BruceKe365/STM32F411-PPG-Pulse-Monitor/Reports/总体完成进度（2026.6.23定稿）.md

# 总体完成进度（2026.6.23定稿）

## 给下一个 AI 的快速接手版

项目根目录示例是：

```text
<repo-root>
```

新接手时请先读：

```text
AI助手接手？先读我.md
```

它是根目录总入口，负责说明项目结构、当前状态、关键脚本、数据目录、常用命令和不要乱动的边界。本文件继续作为详细进度存档保留。当前最新同步是下面的 `0C. 2026-06-29 固件参数一致性同步`；具体以 `AI助手接手？先读我.md` 与当前源码、模型和 `full_*_20260629_current` 报告为准。

### 0. 2026-06-09 当前接手状态

当前固件主文件：

```text
Core/Src/main.c
Core/Src/i2c.c
```

后文包含大量历史调参记录；如果旧段落与最新同步冲突，以 `0C. 2026-06-29 固件参数一致性同步`、当前源码和当前脚本为准。

### 0C. 2026-06-29 固件参数一致性同步

这是当前项目最终验收入口。固件行为仍以 2026-06-17 编译的 `main.c`/ELF 为准；2026-06-29 已按固件实际参数重建 Stress 模型并重跑 AF、Stress 验证，纠正旧报告配置与固件不一致的问题。当前模型和报告目录统一使用 `full_*_20260629_current`。

#### 最终验收状态

- 当前版本正式作为验收定稿版本。
- 最终固件源码：`Core/Src/main.c`。
- 最终 ELF：`build/Debug/STM32_F411_Test.elf`。
- 最终功能：HR、SpO2、0.96 寸主屏、0.91 寸 PPG 波形、AF live、Stress、AF test、USB CDC raw/PPG_PROC。
- 最终显示顺序：`HR/SpO2 -> AF live -> STRESS -> AF test -> HR/SpO2`。
- 最终烧录方法：DAPLink + OpenOCD + SWD，目标文件为上述 ELF。
- 最近一次烧录已成功并出现 `Programming Finished`、`Verified OK`、`Resetting Target`。
- 烧录后 COM7 不枚举或打不开时，重插 Black Pill Type-C，不临时修改固件。

#### 最终模型和验证

```text
training_dataset/models/af_nb_model.json
training_dataset/models/af_nb_model.h
training_dataset/models/stress_hrv_model.json
training_dataset/models/stress_hrv_model.h

training_dataset/reports/full_af_validation_20260629_current/
training_dataset/reports/full_stress_live_validation_20260629_current/
training_dataset/reports/full_stress_train_validation_20260629_current/
```

#### 最终关键数据

```text
testing dataset/112_subject_A_pressure_baseline_light_stable_20260617_140429/
testing dataset/113_subject_A_pressure_baseline_light_stable_20260617_141049/
testing dataset/114_subject_B_af_high_review_20260617_144713/
```

#### 验收封版边界

- 不再修改 HR/SpO2 主算法、warmup、心率跳变门限或 OLED 波形。
- 不再修改 AF PPI 门控、20% 上跳保持、10s/30s 刷新或 test PPI。
- 不再修改 Stress 40s 窗口、28 个 PPI、10s/30s 刷新、HR>120 显示门限或模型参数。
- 不再重新训练并覆盖正式 AF/Stress 模型。
- 不再修改、覆盖或重新生成本地采集数据内容；若后续改目录名，必须同步接手文档和数据说明。
- 验收现场只做编译、烧录、接线、串口恢复和功能演示。

#### 验收展示口径

- AF：基于 PPG PPI 不规则性的 AF risk / 不规则心律风险提示，不是房颤确诊。
- Stress：基于 PPG HRV 的 1-99 压力指数，不是情绪类别识别或心理疾病诊断。
- AF/Stress 都是旁路模块，不改变 HR/SpO2 主计算链路。
- 当前项目的价值是“公开数据训练/验证 + PC 等价回放 + STM32 端侧轻量推理 + 双 OLED 实时展示”的完整工程闭环。

### 0B. 2026-06-17 定稿技术同步

这一节是 2026-06-17 的技术基线。旧记录不要删，但如果旧记录和本节冲突，以最前面的 `0C. 2026-06-29 固件参数一致性同步`、`AI助手接手？先读我.md`、当前源码、正式模型和三个 `full_*_20260629_current` 报告为准。

#### 当前项目状态

- 项目已经从 HR/SpO2/OLED 波形显示扩展到两个旁路 AI/算法模块：AF risk 和 Stress index。
- 当前版本可作为阶段定稿版，最近一次烧录成功，OpenOCD 返回 `Programming Finished`、`Verified OK`、`Resetting Target`。
- 烧录后 COM7 有时不会自动重新枚举，重插 Black Pill Type-C 是已知恢复方法。
- 不要为了 AF/Stress 改 HR/SpO2 主算法或 0.91 寸波形归一化；这些是稳定基础功能。

#### 当前显示和串口

按键显示顺序：

```text
HR/SpO2 -> AF live -> STRESS -> AF test -> HR/SpO2
```

当前串口宏：

```text
RAW_STREAM_USB_ENABLE = 1
DIAG_STREAM_USB_ENABLE = 0
PPG_PROC_STREAM_USB_ENABLE = 1
```

含义：

- raw 流输出 `t_ms,red,ir,irq_count,sample_count`。
- `PPG_PROC` 每秒输出处理后诊断字段，包括 HR/SpO2/AF/Stress/PPI 计数和最近 PPI 状态。
- 旧文档里写的 `RAW_STREAM_USB_ENABLE=0`、`DIAG_STREAM_USB_ENABLE=1` 是历史状态。

#### HR/SpO2 当前策略

```text
PPG_HR_WARMUP_SAMPLES = 1500       # 15s
PPG_SPO2_WARMUP_SAMPLES = 2000     # 20s
PPG_AUTOCORR_INTERVAL_SAMPLES = 100 # 约 1s
PPG_HR_CONFIRM_SAMPLES = 3
PPG_HR_CONFIRM_TOLERANCE_BPM = 12
PPG_HR_MAX_DISPLAY_JUMP_BPM = 25
PPG_HR_JUMP_ACCEPT_TIMEOUT_MS = 10000
```

心率首次显示需要 3 个候选一致；显示值使用最近 5 个心率中位数。单次跳变超过 25 bpm 时保持旧值，持续 10s 才接受。血氧 20s warmup 后按滚动 PPG 窗口计算。

#### AF 当前策略

AF 方法：PPG robust peak -> PPI -> HRV/不规则节律特征 -> 离散朴素贝叶斯 -> 0-100% AF risk。

```text
AF_MIN_PPI_COUNT = 20
AF_WINDOW_TARGET_MS = 30000
AF_RISK_FAST_STEP_MS = 10000
AF_RISK_SLOW_STEP_MS = 30000
AF_STABLE_RISK_THRESHOLD_PERCENT = 20
AF_MAX_UP_JUMP_PERCENT = 20
PPG_PPI_QUALITY_MAX_REJECT_PCT = 20
```

当前 live AF 行为：

- 未出值或当前风险 >=20% 时每 10s 尝试更新。
- 当前风险 <20% 后每 30s 尝试更新。
- PPI 异常比例超过 20%、窗口不足、PPI 推算 HR 与当前 HR 差异 >18 bpm 时保持旧值。
- 新风险比旧风险上跳超过 20% 时保持旧值；下降不拦截。
- AF test 只播放内置 AFDB `06995` PPI 段，不使用 live 稳定策略。

#### Stress 当前策略

Stress 方法：PPG robust peak -> PPI -> HRV 特征 -> Logistic Regression -> 1-99 stress index。

```text
STRESS_HRV_MIN_INTERVAL_COUNT = 28
STRESS_HRV_WINDOW_TARGET_MS = 40000
STRESS_HRV_FIRST_STEP_MS = 10000
STRESS_HRV_REFRESH_STEP_MS = 30000
STRESS_HRV_HIGH_HR_BPM = 120
```

当前 Stress 行为：

- 首次未出值时每 10s 尝试更新。
- 出值后每 30s 尝试更新。
- HR >120 bpm 时 STRESS 第二行显示 `-- high HR`，后台仍计算，显示层当作暂无可参考压力值。
- 档位：`1-29 relax`、`30-59 normal`、`60-79 medium`、`80-99 high`。

#### 当前验证报告

优先看这些目录：

```text
training_dataset/reports/full_af_validation_20260629_current/
training_dataset/reports/full_stress_live_validation_20260629_current/
training_dataset/reports/full_stress_train_validation_20260629_current/
```

关键结果：

```text
AF local_ppg normal: valid=33/292, median=0%, mean=3.212%, ge80=3.030%
AF public_nsr2db normal: ge80=0.016%
AF public_afdb normal: ge80=0.279%
AF public_ltafdb normal: ge80=0.685%
AF public_afdb af: ge80=36.892%
AF public_ltafdb af: ge80=45.550%

Stress WESAD all: AUC=0.9267, nonstress_median=50, stress_median=87
Stress WESAD test_by_subject: AUC=0.9157, nonstress_median=51, stress_median=87
Stress local live: files=130, displayed=25/52, display_median=48, display_max=53
```

#### 新增本地数据

```text
testing dataset/112_subject_A_pressure_baseline_light_stable_20260617_140429/
testing dataset/113_subject_A_pressure_baseline_light_stable_20260617_141049/
testing dataset/114_subject_B_af_high_review_20260617_144713/
```

- `112` 和 `113` 是subject_A稳定轻触压力基线。
- `114` 是subject_B AF 偶发高值排查采集，用来验证 PPI 假峰、artifact gate 和 AF jump hold。
- 这些都是本地正常/边界硬件采集，不是真实 AF 阳性样本，也不是压力训练标签数据。

### 0A. 2026-06-16 历史接手同步

这一节是 2026-06-16 的历史同步。旧记录不要删，但如果旧记录和本节冲突，以最前面的 `0C. 2026-06-29 固件参数一致性同步`、`AI助手接手？先读我.md`、当前源码、正式模型和三个 `full_*_20260629_current` 报告为准。

#### 当前项目状态

- 项目已经从单纯 HR/SpO2/OLED 波形显示，扩展到“基于 PPG 峰间期 PPI 的疑似房颤风险原型”。
- HR/SpO2 主算法、小屏 0.91 寸波形显示逻辑仍然是稳定基础功能，后续不要为了 AF 功能去重写它们。
- AF 功能当前已经移植进 `Core/Src/main.c`，是旁路模块：从现有 PPG 峰值/心率/血氧有效状态拿数据，不应反向影响 HR/SpO2。
- 当前固件串口默认仍是诊断 CSV：`RAW_STREAM_USB_ENABLE=0`，`DIAG_STREAM_USB_ENABLE=1`。原始 red/ir 输出代码保留，但需要时才打开。
- 当前 I2C 速率仍应保持：`I2C1=400 kHz` 大屏，`I2C2=400 kHz` 小屏，`I2C3=100 kHz` MAX30102。CubeMX 重新生成后必须复查 `Core/Src/i2c.c`。

#### 当前固件 AF 行为

按键使用 PA0 轮询，不依赖 CubeMX 外部中断。显示模式循环：

1. 默认：大屏显示心率/血氧，小屏显示 Pause/Loading/波形。
2. 按一次：大屏显示实时传感器来源的 `AF %`。
3. 再按一次：大屏显示 `[test]` 和 `AF %`，来源切换为内置 AFDB PPI 测试段。
4. 再按一次：回到心率/血氧显示。

live AF 只在这些条件都满足后才开始收 PPI 并计算：

```text
finger_present != 0
ppg_signal_valid != 0
heart_rate_bpm > 0
spo2_percent > 0
```

当前 MCU 端 AF 参数：

```text
AF_WINDOW_TARGET_MS = 30000
AF_RISK_STEP_MS = 10000
AF_MIN_PPI_COUNT = 20
AF_MAX_PPI_COUNT = 100
AF_LIVE_HR_TOLERANCE_BPM = 18.0
```

也就是说，live 模式需要心率/血氧先稳定，再累计最近约 30 秒 PPI，之后每 10 秒刷新一次风险。若 PPI 窗口推算出的 HR 和当前 HR 差异超过 18 bpm，则显示 `--`。

test 模式内置的是 AFDB `06995` 的一段 AF rhythm PPI/RR 间期，不是写死的 85%。进入 test 后需要按 PPI 间隔播放，窗口满约 30.244 秒后才会计算出约 85% 风险。

#### 当前 Python 脚本职责

根目录 Python 脚本开头已经补了中文说明。快速记忆如下：

| 文件 | 当前用途 |
| --- | --- |
| `scripts/download_af_training_data.py` | 从 PhysioNet 下载最小注释文件，放到 `training_dataset/physionet/`。只下 `.hea/.atr/.qrs/.ecg`，不下大体积 `.dat`。 |
| `scripts/train_af_naive_bayes.py` | 训练 PPI/RR 间期特征的离散朴素贝叶斯 AF 风险模型，导出 JSON 和 C 参数。 |
| `scripts/simulate_af_ppi_risk.py` | 生成正常、轻度不规则、AF-like、早搏样等模拟 PPI，检查模型行为是否符合直觉。 |
| `scripts/validate_mcu_af_live.py` | 最关键的验证脚本。电脑端复刻 MCU live/test AF 逻辑，跑本地 PPG、内置 test 段、公开数据集和质量门控实验。 |
| `scripts/read_max30102_raw.py` | 读取 STM32 USB CDC 原始 MAX30102 red/ir CSV，主要用于 raw 模式采样。 |
| `scripts/read_serial_diagnostics.py` | 读取当前诊断 CSV，检查主循环、采样、OLED、CDC 是否卡顿。 |
| `scripts/build_pulse_report_docx.py` | 项目汇报 Word 生成辅助脚本，和 AF 模型训练/固件运行无直接关系。 |

#### 训练数据和标签口径

数据目录：`training_dataset/physionet/`

| 数据集 | 当前用途 | 标签口径 |
| --- | --- | --- |
| `afdb/1.0.0` | 训练和验证 | `.atr` 节律标注给 AF/normal/mixed，`.qrs` 给 beat time。 |
| `ltafdb/1.0.0` | 训练和验证 | `.atr` 同时提供 beat/rhythm，长时 AF/非 AF 流式验证。 |
| `nsr2db/1.0.0` | 训练和正常验证 | `.ecg` RR 注释，整库按 normal 处理。 |
| `mitdb/1.0.0` | 额外泛化验证，不参与当前训练 | `.atr` 节律/beat 注释，含 AF/normal/other/mixed。 |
| `nsrdb/1.0.0` | 额外正常泛化验证，不参与当前训练 | `.atr` 注释，整库按 normal 处理。 |

重要限制：这些公开 AF 数据主要来自 ECG 标注，但模型只使用 RR/PPI 间期统计，不使用 ECG 波形形态。它验证的是“节律不规则风险”，不能说成医疗级房颤诊断。

#### 当前验证结论

当前模型和 MCU 等价逻辑总体能区分稳定正常和明显 AF-like 不规则：

- 本地正常 PPG：`local_ppg` 有效显示点风险为 0%。
- MCU test 内置 AFDB 06995：约 30.244 秒后风险为 85%。
- 当前 MCU 流式显示报告合并 AFDB/LTAFDB/NSR2DB，按 `risk >= 80%` 看有效显示点：AF 标签 45.146%，normal 标签 0.258%，mixed 标签 7.596%，other 标签 18.981%。
- 同一报告中的原始窗口质量门控基线不是流式显示结果：AF 窗口 95.664%，normal 窗口 0.287%。两种统计不可混用。

质量门控实验已经在 `scripts/validate_mcu_af_live.py --quality-gate-experiment` 里合并，不再需要单独新脚本。当前候选结论：

- 不建议强行缩放或压低 live AF 概率，那会让真实 AF 展示变假。
- 更合理的方向是“质量不可信就显示 `--`”，不是把概率硬改低。
- 候选方案 `outlier_frac_gt18pct`：按全部原始窗口统计，normal 高风险从 0.287% 降到 0.192%，AF 高风险从 95.664% 降到 93.117%。
- 候选方案 `artifact_mild`：normal 高风险为 0.145%，AF 高风险为 92.751%。
- 目前这些质量门控只在电脑端验证过，尚未移植进 MCU。

#### 后续最推荐做的事

1. 不要再随意改 HR/SpO2 和小屏波形。
2. 如果继续优化 AF，优先把电脑端验证过的“质量门控显示 `--`”移植到 MCU，而不是硬压概率。
3. 如果拿到真实 AF 患者 PPG，优先做离线验证，再决定是否重训模型。
4. 对老师展示时说“基于 PPI 不规则性的疑似房颤风险原型”，不要说“确诊房颤”。

当前最重要状态：

- HR/SpO2 核心算法已经阶段性定稿，后续不要轻易改动成熟的心率/血氧计算逻辑，除非用户明确要求。
- 固件当前 HR warmup 是 `1500` 个样本，约 `15s`；SpO2 warmup 是 `2000` 个样本，约 `20s`。
- 心率自相关已经移到后台分片任务 `PPG_AutocorrService()`，不是在 MAX30102 外部中断里做重计算；这样可以减少主循环长时间阻塞。
- 0.91 寸小屏有独立波形/状态模块：无手指且无残留波形显示 `Pause`，有手指但 HR 未稳定时显示 `Loading...` 动画，稳定后显示波形。
- 0.91 寸小屏波形卡顿的核心原因已定位为 OLED I2C 总线速率曾停留在默认 `100 kHz`，不是 HR/SpO2 算法问题。
- 当前 `Core/Src/i2c.c` 生效速率：`I2C1=400000` 给 0.96 寸大屏，`I2C2=400000` 给 0.91 寸小屏，`I2C3=100000` 给 MAX30102。
- CMake 文件不保存外设速率，只编译 `Core/Src/i2c.c`。如果 CubeMX/STM32Cube 插件重新生成代码，必须重新检查三处 `hi2c*.Init.ClockSpeed`。
- 当前 USB CDC 模式是诊断输出：`RAW_STREAM_USB_ENABLE=0`、`DIAG_STREAM_USB_ENABLE=1`。原始 `t_ms,red,ir,irq_count,sample_count` 输出代码仍保留，需要原始数据时再切回 raw 模式。
- 烧录或 OpenOCD reset 后，Windows 的 `COM7` 可能卡住；这已经作为已知现象处理，重新插拔黑丸 Type-C 通常恢复。
- 用户偏好：后续如果修改固件，编译通过后可以直接烧录；但算法开发阶段优先 PC 端脚本/回放，少烧录。
- 后续升级想法：在不改动成熟 HR/SpO2 主算法的前提下，新增独立的“疑似房颤风险筛查”模块。推荐路线是 PC 端用公开数据集训练朴素贝叶斯概率参数，MCU 端基于 PPG 脉搏间期特征做轻量推理，只输出风险提示，不做医学诊断。

当前工程已经验证可用的流程是：先编译，再用 DAPLink + OpenOCD 烧录 `build\Debug\STM32_F411_Test.elf`。

### 1. 编译

```powershell
& '%LOCALAPPDATA%\stm32cube\bundles\cmake\4.3.1+st.1\bin\cmake.exe' --build build\Debug
```

编译成功后应生成：

```text
build\Debug\STM32_F411_Test.elf
```

### 2. 烧录

如果之前开过 OpenOCD/GDB，先关掉：

```powershell
Get-Process openocd,arm-none-eabi-gdb -ErrorAction SilentlyContinue | Stop-Process -Force
```

然后烧录：

```powershell
& 'tools\xpack-openocd-0.12.0-7\bin\openocd.exe' -s 'tools\xpack-openocd-0.12.0-7\openocd\scripts' -f interface\cmsis-dap.cfg -f target\stm32f4x.cfg -c 'adapter speed 1000; program build/Debug/STM32_F411_Test.elf verify reset exit'
```

看到下面几行就表示烧录成功：

```text
** Programming Finished **
** Verified OK **
** Resetting Target **
```

### 3. 观察调试输出

当前代码支持通过 DAPLink/OpenOCD semihosting 看低频调试输出：

```powershell
& 'tools\xpack-openocd-0.12.0-7\bin\openocd.exe' -s 'tools\xpack-openocd-0.12.0-7\openocd\scripts' -f interface\cmsis-dap.cfg -f target\stm32f4x.cfg -c 'adapter speed 1000; init; arm semihosting enable; reset run; sleep 14000; shutdown'
```

注意：semihosting 只适合低频日志。后续要采集 MAX30102 原始 red/ir 数据，应改用 USB CDC 虚拟串口输出 CSV，再用 MATLAB 读取。

## 当前推荐连接方式：DAPLink 烧录 + Type-C 串口数据

后续建议使用“两条 USB 链路”：

1. DAPLink 只负责 SWD 烧录/调试。
2. 黑丸自身 Type-C 负责给板子供电，并通过 USB CDC 虚拟串口向电脑输出数据。

当前已验证的接法：

| 连接 | 当前状态 |
| --- | --- |
| DAPLink `GND` -> 黑丸 `GND` | 已验证可用 |
| DAPLink `CK/TCK` -> 黑丸 `SCK/SWCLK` | 已验证可用 |
| DAPLink `IO/TMS` -> 黑丸 `DIO/SWDIO` | 已验证可用 |
| DAPLink `3V3` -> 黑丸 `3V3` | 当前不接 |
| 黑丸 Type-C -> 电脑 USB | 当前用于供电 + USB CDC 数据传输 |

重要结论：

- DAPLink 断开 `3V3`，只接 `GND`、`SWCLK`、`SWDIO` 三根线时，OpenOCD 仍能识别 STM32F411。
- 在这种三线 SWD 接法下，已经重新烧录并 `Verified OK`。
- 黑丸 Type-C 直连电脑后，USB CDC 枚举为 `COM7`。
- 当前程序已经能通过 `COM7` 输出文本数据。

已验证的 OpenOCD 结果：

```text
CMSIS-DAP: Interface Initialised (SWD)
SWD DPIDR 0x2ba01477
[stm32f4x.cpu] Cortex-M4 r0p1 processor detected
** Programming Finished **
** Verified OK **
```

已验证的串口信息：

```text
VID_0483&PID_5740
USB 串行设备 (COM7)
```

当前 `COM7` 能读到的程序输出示例：

```text
PPG finger=0 valid=0 red=353 ir=307 amp=0 hr=-1 spo2=-1 irq=12766 samples=16023
PPG finger=1 valid=0 red=57582 ir=66443 amp=113 hr=94 spo2=-1 irq=13477 samples=16923
PPG finger=0 valid=0 red=522 ir=420 amp=0 hr=-1 spo2=-1 irq=13557 samples=17023
```

注意：

- 这说明 USB CDC 链路已经通了。
- 当前输出还是调试日志格式，不适合 MATLAB 长时间读取和解析。
- 后续应改成干净 CSV 格式。

推荐后续 CSV 格式：

```text
t_ms,red,ir
12345,57582,66443
```

如果还需要保留状态字段，可用扩展格式：

```text
t_ms,red,ir,amp,finger,valid,hr,spo2,irq_count,sample_count
12345,57582,66443,113,1,0,94,-1,13477,16923
```

MATLAB 侧应优先打开：

```text
COM7
```

波特率对 USB CDC 通常不是实际物理速率，但为了兼容串口 API，建议先用：

```text
115200, 8N1
```

### 拓展坞影响记录

之前黑丸 Type-C 通过拓展坞连接电脑时，能看到 `COM7` 枚举，但打开/读取不稳定，出现过：

```text
Device COM7 is not currently available.
```

改成黑丸 Type-C 直连电脑后：

- `mode COM7` 正常返回状态。
- PowerShell 能打开 `COM7`。
- 能读到 `PPG ...` 文本输出。

因此后续采集 MAX30102 高频原始数据时，建议：

- 黑丸 Type-C 尽量直连电脑，不要走拓展坞。
- DAPLink 可以接电脑或拓展坞，用于烧录/调试。
- 不要同时让 DAPLink `3V3` 和黑丸 Type-C 给板子供电。

## 硬件和引脚配置详细交接

### 核心板与供电/下载

| 项目 | 当前状态 |
| --- | --- |
| 核心板 | STM32F411CEU6 黑丸核心板 |
| 外部晶振 | HSE 25 MHz |
| 系统主频 | SYSCLK 96 MHz |
| USB 时钟 | 48 MHz |
| 下载/调试 | DAPLink，SWD 模式 |
| BOOT0 | 正常运行/烧录时保持普通启动状态，不需要按 BOOT0 |
| NRST | 复位键，需要时短按即可 |
| KEY | 当前项目未使用 |

### DAPLink 到黑丸 SWD 接线

| DAPLink 引脚 | 黑丸引脚 | 说明 |
| --- | --- | --- |
| `CK/TCK` | `SCK` / `SWCLK` | SWD 时钟 |
| `IO/TMS` | `DIO` / `SWDIO` | SWD 数据 |
| `GND` | `GND` | 必须共地 |
| `3V3` | `3V3` | 当前不接；黑丸 Type-C 负责供电 + USB CDC |

当前已经验证：DAPLink 可以识别目标芯片，可以烧录和 verify。OpenOCD 日志里能看到 `Cortex-M4`、`flash size = 512 KiB`、`Verified OK`。

### I2C 与传感器/OLED 接线

| 外设 | STM32 外设 | SCL | SDA | 7-bit 地址 | 备注 |
| --- | --- | --- | --- | --- | --- |
| 0.96 寸 SSD1306 OLED | I2C1 | `PB6` | `PB7` | `0x3C` | 128x64，供电 3.3V，模块自带上拉 |
| 0.91 寸 SSD1306 OLED | I2C2 | `PB10` | `PB3` | `0x3C` | 128x32，供电 3.3V，模块自带上拉 |
| MAX30102 | I2C3 | `PA8` | `PB4` | `0x57` | 供电 3.3V，模块自带上拉 |

CubeMX/HAL 当前 I2C 配置：

| 外设 | 速率 | 地址模式 | GPIO 模式 |
| --- | --- | --- | --- |
| I2C1 | 400 kHz | 7-bit | AF Open-Drain |
| I2C2 | 400 kHz | 7-bit | AF Open-Drain |
| I2C3 | 100 kHz | 7-bit | AF Open-Drain |

重要速率记忆：

- `I2C1` 是 0.96 寸 128x64 SSD1306 大屏，当前必须保持 `400 kHz`，否则大屏整屏刷新会明显拖慢主循环。
- `I2C2` 是 0.91 寸 128x32 SSD1306 小屏，当前必须保持 `400 kHz`，否则心率波形会出现走一段、顿一下的卡顿。
- `I2C3` 是 MAX30102，当前仍保持 `100 kHz`，不要为了屏幕刷新把传感器总线一起改掉。
- 当前 CMake 文件不保存这些外设速率。实际生效位置是 `Core/Src/i2c.c` 里的 `hi2c1.Init.ClockSpeed`、`hi2c2.Init.ClockSpeed`、`hi2c3.Init.ClockSpeed`。
- `cmake/stm32cubemx/CMakeLists.txt` 只是把 `Core/Src/i2c.c` 加入编译；如果以后 CubeMX 或 STM32Cube 插件重新生成 `i2c.c`，必须重新确认 `I2C1/I2C2=400000`、`I2C3=100000`。

注意：HAL 的 I2C API 使用地址时需要左移一位，例如 MAX30102 `0x57 << 1`，SSD1306 `0x3C << 1`。

### MAX30102 中断引脚

| MAX30102 引脚 | STM32 引脚 | CubeMX 配置 | 说明 |
| --- | --- | --- | --- |
| `INT` | `PB5` | `GPIO_MODE_IT_FALLING` + `GPIO_PULLUP` | FIFO/PPG 数据准备好时传感器拉低，走 EXTI9_5 中断 |

代码里 `HAL_GPIO_EXTI_Callback(GPIO_PIN_5)` 会置位 `max30102_int_pending`，主循环里再调用 `MAX30102_Service()` 读取 FIFO。当前已验证 `irq` 计数会增长，说明 PB5 中断链路是通的。

### USB CDC

| 引脚/外设 | 当前状态 |
| --- | --- |
| USB FS DM | `PA11` |
| USB FS DP | `PA12` |
| USB_DEVICE | CDC FS 已启用 |
| 用途 | 后续计划输出 MAX30102 原始 red/ir CSV 数据到电脑 |

当前项目里 `CDC_Printf()` 同时会尝试走 USB CDC 和 semihosting。没有连接黑丸 Type-C 时，仍可通过 DAPLink semihosting 看低频日志。后续做 MATLAB 原始数据采集时，应连接黑丸 Type-C，让电脑识别 USB CDC 虚拟串口。

### SWD 保留引脚

| STM32 引脚 | 用途 |
| --- | --- |
| `PA13` | SWDIO |
| `PA14` | SWCLK |

不要把 `PA13/PA14` 改作普通 GPIO，否则 DAPLink 调试/烧录会受影响。

### 当前 MAX30102 寄存器配置

代码位置：`Core/Src/main.c` 的 `MAX30102_InitSensor()`。

| 寄存器 | 当前写入值 | 作用 |
| --- | --- | --- |
| `MODE_CONFIG` | `0x40` 后等待清零 | 软复位 |
| `INTR_ENABLE_1` | `0x40` | 开启 PPG_RDY 中断 |
| `INTR_ENABLE_2` | `0x00` | 关闭第二组中断 |
| `FIFO_CONFIG` | `0x10` | sample average = 1，FIFO rollover enabled |
| `SPO2_CONFIG` | `0x47` | 当前 SpO2/ADC/采样配置，目标约 100 Hz |
| `LED1_PA` | `0x24` | 红光 LED 电流 |
| `LED2_PA` | `0x24` | 红外 LED 电流 |
| `PILOT_PA` | `0x1F` | Pilot LED 电流 |
| `MODE_CONFIG` | `0x03` | SpO2 mode，红光 + 红外 |

这些参数不是最终算法参数。当前更建议先把原始 red/ir 数据导出到 MATLAB 观察，再决定 LED 电流、ADC 量程、滤波和峰值检测阈值。

### 当前代码模块概览

| 文件 | 当前作用 |
| --- | --- |
| `Core/Src/main.c` | I2C 扫描、OLED 驱动、MAX30102 初始化/读取、PPG 初版算法、semihosting/CDC 输出 |
| `Core/Src/i2c.c` | CubeMX 生成的 I2C1/I2C2/I2C3 初始化 |
| `Core/Src/gpio.c` | PB5 EXTI 下降沿中断配置 |
| `USB_DEVICE/App/usbd_cdc_if.c` | USB CDC 接口，已加过端口打开判断和空指针保护 |
| `.vscode/launch.json` | Cortex-Debug + DAPLink/OpenOCD 调试配置 |

## 项目与硬件状态

- 主控：STM32F411CEU6 黑丸核心板。
- 工程目录：clone 后的仓库根目录 `<repo-root>`
- 开发环境：VS Code + STM32Cube for VS Code 插件 + CMake/Ninja + GNU Arm 工具链。
- HSE：25 MHz。
- SYSCLK：96 MHz。
- USB 时钟：48 MHz。
- 调试/烧录器：DAPLink，走 SWD。
- 当前主要代码文件：`Core/Src/main.c`
- USB CDC 相关文件：`USB_DEVICE/App/usbd_cdc_if.c`

## 外设连接

- I2C1 `PB6/PB7`：0.96 寸 SSD1306 OLED，地址 `0x3C`。
- I2C2 `PB10/PB3`：0.91 寸 SSD1306 OLED，地址 `0x3C`。
- I2C3 `PA8/PB4`：MAX30102，地址 `0x57`。
- PB5：MAX30102 `INT` 引脚，下降沿触发，内部上拉。
- SWD：
  - DAPLink `CK/TCK` -> 黑丸 `SCK/SWCLK`
  - DAPLink `IO/TMS` -> 黑丸 `DIO/SWDIO`
  - DAPLink `GND` -> 黑丸 `GND`
  - DAPLink `3V3` -> 黑丸 `3V3`
- 使用 DAPLink/SWD 烧录时，BOOT0 保持正常启动模式即可，不需要进入系统 Bootloader。

## 今天已搞定的编译与烧录流程

### 1. 编译

使用 STM32Cube 插件 Bundles Manager 里的 CMake：

```powershell
& '%LOCALAPPDATA%\stm32cube\bundles\cmake\4.3.1+st.1\bin\cmake.exe' --build build\Debug
```

编译成功后生成：

```text
build\Debug\STM32_F411_Test.elf
```

`.elf` 是正确产物，DAPLink + OpenOCD 可以直接烧录这个 ELF。

### 2. OpenOCD 路径

项目里已经放好了 xPack OpenOCD：

```text
tools\xpack-openocd-0.12.0-7\bin\openocd.exe
tools\xpack-openocd-0.12.0-7\openocd\scripts
```

### 3. 烧录前先关掉旧的 OpenOCD/GDB

如果之前开过调试或观察窗口，先执行：

```powershell
Get-Process openocd,arm-none-eabi-gdb -ErrorAction SilentlyContinue | Stop-Process -Force
```

这个命令如果没有找到进程，返回非 0 也没关系。

### 4. DAPLink 烧录命令

```powershell
& 'tools\xpack-openocd-0.12.0-7\bin\openocd.exe' -s 'tools\xpack-openocd-0.12.0-7\openocd\scripts' -f interface\cmsis-dap.cfg -f target\stm32f4x.cfg -c 'adapter speed 1000; program build/Debug/STM32_F411_Test.elf verify reset exit'
```

成功标志：

```text
** Programming Finished **
** Verified OK **
** Resetting Target **
```

### 5. 通过 DAPLink/OpenOCD 观察 semihosting 输出

当前代码里 `CDC_Printf()` 同时会走 semihosting，所以不用接目标板 Type-C，也能通过 DAPLink/OpenOCD 看到调试输出。

```powershell
& 'tools\xpack-openocd-0.12.0-7\bin\openocd.exe' -s 'tools\xpack-openocd-0.12.0-7\openocd\scripts' -f interface\cmsis-dap.cfg -f target\stm32f4x.cfg -c 'adapter speed 1000; init; arm semihosting enable; reset run; sleep 14000; shutdown'
```

注意：semihosting 适合低频调试信息，不适合长时间高频传感器原始数据流。后续要做高频原始数据采集，应该改成 USB CDC 虚拟串口或指定硬件 USART。

## VS Code 调试配置

当前 `.vscode/launch.json` 已配置 DAPLink + OpenOCD，大致用途是让 Cortex-Debug 通过 OpenOCD 调试/下载 ELF。

关键配置：

- `servertype`: `openocd`
- `configFiles`:
  - `interface/cmsis-dap.cfg`
  - `target/stm32f4x.cfg`
- `executable`: `build/Debug/STM32_F411_Test.elf`
- `gdbPath`:

```text
${env:LOCALAPPDATA}/stm32cube/bundles/gnu-tools-for-stm32/14.3.1+st.2/bin/arm-none-eabi-gdb.exe
```

如果 VS Code 图形界面调试按钮不好用，可以优先使用上面的 PowerShell 编译/烧录命令。

## 当前功能进展

已经实现过的内容：

- 启动时扫描 I2C1/I2C2/I2C3。
- 已确认设备地址：
  - I2C1 OLED：`0x3C`
  - I2C2 OLED：`0x3C`
  - I2C3 MAX30102：`0x57`
- 两块 OLED 可以初始化和显示内容。
- 128x64 OLED 当前用于显示 `bpm:` 和 `SpO2:`，原右上角心形图标已删除。
- MAX30102 初始化成功。
- PB5 硬件中断已工作，日志里 `irq` 会持续增长。
- MAX30102 FIFO 样本读取已工作，日志里 `samples` 会持续增长。
- 当前日志格式示例：

```text
PPG finger=0 valid=0 red=391 ir=305 amp=0 hr=-1 spo2=-1 irq=3 samples=8
```

## 当前遗留问题

MAX30102 的心率/血氧算法仍不稳定。

已遇到两类问题：

- 阈值太低时：没有手指也可能被环境反射或噪声误判，OLED 会错误显示心率血氧。
- 阈值太高时：手指放上去后一直不显示心率和血氧。

当前代码已经加了：

- `finger_present`：判断是否可能有手指。
- `ppg_signal_valid`：判断是否有可信 PPG 波形。
- 只有 `finger_present == 1` 且 `ppg_signal_valid == 1` 时才显示心率血氧。

但实际表现仍然需要重新调参，当前用户反馈是：手指放上去一直不显示，说明有效波形门槛可能又调得偏高。

## 明天/后续开发思路

下一步不要急着在单片机上继续盲调心率和血氧算法。

建议路线：

1. 让 STM32 只负责稳定读取 MAX30102 FIFO 原始数据。
2. 通过串口持续输出原始数据到电脑。
3. 在电脑端用 MATLAB 读取/保存/画图/调算法。
4. 先在 MATLAB 里确定滤波、峰值检测、阈值、SpO2 ratio 参数。
5. 参数稳定后，再把算法移植回 STM32。

推荐先输出 CSV 格式：

```text
t_ms,red,ir,irq_count,sample_count
12345,60123,70456,100,1000
```

如果还要带当前 MCU 算法状态，可以扩展为：

```text
t_ms,red,ir,amp,finger,valid,hr,spo2,irq_count,sample_count
```

## 串口输出方案建议

优先方案：USB CDC 虚拟串口。

- 优点：速率高，适合输出 MAX30102 原始 red/ir 数据流。
- 需要连接黑丸自身 Type-C 到电脑。
- MATLAB 可以通过串口对象读取。

备选方案：硬件 USART。

- 需要后续指定 TX/RX 引脚和 USB-TTL 模块。
- 当前硬件连接信息里还没有指定 USART 引脚。

不推荐用 semihosting 做高频数据流：

- semihosting 依赖调试器，速度慢。
- 适合启动日志、I2C 扫描、少量状态输出。
- 不适合 100 Hz 原始 PPG 数据长期采集。

## 明天建议先做的代码改动

1. 暂时弱化或关闭 OLED 心率/血氧算法显示。
2. 保留 OLED 显示基本状态，比如：
   - MAX30102 OK
   - Streaming
   - sample count
3. 在 `MAX30102_Service()` 中每读到一个样本，就通过 USB CDC 输出 CSV。
4. 控制输出频率：
   - MAX30102 当前配置约 100 Hz。
   - 每个样本输出一行 CSV。
5. MATLAB 侧先画：
   - raw IR
   - raw RED
   - 去 DC 后 AC 波形
   - 滤波后波形
   - 检测到的峰值点

## 对后续 AI 的提示

如果后续新建对话，请先阅读本文件。

本项目目前最关键的不是继续猜阈值，而是先把 MAX30102 原始数据稳定导出到 PC，在 MATLAB 中观察真实波形后再调参。编译和烧录已经验证可用，优先使用本文档中的 PowerShell 命令。

## 2026-05-27 晚间追加：切换为 PC 端原始数据处理路线

### 固件改动

`Core/Src/main.c` 已改为：

- Type-C USB CDC 只输出 MAX30102 原始 CSV 数据。
- CSV 格式：

```text
t_ms,red,ir,irq_count,sample_count
12345,57582,66443,13477,16923
```

- 原来的 I2C 扫描、MAX30102 初始化、PPG 状态日志仍保留，但默认只走 OpenOCD semihosting，不再混入 Type-C 串口数据。
- `MAX30102_Service()` 当前只读 FIFO 原始 red/ir 并输出，不再调用 MCU 端 `PPG_ProcessSample()` 做心率/血氧算法处理。
- 编译已通过：

```text
[1/2] Building C object CMakeFiles/STM32_F411_Test.dir/Core/Src/main.c.obj
[2/2] Linking C executable STM32_F411_Test.elf
```

- 新固件已经烧录并 `Verified OK`。

### PC 端 Python 脚本

项目根目录新增：

```text
scripts/read_max30102_raw.py
```

用途：

- 自动或手动打开 STM32 USB CDC 串口。
- 读取 `t_ms,red,ir,irq_count,sample_count` CSV。
- 保存原始数据到 `ppg_raw_YYYYMMDD_HHMMSS.csv`。
- 用滚动窗口做初版 PC 端心率/血氧估算，参数可通过命令行调。

推荐运行：

```powershell
python scripts/read_max30102_raw.py --port COM7
```

短时间测试：

```powershell
python scripts/read_max30102_raw.py --port COM7 --duration 20 --csv ppg_raw_test.csv
```

已安装 Python 依赖：

```powershell
python -m pip install pyserial
```

脚本参数可查看：

```powershell
python scripts/read_max30102_raw.py --help
```

### VS Code / MATLAB 状态

当前 VS Code 已安装 Python、Pylance、Jupyter 等扩展，但未安装 MATLAB 相关扩展。

短期建议先用 Python 采集和调参；如果后续要在 VS Code 里写 MATLAB，可再安装 MathWorks 的 MATLAB 扩展。

### 当前注意事项

烧录新固件后，Windows 仍枚举到：

```text
COM6: DAPLink, VID_0D28&PID_0204
COM7: STM32 USB CDC, VID_0483&PID_5740
```

但一次脚本读取测试时，`COM7` 打开动作出现卡住，`ppg_raw_test.csv` 为空。OpenOCD semihosting 验证新固件仍能启动、扫描 I2C、初始化 MAX30102，并继续读到样本。

如果再次遇到 `COM7` 打不开或卡住，优先处理：

- 关闭 VS Code Serial Monitor、MATLAB、串口助手等可能占用 `COM7` 的程序。
- 重新插拔黑丸 Type-C，尽量直连电脑，不走拓展坞。
- 确认 `COM7` 仍是 `VID_0483&PID_5740`。

### 进一步修复和验证记录

发现一个 CDC 状态问题：

- 之前 `CDC_SET_CONTROL_LINE_STATE` 不区分主机打开/关闭端口，收到一次控制请求后就永久把 `cdc_port_open_fs` 置为 1。
- 这会导致 Python 脚本退出后，MCU 仍可能认为端口打开并持续向 USB CDC 发送数据。
- 已修复为读取 CDC 请求里的 DTR 位：DTR=1 才认为端口打开，DTR=0 则停止发送。
- Python 脚本退出时也会主动拉低 DTR/RTS，再关闭串口。

新增可见固件标记：

```text
FW_TAG=RAW_CSV_DTR_V2
```

0.91 寸 OLED 启动文本改为：

```text
raw v2
```

已重新编译、烧录并 verify：

```text
** Programming Finished **
** Verified OK **
```

OpenOCD semihosting 已验证目标板实际运行新固件，输出包含：

```text
FW_TAG=RAW_CSV_DTR_V2
I2C1 OLED 0.96 SSD1306 @0x3C: OK
I2C2 OLED 0.91 SSD1306 @0x3C: OK
I2C3 MAX30102 @0x57: OK
MAX30102 init: OK
```

连续运行 Python 脚本两次验证通过，不需要重新拔插：

```powershell
python scripts/read_max30102_raw.py --port COM7 --duration 6 --csv ppg_raw_repeat1.csv
python scripts/read_max30102_raw.py --port COM7 --duration 6 --csv ppg_raw_repeat2.csv
```

两次结果：

| 文件 | 样本数 | 最终采样率 | 结论 |
| --- | ---: | ---: | --- |
| `ppg_raw_repeat1.csv` | 601 | 100.05 Hz | 正常 |
| `ppg_raw_repeat2.csv` | 601 | 100.05 Hz | 正常 |

同时生成：

```text
ppg_raw_repeat1_processed.csv
ppg_raw_repeat1_summary.json
ppg_raw_repeat2_processed.csv
ppg_raw_repeat2_summary.json
```

测试时未放手指，因此 summary 中：

```text
finger_present=false
hr_bpm=null
spo2=null
```

这是符合预期的。

## 2026-05-28 凌晨追加：PC 端 MAX30102 算法调试阶段归档

### 今日阶段性结论

今天的核心工作已经完成：STM32 暂时只作为 MAX30102 原始数据透明传输工具，PC 端 `scripts/read_max30102_raw.py` 负责读取、保存、重放、滤波、手指检测、心率估算、血氧估算和质量判断。

当前算法已经通过多组真实采集数据验证，阶段性可用：

- 无手指：HR 和 SpO2 都保持 `--`，不会误显示。
- 轻轻放置/轻按：信号质量最好，HR 与手表接近，SpO2 稳定在约 `97.8%-98.1%`。
- 用力按压：HR 仍可参考，但 SpO2 不可信，算法会显示 `--`。
- 无手指 -> 放上手指：先保持 `--`，检测到手指后等待约 `20s` warmup，再稳定显示。
- 有手指 -> 拿开手指：拿开后立即回到 `--`，没有残留显示。

完整实验数据已经整理到：

```text
testing dataset
```

后续阅读者应优先查看：

```text
testing dataset\本地采集数据集说明.md
```

该说明文档已经按测试场景建立索引。每个主采集组通常包含：

```text
raw.csv
processed.csv
summary.json
events.csv
```

含义：

- `raw.csv`：STM32 USB CDC 输出的 MAX30102 原始数据。
- `processed.csv`：Python 端逐样本处理结果。
- `summary.json`：本轮统计结果、最终值、算法参数。
- `events.csv`：人工事件标记，例如放上手指、拿开手指。

### 当前 Python 算法状态

主要脚本：

```text
scripts/read_max30102_raw.py
```

当前关键能力：

- 实时串口采集：`--port COM7`
- 离线重放：`--input-csv`
- 原始数据保存：`--csv`
- 处理结果保存：`--processed-csv`
- 统计摘要保存：`--summary-json`
- 事件标记保存：`--event-csv`
- 实验标签：`--label`
- 实验备注：`--notes`
- 事件输入：`--event 0:no_finger`

当前关键参数：

| 参数 | 当前值 | 说明 |
| --- | ---: | --- |
| `window` | `10s` | 滚动分析窗口 |
| `warmup` | `20s` | 检测到手指后等待滤波稳定 |
| `dc_alpha` | `0.02` | DC 跟踪 IIR 系数 |
| `filt_alpha` | `0.20` | 去 DC 后低通 IIR 系数 |
| `min_ac_rms` | `10.0` | 手指/PPG AC 下限 |
| `min_spo2_score` | `4.0` | SpO2 输出质量分数门限 |
| `min_peak_ms` | `300ms` | 峰值/自相关搜索最高约 `200 bpm`，但最终显示会用 `45-190 bpm` 有效范围拦截假 `200` |
| `max_peak_ms` | `1200ms` | 最低支持约 `50 bpm` |

当前 HR 算法：

- 主输出使用 IR 滤波波形自相关估计。
- 使用最近自相关结果的中位数平滑。
- 自相关暂时失败时优先沿用历史中位数，减少峰值法瞬时误跳。
- 合成波形已验证 `60/75/90/150/160/180 bpm` 均可识别。
- 当前 HR 范围不是只适合 `80-100 bpm`；峰值/自相关搜索约覆盖 `50-200 bpm`，最终显示门限为 `45-190 bpm`。

当前 SpO2 算法：

```text
ratio = (red_rms / red_dc) / (ir_rms / ir_dc)
SpO2 = 101.0 - 7.0 * ratio
```

SpO2 输出条件：

- `0.40 <= ratio <= 0.85`
- `finger_score >= 4.0`

强按、低灌注或低质量数据即使能算出 HR，也不显示 SpO2，而是显示 `--`。

### 今日关键测试记录

#### 1. 无手指基线

目录：

```text
testing dataset\01_无手指基线
```

结论：

- 无手指不会误判。
- HR 为 `--`。
- SpO2 为 `--`。

#### 2. 稳定放置与早期调参

相关目录：

```text
testing dataset\02_手指稳定初测
testing dataset\03_手指稳定心率调参
testing dataset\04_延迟接触预热测试
testing dataset\05_稳定心率良好参考
```

结论：

- 早期数据暴露了 warmup、峰值间隔、SpO2 公式和质量门限问题。
- `04_延迟接触预热测试` 证明 warmup 必须从“检测到手指”开始，而不是从脚本启动开始。
- `05_稳定心率良好参考` 是 HR 表现较好的稳定参考组。

#### 3. 用力按压测试

相关目录：

```text
testing dataset\06_强按低质量血氧空白
testing dataset\09_强按血氧空白复核
```

结论：

- 用力按压会压迫局部血流并改变光路，SpO2 ratio 会失真。
- 这种状态下 HR 仍可能有参考价值。
- SpO2 应显示 `--`，不能硬算。
- 加入 `min_spo2_score=4.0` 后，强按数据的 SpO2 漏显示问题已解决。

#### 4. SpO2 标定

目录：

```text
testing dataset\07_手表97血氧参考
```

该组手表参考 SpO2 约 `97%`，用于经验标定。后续结合轻放多组数据，最终把 SpO2 显示值统一上移 `+1%`，当前公式为：

```text
SpO2 = 101.0 - 7.0 * ratio
```

#### 5. 轻放/轻按最佳状态

相关目录：

```text
testing dataset\08_轻触首次良好数据
testing dataset\10_轻触最佳稳定参考
testing dataset\11_轻触重复确认
testing dataset\12_轻触最终检查
```

轻轻放置是目前最佳采集状态。

`12_轻触最终检查` 结果：

| 指标 | 全部有效段 | 最近 30 秒 | 最近 10 秒 |
| --- | ---: | ---: | ---: |
| HR | 平均 `87.42` | 平均 `86.84` | 平均 `93.72` |
| SpO2 | 平均 `97.91%` | 平均 `97.94%` | 平均 `97.95%` |
| 质量分数 | 平均 `6.46` | 平均 `6.49` | 平均 `6.63` |

结论：

- SpO2 稳定在约 `97.8%-98.0%`。
- HR 与用户手表结果接近。
- 后续设备使用时应引导用户轻放，不要用力按压。

#### 6. 无手指开始，随后放上手指

目录：

```text
testing dataset\13_无手指再放上预热
```

测试流程：

1. 开始不放手指。
2. 约 `20s` 后提示用户轻放手指。
3. 继续采集，观察算法是否先空白、后稳定显示。

结果：

- 开始无手指阶段：`3134` 行数据，`finger_present=0`。
- 无手指阶段 HR/SpO2 全部为 `--`。
- 约 `31.34s` 检测到手指。
- 约 `51.15s` 开始稳定输出 HR/SpO2。
- 从检测到手指到稳定出数约 `20s`，符合 warmup 设计。
- 稳定阶段 HR 平均 `84.23 bpm`。
- 稳定阶段 SpO2 平均 `97.80%`。
- 最后 10 秒 HR 平均 `85.29 bpm`，SpO2 平均 `97.91%`。

结论：

- 无手指时不会误显示。
- 放上手指后不会立刻乱出数。
- warmup 后显示稳定。

#### 7. 轻放开始，随后拿开手指

目录：

```text
testing dataset\14_测量中移开手指
```

测试流程：

1. 开始轻放手指。
2. 稳定出数后提示用户拿开手指。
3. 继续采集，观察是否及时回到 `--`。

结果：

- 开始约 `6.89s` 检测到手指。
- 约 `26.70s` 开始稳定出数。
- 有手指稳定阶段 HR：`75.95 - 90.91 bpm`，平均 `81.29 bpm`。
- 有手指稳定阶段 SpO2 平均 `98.06%`。
- 拿开手指后约 `59.00s` 开始 `finger=no`。
- 拿开后 `1603` 行数据，HR/SpO2 全部为 `--`。
- 最终状态：`finger_present=false`，HR/SpO2 均为 `null`。

结论：

- 拿开手指后没有残留显示。
- 算法能立即回到空白状态。

### 数据集目录索引

当前 `testing dataset\本地采集数据集说明.md` 已记录：

| 目录 | 用途 |
| --- | --- |
| `00_串口烟测与原始数据检查` | 串口/原始数据链路验证 |
| `01_无手指基线` | 无手指基线 |
| `02_手指稳定初测` | 初始稳定手指数据 |
| `03_手指稳定心率调参` | HR 参数调试 |
| `04_延迟接触预热测试` | 手指延迟放置与 warmup 修正 |
| `05_稳定心率良好参考` | 稳定 HR 参考 |
| `06_强按低质量血氧空白` | 强按低质量，SpO2 应空白 |
| `07_手表97血氧参考` | 手表 97% SpO2 参考 |
| `08_轻触首次良好数据` | 第一组轻放良好数据 |
| `09_强按血氧空白复核` | 强按确认，SpO2 空白 |
| `10_轻触最佳稳定参考` | 最佳轻放稳定组 |
| `11_轻触重复确认` | 轻放重复确认 |
| `12_轻触最终检查` | 轻放最终确认 |
| `13_无手指再放上预热` | 无手指到放上手指 |
| `14_测量中移开手指` | 有手指到拿开手指 |
| `90_当前算法回放验证` | 当前算法基础重放 |
| `91_血氧质量门控回放验证` | SpO2 质量门限验证 |
| `92_心率范围和血氧加1回放` | HR 范围拓宽和 SpO2 +1% 验证 |

### 下一步计划：Python 算法移植到 STM32 C 程序

下一阶段目标是把当前 Python 端已验证的算法转换为 C 代码，移植回 STM32，并烧录到单片机里运行。

建议步骤：

1. 先冻结一版 Python 算法参数和流程。
2. 把 Python 中的 `PPGEstimator` 逻辑拆成 C 端模块，例如：
   - `ppg_estimator_init()`
   - `ppg_estimator_update(red, ir, sample_count)`
   - `ppg_estimator_get_result()`
3. 在 C 端实现：
   - DC IIR 跟踪
   - 去 DC 后低通
   - 滚动 RMS
   - 手指检测
   - warmup 计时
   - 自相关 HR 估计
   - SpO2 ratio 和质量门限
4. 先在 STM32 上继续通过 USB CDC 输出 C 端计算结果，与 PC Python 重放结果对照。
5. 确认 C 端结果与 Python 端一致后，再接入 OLED 显示。
6. OLED 显示策略建议：
   - 无手指显示 `--`
   - 检测到手指后等待约 `20s`
   - HR 可以较快更新，但要做中位数/窗口平滑
   - SpO2 不要频繁刷新，建议每 `30-60s` 更新一次
   - SpO2 质量不足时显示 `--`

重要提醒：

- 移植时不要一开始就删掉 USB CDC 原始输出。
- 建议保留一个调试模式，让 MCU 同时输出 raw red/ir 和 C 端结果，便于继续和 Python 对照。
- SpO2 比 HR 更依赖稳定接触，强按或信号质量差时显示 `--` 是正确行为。

### 当前阶段判断

今天 PC 端算法调试可以认为阶段性完成。下一步重点不再是继续盲目采集轻放数据，而是把这套已验证算法工程化：先 Python -> C，再 STM32 串口对照验证，最后接入 OLED 显示。
目前完成了部分的 C 语言代码，后续可以在此基础上继续修改

## 2026-05-28 后续追加：Python 算法移植到 STM32 C、OLED 显示与串口复测

### MCU C 端当前状态

`Core/Src/main.c` 已经把 PC 端 `PPGEstimator` 的主要逻辑移植回 STM32：

- DC IIR 跟踪：`PPG_DC_ALPHA = 0.02`
- 去 DC 后低通：`PPG_FILT_ALPHA = 0.20`
- 滚动窗口：`PPG_WINDOW_SAMPLES = 1000`，约 `10s`
- 手指检测：`PPG_FINGER_IR_MIN = 10000`，`PPG_MIN_AC_RMS = 10`
- warmup：`PPG_WARMUP_SAMPLES = 2000`，约 `20s`
- HR 自相关最短数据：`PPG_AUTOCORR_MIN_SAMPLES = 600`
- HR 有效显示范围：`45-190 bpm`
- SpO2 质量门限：`PPG_MIN_SPO2_SCORE = 4.0`
- SpO2 公式仍为：

```text
SpO2 = 101.0 - 7.0 * ratio
```

Type-C USB CDC 的透明原始输出没有改，仍保持：

```text
t_ms,red,ir,irq_count,sample_count
```

这点很重要：后续仍然可以继续用 Python/MATLAB 对原始 MAX30102 数据做离线分析。

### OLED 显示改动

两块 OLED 当前显示策略：

- 0.91 寸小屏：固定显示 `V3.0 05-28`
- 0.96 寸大屏：显示 `bpm:` 和 `SpO2:` 两行结果
- 无手指、warmup 未完成、质量不足时显示 `--`
- 已删除原先左上角小心形图标

修复过的 OLED 问题：

- 原字体表缺少 `V`、`.`、`S`、`O`、`p`、`m`，导致屏幕上只显示部分字符。
- 已补全这些字符。
- 小屏 2 倍字体宽度从 12 列压到 11 列，避免 `V3.0 05-28` 超出 128 像素宽度。

### HR 慢显示和旧状态问题处理

用户反馈：血氧有时比心率更快显示，心率有时卡很久不显示；另外担心旧 HR 状态没有清干净，出现过 `200 bpm` 边界值。

当前处理：

- HR 显示范围限制为 `45-190 bpm`，用于拦截自相关最短周期导致的假 `200 bpm`。
- 新增/拆分 HR 状态清理逻辑：HR 过期时会清掉 HR 历史、峰值历史、旧自相关结果，避免旧心率反复复活。
- 无手指或信号无效时会清空 HR、SpO2、ratio、峰值、历史状态。
- warmup 期间不显示 HR/SpO2，但现在会继续积累峰值历史；这样 warmup 结束后，如果自相关暂时失败，峰值法 fallback 可以更快给出候选 HR。

关键结论：

- `20s` 内不显示 HR/SpO2 是设计行为，不是卡死。
- 优质数据回放中，HR 和 SpO2 都是在检测到手指后约 `19.8s` 首次出现，符合 warmup 设计。
- 如果超过 warmup 后 HR 还长时间不显示，优先检查信号质量和自相关/峰值门限。

### Python 脚本同步改动

`scripts/read_max30102_raw.py` 同步更新：

- 增加 HR 有效范围参数：
  - `--min-valid-hr-bpm`，默认 `45.0`
  - `--max-valid-hr-bpm`，默认 `190.0`
- Python 端也改为 warmup 期间保留峰值历史，但不显示 HR/SpO2。
- 修复 `--duration` 计时问题：现在从串口/输入文件准备完成后开始计时，避免 Windows 打开 COM7 的延迟吃掉采样时间。

### 烧录状态

最近几次 C 端修改均已编译并烧录，OpenOCD 显示：

```text
** Programming Finished **
** Verified OK **
** Resetting Target **
```

因此当前固件已写入 STM32。

注意：烧录/reset 后 Windows 的 USB CDC 有时会出现 COM7 打开卡住。重新插拔黑丸 Type-C 后通常恢复。连续运行脚本两次已验证：脚本退出后不会长期占用 COM7。

### 最近新增数据集

新增目录已同步记录在：

```text
testing dataset\本地采集数据集说明.md
```

重点目录如下：

| 目录 | 说明 |
| --- | --- |
| `15_MCU_C版V3串口烟测失败` | C 端 v3 初次 smoke，烧录后 COM7 打开失败，0 样本 |
| `16_MCU_C修复后串口烟测失败` | OLED/HR 边界修复后 smoke，COM7 打开卡住，0 样本 |
| `17_MCU_C重插后烟测` | 重新插拔后 8 秒读取成功，801 样本，无手指为 `--` |
| `18_MCU_C对齐后串口烟测失败` | C/Python HR 范围和 fallback 对齐后 smoke，烧录后 COM7 打开卡住 |
| `19_串口重插第1次` | 连续串口读取第 1 次，发现 duration 计时被打开串口耗时影响 |
| `20_串口重插第2次` | 连续串口读取第 2 次，同样暴露计时问题 |
| `21_定时修复后串口重插第1次` | 修复计时后第 1 次连续读取，445 样本，0 丢样 |
| `22_定时修复后串口重插第2次` | 修复计时后第 2 次连续读取，437 样本，0 丢样 |
| `93_预热峰值回放验证` | 回放第 13 组，验证 warmup 期间保留峰值历史 |
| `94_最新烧录后串口验证` | 最新固件后串口 smoke，440 样本，0 丢样，raw CSV 正常 |

`94_最新烧录后串口验证` 的结果：

```text
samples = 440
missing_sample_count = 0
sample_count_gap = 1
fs_hz = 100.0
finger_present = true
hr_bpm = null
hr_peak_bpm = 81.081
spo2 = null
```

解释：

- 该测试只采了约 `5s`，还没过 `20s` warmup。
- 因此正式显示的 `hr_bpm` 和 `spo2` 仍为 `--` 是正常的。
- 但 `hr_peak_bpm` 已出现约 `81 bpm` 候选值，说明峰值识别已经开始工作。

### 当前阶段建议

下一步如果继续验证 MCU 端显示，建议测试流程为：

1. 重新插拔黑丸 Type-C，确保 COM7 正常。
2. 手指轻放，至少保持 `25-30s`。
3. 前 `20s` 不显示数值是正常 warmup。
4. `20s` 后观察大 OLED 是否显示 HR/SpO2。
5. 同时用 `scripts/read_max30102_raw.py` 采集 raw/processed/summary，方便继续对照。

如果用户觉得 `20s` 等待太长，可以后续把 HR warmup 缩短为 `8-12s`，但 SpO2 建议仍保持更保守的 `20s` 或更长，因为 SpO2 对接触稳定性更敏感。

## 2026-05-28 当前同步：烧录后 CDC 卡住作为已知现象处理

本轮同步已重新阅读：

```text
Reports/总体完成进度（2026.6.23定稿）.md
testing dataset\本地采集数据集说明.md
Core\Src\main.c
USB_DEVICE\App\usbd_cdc_if.c
scripts/read_max30102_raw.py
```

当前工程方向确认如下：

- STM32 固件继续保留 Type-C USB CDC 原始输出，格式仍为：

```text
t_ms,red,ir,irq_count,sample_count
```

- PC 端算法调试仍以 `scripts/read_max30102_raw.py`、历史 raw 数据回放和新采集数据为主。
- 不需要为了 PC 端调参频繁烧录固件；应先在电脑端验证算法，确认后再移植到 MCU C 并烧录。
- 烧录或 OpenOCD reset 后，Windows 可能能看到 `COM7` / `VID_0483&PID_5740`，但打开、`mode COM7` 或 Python 配置串口会卡住或失败。
- 该 CDC 卡住现象暂时不继续在固件里追，后续每次烧录后手动重新插拔黑丸 Type-C 作为恢复步骤。

本轮实际验证：

- 编译命令返回 `ninja: no work to do`，说明当前 build 产物已是最新。
- 已用 OpenOCD 重新烧录当前 `build\Debug\STM32_F411_Test.elf`。
- OpenOCD 烧录结果：

```text
** Programming Finished **
** Verified OK **
** Resetting Target **
```

- 烧录后 `python -m serial.tools.list_ports -v` 仍能看到：

```text
COM7  USB VID:PID=0483:5740
```

- 但 `mode COM7` 超时。
- 第一次 Python 串口读取失败在 Windows 配置端口阶段：

```text
SerialException: Cannot configure port ... OSError(22, '指定不存在的设备。', None, 433)
```

- OpenOCD reset 后再次尝试读取，Python 打开/读取过程卡住并被超时终止。
- 未发现残留 `python`、`openocd`、`arm-none-eabi-gdb` 进程。

新增测试目录：

```text
testing dataset\95_当前固件烧录串口复测
```

当前该目录记录的是“最新固件烧录成功，但烧录后未手动重新插拔 Type-C 时 COM7 读取失败/卡住”的场景，样本数为 0。不要把它解读为 raw CSV 格式损坏或 MAX30102 数据链路失效。

后续推荐流程更新为：

1. 平时算法开发优先使用 PC 端脚本和已有 `testing dataset` 回放。
2. 需要新采集时，先确认黑丸 Type-C 直连电脑，必要时重新插拔。
3. 只有确认 PC 端算法逻辑后，再改 MCU C 代码并烧录。
4. 每次烧录后如果串口卡住，直接重新插拔黑丸 Type-C，再做连续两次读取验证。

### 不烧录连续串口读取验证

在不重新烧录、不重新插拔的情况下，连续运行两次：

```powershell
python scripts/read_max30102_raw.py --port COM7 --duration 6 --csv 'testing dataset\96_不重新烧录串口复测\run1_raw.csv'
python scripts/read_max30102_raw.py --port COM7 --duration 6 --csv 'testing dataset\96_不重新烧录串口复测\run2_raw.csv'
```

两次均正常打开、读取、关闭 `COM7`。

| 文件 | 样本数 | 缺失 sample_count | sample_count_gap | 结论 |
| --- | ---: | ---: | ---: | --- |
| `run1_raw.csv` | 602 | 0 | 1 | 正常，无手指，HR/SpO2 为空 |
| `run2_raw.csv` | 602 | 0 | 1 | 正常，中途检测到手指，但 6s 未过 warmup，HR/SpO2 为空 |

结论：

- 不烧录时，当前脚本可以连续打开/关闭 `COM7`，不会把串口卡死。
- 串口卡住主要集中在烧录或 OpenOCD reset 之后的 Windows CDC 重新枚举阶段。
- 现有 raw CSV 输出链路仍然正常，适合继续 PC 端采集和算法调试。

## 2026-05-28 Python warmup 优化：HR 10s，SpO2 20s

本轮只改 PC 端脚本，不改固件、不烧录。

目标：

- 用户觉得检测到手指后固定等待约 `20s` 才显示数据太慢。
- 希望尝试改到约 `10s`，并用历史数据回放评估稳定性是否下降。

脚本改动：

```text
scripts/read_max30102_raw.py
```

- `--warmup` 默认值从 `20.0` 改为 `10.0`，现在只控制 HR 显示等待时间。
- 新增 `--spo2-warmup`，默认 `20.0`，单独控制 SpO2 显示等待时间。
- 默认推荐策略变为：

```text
HR warmup = 10s
SpO2 warmup = 20s
```

原因：

- 历史数据回放显示，HR 改为 `10s` 后可以更快出数，稳定组没有明显变差。
- 如果 SpO2 也改成 `10s`，轻放稳定组基本没问题，但在接触过渡场景中波动明显增大。
- 因此当前不建议把 SpO2 也默认提前到 `10s`。

已新增验证目录：

```text
testing dataset\97_10秒预热回放验证
testing dataset\98_心率10秒血氧20秒回放验证
```

关键 A/B 结果：

| 数据组 | 策略 | 首次 HR | 首次 SpO2 | HR std | SpO2 std | 结论 |
| --- | --- | ---: | ---: | ---: | ---: | --- |
| `10_轻触最佳稳定参考` | `20/20` | `20s` | `20s` | `2.69` | `0.098` | 原基线 |
| `10_轻触最佳稳定参考` | `10/10` | `10s` | `10s` | `2.423` | `0.107` | 稳定轻放基本可用 |
| `10_轻触最佳稳定参考` | `10/20` | `10s` | `20s` | `2.423` | `0.098` | 推荐 |
| `13_无手指再放上预热` | `20/20` | `51.15s` | `51.15s` | `3.721` | `0.095` | 原基线 |
| `13_无手指再放上预热` | `10/10` | `42.98s` | `42.76s` | `4.285` | `0.264` | SpO2 早期波动变大 |
| `13_无手指再放上预热` | `10/20` | `42.98s` | `51.15s` | `4.285` | `0.095` | 推荐 |
| `14_测量中移开手指` | `20/20` | `26.7s` | `26.7s` | `3.85` | `0.097` | 原基线 |
| `14_测量中移开手指` | `10/10` | `18.6s` | `17.25s` | `4.489` | `0.566` | SpO2 明显变差 |
| `14_测量中移开手指` | `10/20` | `18.6s` | `26.7s` | `4.489` | `0.097` | 推荐 |

安全性检查：

- `01_无手指基线`：`10/10` 和 `10/20` 都没有误出 HR/SpO2。
- `06_强按低质量血氧空白`：SpO2 仍为空。
- `09_强按血氧空白复核`：SpO2 仍为空。

结论：

- HR 可以先改成 `10s`，用户等待时间明显缩短。
- SpO2 暂时保持 `20s` 更稳，尤其是刚放上手指或接触状态变化时。
- 当前默认参数已经改为 PC 端推荐策略：`--warmup 10 --spo2-warmup 20`。

## 2026-06-09 状态同步：OLED 卡顿根因与 I2C 速率记忆

用户已在硬件端确认：之前 0.91 寸小屏心率波形“一段一顿”、脉搏峰出现时卡顿的核心原因不是心率/血氧算法本身，而是 OLED 所在 I2C 总线仍按默认 `100 kHz` 工作。代码里后来改了速率，但工程/CMake 侧没有形成单独的参数记忆，容易让后续维护者误判。

当前代码检查结果：

```text
Core/Src/i2c.c
hi2c1.Init.ClockSpeed = 400000;  // I2C1: 0.96 寸 128x64 SSD1306 大屏
hi2c2.Init.ClockSpeed = 400000;  // I2C2: 0.91 寸 128x32 SSD1306 小屏
hi2c3.Init.ClockSpeed = 100000;  // I2C3: MAX30102
```

工程文件关系：

- `CMakeLists.txt` 不保存 I2C 外设速率。
- `cmake/stm32cubemx/CMakeLists.txt` 只是把 `Core/Src/i2c.c` 编译进工程。
- 以后如果通过 CubeMX、STM32Cube 插件或重新生成代码覆盖了 `Core/Src/i2c.c`，必须手动复查上述三处 `ClockSpeed`。

维护原则：

- 小屏/大屏刷新卡顿时，先检查 `I2C1/I2C2` 是否仍为 `400000`，不要先怀疑已经定稿的 HR/SpO2 算法。
- MAX30102 仍走 `I2C3=100000`；不要为了 OLED 刷新把传感器总线一起改掉，除非后续单独做传感器链路验证。
- Type-C USB CDC 原始数据输出模块仍应保持独立，不要为了 OLED 显示优化破坏原始 `red/ir` 数据输出格式。

## 2026-06-11 后续方向：端侧疑似房颤风险筛查

用户提出下一阶段可以参考之前在 DSP 开发板上做手写体识别的思路：PC 端训练朴素贝叶斯概率参数，单片机端只保存参数并执行轻量推理。该思路适合本项目，但应定位为“基于 PPG 的疑似房颤风险筛查 / 不规则心律概率提示”，不要表述成医学诊断。

### 总体原则

- 不改动当前已经阶段性定稿的 HR/SpO2 主算法。
- 新增独立模块，例如 `AF_Screening_*`，只读取现有 PPG 峰值/脉搏间期/信号质量结果。
- PC 端负责数据集读取、特征工程、朴素贝叶斯训练、参数导出。
- STM32 端负责在线特征计算和朴素贝叶斯推理，输出 `af_risk_percent` / `af_valid` / `irregular_rhythm_suspected`。
- 用词必须保守：显示“疑似房颤风险”或“不规则心律提示”，不要显示“诊断房颤”。

### 推荐模型路线

优先采用“PPI 节律特征 + 离散化朴素贝叶斯”：

1. MCU 从现有 IR PPG 峰值检测中记录相邻脉搏峰时间差：

```text
PPI = current_peak_ms - previous_peak_ms
```

2. 在 30-60 秒窗口内提取节律特征：

```text
mean_ppi
std_ppi
rmssd
pnn50
cv_ppi = std_ppi / mean_ppi
max_ppi / min_ppi
short_interval_count
long_interval_count
valid_peak_count
signal_quality_score
autocorr_stability / correlation_score
```

3. PC 端把连续特征离散成若干桶，例如：

```text
RMSSD: 0-20, 20-40, 40-80, 80+ ms
pNN50: 0-5%, 5-15%, 15-30%, 30%+
PPI std: 0-30, 30-60, 60-120, 120+ ms
CV: 0-0.05, 0.05-0.10, 0.10-0.20, 0.20+
```

4. PC 端训练得到参数：

```text
log P(Normal)
log P(AF)
log P(feature_bin | Normal)
log P(feature_bin | AF)
```

5. MCU 端推理只做查表累加：

```text
score_normal = logP_normal + sum(logP_bin_normal)
score_af     = logP_af     + sum(logP_bin_af)
```

然后把两个 score 转换成风险比例或直接比较大小。该方法比小神经网络更容易解释、更容易移植，也更符合 STM32F411 的资源条件。

备选方案是高斯朴素贝叶斯：PC 端导出每类每特征的 `mean`、`var`、`prior`，MCU 端计算 log Gaussian。该方案不需要分桶，但 MCU 端涉及平方和 log/exp，可通过 PC 端预计算 `inv_var`、`log_coeff` 降低运算量。

### 可用公开数据集

优先考虑以下公开数据：

- MIT-BIH Atrial Fibrillation Database：长期 ECG，带 AF 节律标注。适合先从 RR 间期训练“不规则节律”模型。
- PhysioNet/CinC Challenge 2017：短单导联 ECG，标签包括 Normal、AF、Other、Noisy。适合短窗口 AF 分类验证。
- MIMIC waveform 类数据库：可能包含 ECG/PPG 等多波形，但标签整理成本更高。
- BIDMC PPG and Respiration Dataset：有 PPG/ECG/呼吸等信号，但不是专门 AF 标签数据，更适合验证 PPG 预处理和峰值检测。

注意：很多公开 AF 数据是 ECG，不是 PPG。可以先用 ECG 的 RR 间期训练节律不规则模型，再迁移到 PPG 的 PPI 间期上，但必须承认存在 ECG->PPG 的 domain gap。更严谨的后续验证是用带 ECG 标签的 PPG 数据，或自行采集 PPG 并用手表/心电参考设备做对照。

### 建议接手步骤

1. 先在 PC 端新建脚本，不动固件：

```text
scripts/train_af_naive_bayes.py
```

功能：读取公开数据集或整理后的 RR/PPI CSV，提取 30-60 秒窗口特征，训练朴素贝叶斯，导出 C 参数表。

2. 新建回放验证脚本：

```text
replay_af_screening.py
```

功能：读取现有 `testing dataset` 或新采集的 PPG raw CSV，复用/实现峰值检测，生成 PPI 特征并输出风险分数。

3. PC 端验证稳定后，再移植到 MCU：

```text
AF_Screening_UpdateBeat(uint32_t beat_time_ms, uint16_t signal_quality)
AF_Screening_Evaluate(void)
```

4. MCU 端只在窗口数据足够、信号质量足够时输出风险；无手指、强按、低质量、有效峰数不足时输出无效状态。

5. 显示和串口字段建议：

```text
AF Risk: --          // 无效或质量不足
AF Risk: 23%         // 低风险
AF Risk: 78%         // 疑似不规则心律，建议复测/参考 ECG
```

### 对外表述

推荐表述：

- “基于 PPG 脉搏间期的疑似房颤风险筛查”
- “不规则心律概率提示”
- “端侧轻量机器学习推理”

避免表述：

- “诊断房颤”
- “医疗级房颤检测”
- “替代 ECG”
