BruceKe365/STM32F411-PPG-Pulse-Monitor/Reports/房颤风险功能详细总结.md

# 房颤风险功能详细总结

更新时间：2026-06-29

本文档用于交接当前房颤风险功能的设计、数据、训练结果、单片机实现和验证结论。下一个 AI 或开发者接手时，先读 `AI助手接手？先读我.md`，再读本文，然后按需查看代码和报告文件。若后文历史段落与当前声明冲突，以当前 `Core/Src/main.c`、`scripts/validate_mcu_af_live.py` 和 `full_af_validation_20260629_current` 为准。

## 2026-06-29 固件参数一致性声明

AF risk 固件仍使用 30s 窗口、至少 20 个 PPI、10s/30s 快慢刷新、25 bpm 心率显示跳变门限和 20% 风险上跳保持。2026-06-29 已按这些实际参数重跑本地 PPG、AFDB/LTAFDB/NSR2DB、模拟 PPI 和质量门控报告，旧的 60s 慢刷新/28 bpm 报告不再作为当前结果。

最终实现：

```text
MAX30102 PPG
-> robust peak
-> PPI
-> HR 参考动态 PPI 过滤
-> PPI 窗口质量门控
-> 11 个 PPI/HRV 不规则特征
-> 离散朴素贝叶斯
-> 0-100% AF risk
```

最终产品策略：

- AF live 未出值或当前风险 >=20% 时每 10s 尝试更新。
- 当前风险 <20% 后每 30s 尝试更新。
- PPI 异常比例 >20%、窗口不足或 HR 差异 >18 bpm 时保持旧值。
- 新风险上跳超过 20% 时保持旧值，下降方向不拦截。
- AF test 使用内置 AFDB `06995` PPI 段，约 30.244s 后显示约 85%。
- AF 输出只表示 PPI 不规则风险，不能用于确诊房颤。

最终文件：

```text
Core/Src/main.c
scripts/validate_mcu_af_live.py
scripts/train_af_naive_bayes.py
training_dataset/models/af_nb_model.json
training_dataset/models/af_nb_model.h
training_dataset/reports/full_af_validation_20260629_current/
```

验收前不再：

- 修改 AF 权重、概率映射或 test PPI。
- 调整 PPI 质量门限、20% 上跳保持或 10s/30s 刷新。
- 重新训练模型并覆盖正式模型文件。
- 把 AF risk 宣传为医学诊断。

## 2026-06-17 定稿技术速览

这一节是验收定稿采用的最终技术状态。后面的 2026-06-16 及更早段落保留开发过程细节，但其中“每 10 秒刷新一次”“质量门控尚未移植”等说法已经过期。

### 一句话状态

AF 功能已经完成 PC 端训练/验证、MCU 端移植、PPI 质量门控、跳变保持、快慢刷新、OLED 页面显示和烧录验证。它仍然不是医学诊断，而是“基于 PPI 不规则性的 AF risk / 不规则心律风险提示”。

### 当前 MCU 行为

显示路径：

```text
HR/SpO2 -> AF live -> STRESS -> AF test -> HR/SpO2
```

live AF 计算条件：

```text
finger_present != 0
ppg_state.raw_finger_present != 0
ppg_state.finger_score >= PPG_MIN_SPO2_SCORE
ppg_signal_valid != 0
heart_rate_bpm > 0
spo2_percent > 0
```

当前关键常量：

```text
AF_MIN_PPI_COUNT = 20
AF_WINDOW_TARGET_MS = 30000
AF_MAX_PPI_COUNT = 100
AF_LIVE_HR_TOLERANCE_BPM = 18.0
AF_RISK_FAST_STEP_MS = 10000
AF_RISK_SLOW_STEP_MS = 30000
AF_STABLE_RISK_THRESHOLD_PERCENT = 20
AF_MAX_UP_JUMP_PERCENT = 20
PPG_PPI_QUALITY_MAX_REJECT_PCT = 20
```

当前显示/更新策略：

- 未出 AF 值或当前 AF 风险仍 >=20% 时，每 10 秒尝试计算。
- 当前显示 AF 风险 <20% 后，每 30 秒尝试计算。
- PPI 窗口至少 20 个 PPI，覆盖约 30 秒。
- PPI 异常比例超过 20% 时不更新，保持旧值。
- PPI 推算 HR 与当前 `heart_rate_bpm` 相差 >18 bpm 时不更新。
- 新风险比旧风险上跳超过 20% 时不更新，避免正常人瞬间跳到 90-100%。
- 下降方向不拦截，便于从高风险恢复到低风险。
- 手指离开或 finger score 低时重置为 `AF --%`。
- AF test 不使用 live 稳定策略；它只播放内置 AFDB `06995` PPI 段，约 30.244 秒后算出约 85%。

PPI 过滤：

- 原始 PPI 合法范围：300 ms 到 2200 ms。
- 正常 HR 时，PPI 需在当前 HR 期望 PPI 的 `0.70x ~ 1.45x`。
- HR <65 时放宽到 `0.58x ~ 1.65x`。
- HR >115 时使用 `0.64x ~ 1.38x`。

### 当前验证结果

当前全量报告目录：

```text
training_dataset/reports/full_af_validation_20260629_current/
```

关键结果：

```text
local_ppg normal: valid=33/292, median=0.0%, mean=3.212%, ge80=3.030%
mcu_test_afdb_06995: valid=1/40, risk=85%
public_afdb normal: ge80=0.279%
public_ltafdb normal: ge80=0.685%
public_nsr2db normal: ge80=0.016%
public_afdb af: ge80=36.892%
public_ltafdb af: ge80=45.550%
```

解释：当前策略明显压低了正常/本地稳定采集上的偶发高风险，同时 AFDB/LTAFDB 的 AF 段仍有响应。本地 `local_ppg` 有效窗口较少，主要因为短采集、手指变化和 PPI 质量门控较保守；这是为了稳定显示，不是数据没读到。

### 相关脚本现状

| 文件 | 当前作用 |
| --- | --- |
| `scripts/train_af_naive_bayes.py` | 训练离散朴素贝叶斯 AF risk 模型，输出 `training_dataset/models/af_nb_model.json` 和 `.h`。 |
| `scripts/validate_mcu_af_live.py` | 当前最重要验证脚本，复刻 MCU live/test、PPI 质量门控、HR 跳变保持、AF 快慢刷新和上跳保持。 |
| `scripts/simulate_af_ppi_risk.py` | 模拟 PPI 场景 sanity check。 |
| `scripts/download_af_training_data.py` | 下载 PhysioNet 注释文件。 |

当前 `scripts/validate_mcu_af_live.py` 默认公开数据入口是 `afdb,ltafdb,nsr2db`。目录里也有 `mitdb/nsrdb`，脚本可尝试指定它们做额外验证，但当前参数对齐报告引用的是 `full_af_validation_20260629_current/`，即 AFDB/LTAFDB/NSR2DB 加本地 PPG 和模拟场景。

### 修改边界

- 不要让 AF 逻辑反向影响 HR/SpO2。
- 不要把 `testing dataset/` 当 AF 阳性训练集；它没有真实 AF 患者 PPG。
- 不要把高 AF risk 写成医学诊断。
- 如果继续优化，先改 `scripts/validate_mcu_af_live.py` 并跑本地 + 公开数据，再移植到 `Core/Src/main.c`。
- AF 正常显示稳定后已经 30 秒刷新，不要再按旧文档理解成固定 10 秒刷新。

## 2026-06-16 接手速览

这一节是 2026-06-16 的历史同步。后文保留了开发过程中的详细说明，若有表述差异，以最前面的 `2026-06-29 固件参数一致性声明`、当前 `Core/Src/main.c`、当前 Python 脚本和 `full_af_validation_20260629_current` 为准。

### 一句话状态

房颤风险功能已经完成“PC 端训练与验证 + MCU 端基础移植 + test 回放展示”。当前不是医学诊断算法，而是基于 PPG 峰间期 PPI 不规则性的疑似房颤风险原型。

### 固件当前已经实现

- 大屏 0.96 寸：
  - 默认显示心率和血氧。
  - 按 PA0 一次显示 live `AF %`，数据来源仍是 MAX30102 实时传感器。
  - 再按一次显示 `[test]` 和 `AF %`，数据来源切换为内置 AFDB PPI 测试段。
  - 再按一次回到心率/血氧。
- 小屏 0.91 寸：
  - 原有 Pause/Loading/波形逻辑保持，不为 AF 功能改动。
- AF 计算：
  - live 模式只在 `finger_present`、`ppg_signal_valid`、`heart_rate_bpm > 0`、`spo2_percent > 0` 后开始。
  - 取最近约 30 秒 PPI，至少 20 个 PPI，每 10 秒刷新一次。
  - PPI 推算 HR 和当前 HR 相差超过 18 bpm 时显示 `--`。
  - 当前固件没有使用质量门控候选方案，也没有强行压低概率。
- test 模式：
  - 内置 AFDB `06995` 的 AF rhythm PPI/RR 段。
  - 不是硬编码风险值，需要播放到窗口满约 30.244 秒才计算。
  - 当前等价验证结果约为 85%。

### 不能乱动的部分

- 不要重写 HR/SpO2 主算法。
- 不要重写小屏 0.91 寸波形显示算法。
- 不要把 AF 功能改成影响 HR/SpO2 的主流程。
- 不要删除英文模型/报告文件名，因为脚本默认仍读这些英文路径。
- 如果 CubeMX 重新生成代码，必须复查 `Core/Src/i2c.c`：大屏和小屏 I2C 是 400 kHz，MAX30102 是 100 kHz。

### Python 脚本地图

| 文件 | 用途 |
| --- | --- |
| `scripts/download_af_training_data.py` | 下载 PhysioNet 注释数据，只下训练/验证所需的最小文件。 |
| `scripts/train_af_naive_bayes.py` | 训练离散朴素贝叶斯模型，输入是 RR/PPI 窗口，输出 `af_nb_model.json` 和 `af_nb_model.h`。 |
| `scripts/simulate_af_ppi_risk.py` | 用模拟 PPI 检查模型行为，不参与训练。 |
| `scripts/validate_mcu_af_live.py` | 电脑端复刻 MCU live/test AF 显示逻辑，是当前最重要的验证脚本。也包含质量门控候选实验。 |
| `scripts/read_max30102_raw.py` | 串口读取原始 MAX30102 red/ir CSV，只有 raw 输出打开时才适合用。 |
| `scripts/read_serial_diagnostics.py` | 串口读取当前诊断 CSV，检查主循环、采样、OLED、USB CDC 状态。 |

### 数据集和标签

| 数据集 | 路径 | 当前角色 | 标签解释 |
| --- | --- | --- | --- |
| AFDB | `training_dataset/physionet/afdb/1.0.0` | 训练 + 验证 | AF rhythm 标为 AF，非 AF 段可能仍含其他不规则。 |
| LTAFDB | `training_dataset/physionet/ltafdb/1.0.0` | 训练 + 验证 | 长时 AF/非 AF 标注，验证规模最大。 |
| NSR2DB | `training_dataset/physionet/nsr2db/1.0.0` | 训练 + 正常验证 | 整体按 normal 使用。 |
| MITDB | `training_dataset/physionet/mitdb/1.0.0` | 额外泛化验证 | 含 AF、normal、other、mixed，不参与当前训练。 |
| NSRDB | `training_dataset/physionet/nsrdb/1.0.0` | 额外正常泛化验证 | 整体按 normal 使用，不参与当前训练。 |

当前 `scripts/validate_mcu_af_live.py` 的标签汇总口径：

- `af`：窗口主要落在 AF rhythm。
- `normal`：窗口主要落在正常或非 AF 正常段。
- `mixed`：一个窗口内混入多种 rhythm。
- `other`：其他异常心律或非 AF 异常标签。

### 当前关键结果

按 MCU 等价 live/test 逻辑验证：

```text
local_ppg normal: 有效显示点 33/292, median=0%, mean=3.212%, ge80=3.030%
mcu_test_afdb_06995: first_valid=30.244s, risk=85%
公开数据 MCU 流式有效点 AF 标签: ge80=45.146%
公开数据 MCU 流式有效点 normal 标签: ge80=0.258%
公开数据 MCU 流式有效点 mixed 标签: ge80=7.596%
公开数据 MCU 流式有效点 other 标签: ge80=18.981%
```

解释：

- 稳定正常 PPG 和稳定正常窦律数据整体风险低。
- AF 标签窗口高风险检出率高。
- mixed/other 偏高是预期限制，因为当前模型本质识别的是“PPI 不规则”，不是严格区分 AF、早搏、运动伪差和其他异常节律。

### 质量门控实验现状

质量门控只在电脑端验证过，还没有移植到 MCU。实验输出在：

```text
training_dataset/reports/mcu_live_af_gate_experiment/
```

候选结果：

```text
baseline_no_gate: AF ge80=95.664%, normal ge80=0.287%
outlier_frac_gt18pct: AF ge80=93.117%, normal ge80=0.192%
artifact_mild: AF ge80=92.751%, normal ge80=0.145%
artifact_strict: AF ge80=78.003%, normal ge80=0.066%
```

建议：

- 不采用 `artifact_strict`，AF 损失太大。
- 后续如要优化，优先移植简单的 `outlier_frac_gt18pct` 或 `artifact_mild`。
- 质量门控的原则是“不可信窗口显示 `--`”，不是人为把概率压低。

### 常用命令

重新训练：

```powershell
python scripts/train_af_naive_bayes.py
```

快速验证 MCU 等价逻辑：

```powershell
python scripts/validate_mcu_af_live.py
```

跑全部公开数据：

```powershell
python scripts/validate_mcu_af_live.py --include-public --public-datasets afdb,ltafdb,nsr2db,mitdb,nsrdb --sim-runs 0 --out-dir training_dataset/reports/mcu_live_af_all_public
```

跑质量门控实验：

```powershell
python scripts/validate_mcu_af_live.py --include-public --public-datasets afdb,ltafdb,nsr2db,mitdb,nsrdb --sim-runs 0 --quality-gate-experiment --out-dir training_dataset/reports/mcu_live_af_gate_experiment
```

## 当前目标

在 STM32F411 + MAX30102 PPG 采样系统上增加一个“AF Risk / 房颤风险”原型功能。

当前功能不是医学诊断，也不是 ECG 房颤确诊算法。它的定位是：

- 使用 PPG 峰间期 PPI，也就是 pulse-to-pulse interval，近似 ECG RR 间期。
- 基于 PPI 不规则性计算房颤风险概率。
- 单片机端只使用它实际能提供的数据：PPG 峰值时间、心率、血氧有效状态。
- 当前模型可以识别“稳定正常 vs 明显不规则”，但对运动伪差、早搏、其他异常节律也会敏感。

## 关键源码

- `Core/Src/main.c`
  - 主固件。
  - 已加入按键切换、大屏 AF 显示、live AF 计算、test AF 回放。
  - 心率、血氧、小屏波形算法没有重写，只在 PPG 处理末尾挂接 AF 计算。

- `scripts/train_af_naive_bayes.py`
  - 训练离散朴素贝叶斯模型。
  - 输入是公开数据库的 RR/PPI 间期窗口。
  - 输出模型 JSON 和 C 头文件。

- `scripts/simulate_af_ppi_risk.py`
  - 用模拟 PPI 序列做 sanity check。
  - 包括稳定正常、呼吸性波动、单个异常点、低/高早搏样不规则、AF-like 不规则等。

- `scripts/validate_mcu_af_live.py`
  - 当前最重要的电脑端验证脚本。
  - 复刻单片机 live/test 的计算口径：
    - 心率/血氧有效后才收 PPI。
    - 最近约 30 秒窗口。
    - 至少 20 个 PPI。
    - 每 10 秒刷新一次 live 风险。
    - PPI 推算 HR 与当前 HR 差值超过 18 bpm 时不计算。
    - 合格后直接显示朴素贝叶斯模型原始风险。
  - 也支持跑公开数据集的完整记录，并按 normal/af/mixed/other 标签统计结果。

## 数据集来源

数据目录在 `training_dataset/physionet/`。

当前使用过的数据：

- `afdb/1.0.0`
  - MIT-BIH Atrial Fibrillation Database。
  - 包含 AF 标注和非 AF 标注。
  - 用于训练和验证 AF/RR 不规则窗口。

- `ltafdb/1.0.0`
  - Long Term AF Database。
  - 包含更长时间的 AF 和非 AF 标注。
  - 用于训练和完整流式验证。

- `nsr2db/1.0.0`
  - Normal Sinus Rhythm RR Interval Database。
  - 作为正常窦律数据来源。
  - 用于训练和正常误报验证。

- `mitdb/1.0.0`
  - MIT-BIH Arrhythmia Database。
  - 额外下载用于独立电脑端验证，不参与当前模型训练。
  - 当前只下载 `.hea` 和 `.atr`，不下载大体积 `.dat` 波形。
  - 包含多种心律和专家标注，其中有少量 AF 标注窗口。

- `nsrdb/1.0.0`
  - MIT-BIH Normal Sinus Rhythm Database。
  - 额外下载用于独立正常数据验证，不参与当前模型训练。
  - 当前只下载 `.hea` 和 `.atr`，不下载大体积 `.dat` 波形。
  - 该库受试者被认为没有显著心律失常，适合评估正常误报。

说明：

- 这些公开数据主要来自 ECG 标注，但我们没有使用 ECG 波形形态。
- 训练特征只使用 RR/PPI 间期统计量，因此可迁移到 PPG 峰间期。
- 由于目前没有真实房颤患者 PPG 波形，当前方法是合理的工程替代验证，而不是最终临床验证。

## 模型特征

模型类型：离散朴素贝叶斯。

输入窗口：约 30 秒 PPI/RR 间期。

特征共 11 个：

- `valid_interval_count`
- `mean_ppi_ms`
- `iqr_ppi_ms`
- `trimmed_std_ppi_ms`
- `trimmed_cv_ppi`
- `median_abs_delta_ms`
- `p80_abs_delta_ms`
- `p95_abs_delta_ms`
- `pnn50_pct`
- `pnn80_pct`
- `pnn120_pct`

这些特征都可以由单片机从峰间期计算出来，不依赖 ECG 或 PPG 波形形态。

## 模型和报告文件

英文原文件保留给脚本使用，中文副本用于人工查看。

模型文件：

- `training_dataset/models/af_nb_model.json`
- `training_dataset/models/房颤朴素贝叶斯模型参数.json`
- `training_dataset/models/af_nb_model.h`
- `training_dataset/models/房颤朴素贝叶斯模型参数_单片机头文件.h`

训练验证报告：

- `training_dataset/reports/af_nb_validation.json`
- `training_dataset/reports/房颤模型训练验证结果.json`

本地正常 PPG 验证：

- `training_dataset/reports/local_ppg_risk.csv`
- `training_dataset/reports/本地正常PPG风险验证.csv`

模拟 PPI 验证：

- `training_dataset/reports/simulated_ppi/simulated_ppi_risk_summary.csv`
- `training_dataset/reports/simulated_ppi/模拟PPI风险验证_汇总.csv`
- `training_dataset/reports/simulated_ppi/simulated_ppi_risk_detail.csv`
- `training_dataset/reports/simulated_ppi/模拟PPI风险验证_明细.csv`

单片机等价 live/test 完整验证：

- `training_dataset/reports/mcu_live_af_full/mcu_live_af_summary.csv`
- `training_dataset/reports/mcu_live_af_full/单片机等价AF验证_按数据源汇总.csv`
- `training_dataset/reports/mcu_live_af_full/mcu_live_af_label_summary.csv`
- `training_dataset/reports/mcu_live_af_full/单片机等价AF验证_按标签汇总.csv`
- `training_dataset/reports/mcu_live_af_full/mcu_live_af_detail.csv`
- `training_dataset/reports/mcu_live_af_full/单片机等价AF验证_逐次明细.csv`

新增数据集独立验证：

- `training_dataset/reports/mcu_live_af_extra_datasets/新增数据集验证_按数据源汇总.csv`
- `training_dataset/reports/mcu_live_af_extra_datasets/新增数据集验证_按标签汇总.csv`
- `training_dataset/reports/mcu_live_af_extra_datasets/新增数据集验证_逐次明细.csv`

全部公开数据集合并验证：

- `training_dataset/reports/mcu_live_af_all_public/全部公开数据集验证_按数据源汇总.csv`
- `training_dataset/reports/mcu_live_af_all_public/全部公开数据集验证_按标签汇总.csv`
- `training_dataset/reports/mcu_live_af_all_public/全部公开数据集验证_逐次明细.csv`
- `training_dataset/reports/mcu_live_af_all_public/全部公开数据集验证_汇总.json`

## 单片机端已实现功能

### 按键切换

使用轮询方式读取按键，不依赖 CubeMX 外部中断。

当前模式循环：

1. 默认模式：大屏显示心率和血氧；小屏显示等效 PPG 波形。
2. 第一次按键：大屏显示 live `AF %`；信号源仍为 MAX30102 实时传感器。
3. 第二次按键：大屏显示 `[test]` 和 `AF %`；信号源切换为内置 AFDB PPI 测试段。
4. 第三次按键：回到心率/血氧显示。

### live AF 模式

live AF 的数据来源是实时传感器。

计算开始条件：

- `finger_present != 0`
- `ppg_signal_valid != 0`
- `heart_rate_bpm > 0`
- `spo2_percent > 0`

也就是说，心率和血氧都有有效值后，才会把 PPG 峰间期送入 AF 风险计算。

live 计算策略：

- 每次有效峰值产生时记录 PPI。
- PPI 合法范围：300 ms 到 2200 ms。
- 保留最近最多 100 个 PPI。
- 每 10 秒刷新一次风险。
- 刷新时取最近约 30 秒 PPI。
- 至少 20 个 PPI 且总时长至少 30 秒才计算。
- PPI 推算心率和当前心率差值超过 18 bpm 时显示 `--`。
- 窗口合格后，直接显示朴素贝叶斯模型原始风险。

注意：曾经做过一版“强行压低 live AF 显示”的逻辑，例如自相关高就归零、95% 以下除以 10。这个逻辑已经撤掉。当前版本不再人为压低风险。

### test AF 模式

test 模式用于无真实房颤患者时展示完整计算链路。

当前内置的是 AFDB `06995` 的一段 AF rhythm PPI/RR 间期，代码注释为：

`AFDB 06995, 9030s..9060s, AF rhythm, 30s RR/PPI window, PC risk ~=85%`

重要说明：

- 单片机内置的不是固定风险值。
- 内置的是一串 PPI 间期。
- 进入 test 后不会立即显示风险。
- 需要逐个播放 PPI，直到窗口满足约 30 秒。
- 然后用同一套朴素贝叶斯参数计算出风险。
- 电脑端等价验证显示，约 30.244 秒后输出 85%。

## 近期验证结果

### 本地正常 PPG

报告：`training_dataset/reports/mcu_live_af_full/单片机等价AF验证_按数据源汇总.csv`

结果：

```text
local_ppg: valid=3/12, median=0%, mean=0%, max=0%, ge80=0%
```

解释：

- 本地采集的正常 PPG 样本数量不多。
- 在当前单片机 live 口径下，正常 PPG 风险为 0%。
- 第一次有效 AF 风险大约在 51.91 秒后出现，因为需要先等心率/血氧有效，再积累 30 秒窗口。

### 内置 AFDB test 段

结果：

```text
mcu_test_afdb_06995: valid=1/40, risk=85%, first_valid=30.244s
```

解释：

- 前 39 次 PPI 输入时窗口还不够 30 秒。
- 第 40 个 PPI 输入后窗口总时长 30.244 秒。
- 此时计算风险为 85%。

### 模拟 PPI

正常模拟：

```text
sim_normal_stable: median=0%, max=0%
sim_normal_respiratory: median=0%, max=0%
sim_normal_single_outlier: median=0%, max=0%
```

明显 AF-like 模拟：

```text
sim_af_like_mild: median=100%
sim_af_like_moderate: median=100%
sim_af_like_high: median=100%
```

非房颤但不规则模拟：

```text
sim_irregular_low: median=100%, mean=83.064%
sim_irregular_borderline: median=100%, mean=97.833%
sim_ectopy_high: median=100%, mean=93.079%
sim_ectopy_low: median=0%, mean=24.381%
```

解释：

- 模型对 PPI 不规则性非常敏感。
- 它能把稳定正常和明显不规则分开。
- 但早搏样、随机不规则、运动伪差导致的 PPI 错乱也可能被判高风险。

### 当前公开数据流式验证

当前报告使用 AFDB/LTAFDB/NSR2DB，并严格采用固件的 30s 窗口、10s/30s 刷新、25 bpm 心率跳变门限和风险上跳保持：

```powershell
python scripts/validate_mcu_af_live.py --out-dir training_dataset/reports/full_af_validation_YYYYMMDD_candidate --ppg-glob "testing dataset/**/*processed*.csv" --sim-runs 120 --sim-duration-s 180 --include-public --public-datasets afdb,ltafdb,nsr2db --public-record-limit 0 --quality-gate-experiment
```

只统计 MCU 流式逻辑实际给出风险的有效点：

```text
AF 标签:      n=188386, ge50=59.341%, ge80=45.146%
normal 标签:  n=258220, ge50=0.260%,  ge80=0.258%
mixed 标签:   n=14495,  ge50=14.495%, ge80=7.596%
other 标签:   n=47284,  ge50=32.463%, ge80=18.981%
```

拆分到当前三个数据集：

```text
public_ltafdb AF:      ge80=45.550%
public_afdb AF:        ge80=36.892%
public_nsr2db normal:  ge80=0.016%
public_ltafdb normal:  ge80=0.685%
public_afdb normal:    ge80=0.279%
```

质量门控实验中的 `baseline_no_gate` 是对原始窗口直接分类，AF/normal 的 ge80 分别为 95.664%/0.287%；它不是 MCU 快慢刷新和风险保持后的流式显示统计，不能与上面的 45.146%/0.258% 混写。

MITDB/NSRDB 曾用于历史泛化实验，但旧结果使用的流式参数与当前固件不完全一致，因此不纳入当前一致性结论。需要引用时必须使用当前脚本重新运行到新的 candidate 目录。

## 当前算法优点

- 单片机端可运行，不依赖大模型或复杂浮点库之外的重计算。
- 输入特征完全符合单片机可获得数据。
- 正常稳定 PPG 风险低。
- AFDB test 段不是写死结果，而是完整计算链路。
- 公开数据完整流式验证显示 AF 窗口总体高风险比例约 95.9%。

## 当前算法局限

- 当前没有真实房颤患者 PPG 波形用于最终验证。
- 模型基于 ECG 标注 RR 间期训练，迁移到 PPG PPI 有合理性，但不等于真实 PPG 临床验证。
- 当前模型本质上识别“节律不规则”，不能严格区分：
  - 房颤
  - 运动伪差
  - 峰检测错误
  - 早搏
  - 其他异常节律
- 所以有些非 AF 不规则窗口会显示高风险。

## 老师展示建议

展示时不要说“已经能确诊房颤”。建议说：

> 当前实现的是基于 PPG 峰间期不规则性的房颤风险原型。由于暂时没有真实房颤患者 PPG，使用公开 AFDB/LTAFDB/NSR2DB 的 RR 间期标注训练和验证。单片机端只使用 PPI 特征，不使用 ECG 波形形态，因此和 PPG 可提供的数据一致。test 模式内置的是公开 AFDB 的一段 AF 间期，不是固定概率，进入 test 后要等 30 秒窗口满足才实时计算出 85%。

现场演示顺序建议：

1. 默认模式展示实时心率和血氧。
2. 按一次进入 live AF，正常手指静止时 AF 风险较低。
3. 按第二次进入 `[test]`，等待约 30 秒后显示 AF 高风险。
4. 打开电脑报告 `单片机等价AF验证_按标签汇总.csv`，展示公开数据集验证结果。
5. 主动说明局限：下一步需要真实 PPG 房颤样本和 PPG 信号质量门控。

## 后续建议

最值得继续做的不是再硬调概率，而是增加质量门控：

- PPI 窗口内异常短/长间期比例过高时显示 `--`。
- 峰值幅度波动过大时显示 `--`。
- `ir_rms` 或 `finger_score` 不稳定时显示 `--`。
- 心率/血氧刚恢复后延迟一个稳定窗口再计算 AF。
- 对连续多个窗口做中位数或稳定确认，而不是单窗口瞬时跳变。

如果后续能拿到真实 PPG 房颤样本，应优先做：

- 真实 PPG AF 与正常 PPG 的离线复测。
- 检查 PPG 峰检测是否会漏峰/多峰。
- 重新评估阈值和质量门控策略。

## 常用命令

重新训练：

```powershell
python scripts/train_af_naive_bayes.py
```

模拟 PPI 验证：

```powershell
python scripts/simulate_af_ppi_risk.py
```

单片机等价验证，不跑公开完整数据：

```powershell
python scripts/validate_mcu_af_live.py
```

单片机等价验证，跑公开完整数据：

```powershell
python scripts/validate_mcu_af_live.py --include-public --out-dir training_dataset/reports/mcu_live_af_full
```

编译固件：

```powershell
& '%LOCALAPPDATA%\stm32cube\bundles\cmake\4.3.1+st.1\bin\cmake.exe' --build build\Debug
```

烧录固件：

```powershell
& 'tools\xpack-openocd-0.12.0-7\bin\openocd.exe' -s 'tools\xpack-openocd-0.12.0-7\openocd\scripts' -f interface\cmsis-dap.cfg -f target\stm32f4x.cfg -c 'adapter speed 1000; program build/Debug/STM32_F411_Test.elf verify reset exit'
```

## 注意事项

- 不要轻易改心率、血氧和小屏波形算法；这些目前是稳定基础功能。
- AF 功能应尽量作为旁路模块挂接，不影响原始 vitals 计算。
- 英文模型/报告文件名不要删，因为脚本默认读取这些路径。
- 中文文件名是为了展示和人工查看生成的副本。
