BruceKe365/STM32F411-PPG-Pulse-Monitor/Reports/压力情绪功能详细总结.md

# 压力情绪功能详细总结

更新时间：2026-06-29

本文档用于交接当前压力/情绪功能的设计、训练数据、模型参数、单片机实现、显示策略和验证结果。下一位 AI 接手时，先读 `AI助手接手？先读我.md`，再读本文；若旧聊天记录或旧报告与本文冲突，以 `2026-06-29 固件参数一致性声明`、当前 `Core/Src/main.c`、正式模型和当前验证脚本为准。

## 2026-06-29 固件参数一致性声明

当前固件仍采用 40s 窗口、至少 28 个 PPI、10s/30s 刷新和 HR>120 隐藏策略。2026-06-29 使用 WESAD 按 `40s/10s step/28 PPI` 重新训练后，全部 scaler、系数、截距和指数标定参数与 `main.c` 内嵌参数逐项一致；正式模型和 `full_stress_*_20260629_current` 报告已据此更新。

最终实现：

```text
MAX30102 PPG
-> robust peak
-> PPI
-> HR 参考动态 PPI 过滤
-> HRV 特征
-> 标准化
-> Logistic Regression
-> sigmoid probability
-> 1-99 stress index
```

最终显示策略：

```text
1-29   relax
30-59  normal
60-79  medium
80-99  high
```

- 首次未出值时每 10s 尝试更新。
- 出值后每 30s 尝试更新。
- PPI 质量不满足时保持旧值。
- HR >120 bpm 时第二行显示 `-- high HR`；后台仍计算，但不向用户显示压力数值。
- Stress 只表示基于 HRV 的压力指数，不识别开心/难过，也不是心理疾病诊断。

最终文件：

```text
Core/Src/main.c
scripts/download_stress_training_data.py
scripts/train_stress_hrv_model.py
scripts/validate_stress_hrv_live.py
training_dataset/models/stress_hrv_model.json
training_dataset/models/stress_hrv_model.h
training_dataset/reports/full_stress_live_validation_20260629_current/
training_dataset/reports/full_stress_train_validation_20260629_current/
```

验收前不再：

- 调整 Logistic Regression 权重、标准化参数或指数偏置。
- 调整 40s 窗口、28 个 PPI、10s/30s 刷新周期或 HR=120 门限。
- 用本地无标签 PPG 重新训练压力模型。
- 把高心率直接解释为心理压力。

## 一句话状态

压力/情绪功能已经完成“WESAD 训练 + 本地 PPG 验证 + MCU 端移植 + STRESS 页面显示”，当前为验收定稿实现。它不是识别开心/难过，而是基于 PPG 峰间期 PPI 的 HRV 压力指数，输出 1-99 数值和 `relax/normal/medium/high` 四档。

## 算法路线

```text
MAX30102 PPG -> robust peak -> PPI -> HRV 特征 -> Logistic Regression -> stress probability -> 1-99 stress index
```

核心点：

- 设备只有 MAX30102 PPG，因此 MCU 端只使用 PPI/HRV 特征。
- 训练用 WESAD，但默认取 wrist BVP 信号，不依赖 EDA、呼吸、体温或 ECG 形态。
- MCU 端不训练模型，只做实时 PPI 收集、HRV 特征计算、标准化、线性加权、sigmoid 和指数映射。
- 压力值容易受高心率、运动、手指抖动和漏峰影响；当前通过显示门控降低误解风险。

## 当前 MCU 行为

相关代码集中在 `Core/Src/main.c`：

```text
STRESS_HRV_MIN_INTERVAL_COUNT = 28
STRESS_HRV_WINDOW_TARGET_MS = 40000
STRESS_HRV_FIRST_STEP_MS = 10000
STRESS_HRV_REFRESH_STEP_MS = 30000
STRESS_HRV_HIGH_HR_BPM = 120
```

实时计算条件：

```text
finger_present != 0
ppg_state.raw_finger_present != 0
ppg_state.finger_score >= PPG_MIN_SPO2_SCORE
ppg_signal_valid != 0
heart_rate_bpm > 0
spo2_percent > 0
```

PPI 来源：

- 复用 PPG robust peak。
- 只有 HR/SpO2 有效时才记录 PPI。
- PPI 会经过 HR 参考的动态区间过滤：
  - 正常 HR：`0.70x ~ 1.45x` 当前期望 PPI。
  - HR < 65：`0.58x ~ 1.65x`。
  - HR > 115：`0.64x ~ 1.38x`。
- 每个更新周期内，如果 PPI rejected 比例超过 20%，不更新压力值，保持旧显示。

窗口和刷新：

- 需要至少 28 个 PPI。
- 最近窗口覆盖约 40 秒。
- 首次未出值时，每 10 秒尝试计算一次。
- 出现第一个可显示压力值后，每 30 秒尝试更新一次。
- 当 `heart_rate_bpm > 120` 时，STRESS 页面第二行显示 `-- high HR`，后台仍继续计算，但刷新节奏按“暂无可参考显示值”走 10 秒。

显示：

```text
第一行：STRESS
第二行：数值 + 英文档位，或 -- high HR
```

档位：

```text
1-29   relax
30-59  normal
60-79  medium
80-99  high
```

## 模型和脚本

| 文件 | 用途 |
| --- | --- |
| `scripts/download_stress_training_data.py` | 下载/整理 WESAD 数据。 |
| `scripts/train_stress_hrv_model.py` | 从 WESAD 训练压力 HRV Logistic Regression，并生成模型/报告。 |
| `scripts/validate_stress_hrv_live.py` | 用本地 processed PPG 按 MCU 参数回放稳态窗口，验证质量门控和本地数值范围。 |
| `training_dataset/models/stress_hrv_model.json` | Python 和验证脚本默认读取的压力模型参数。 |
| `training_dataset/models/stress_hrv_model.h` | C 头文件参数副本，供 MCU 端移植参考。 |
| `training_dataset/models/压力HRV模型参数.json` | 中文名副本，便于人工查看。 |
| `training_dataset/models/压力HRV模型参数_单片机头文件.h` | 中文名 C 头文件副本。 |

注意：正式模型文件在 `training_dataset/models/`。如果只是测试新训练流程，不要直接覆盖正式模型；可以使用隔离 `--base-dir` 生成到 `training_dataset/reports/...` 下。

## 数据集

| 数据 | 路径 | 角色 |
| --- | --- | --- |
| WESAD | `training_dataset/wesad/` | 压力模型训练/验证。当前默认使用 wrist BVP。 |
| 本地 MAX30102 PPG | `testing dataset/**/*processed*.csv` | 正常/边界烟测，验证 MCU live 显示策略和质量门控。 |

WESAD 是公开压力数据集，但它不是本设备采集的数据；本地 PPG 没有真实心理压力标签，因此本地数据主要用于检查“静息正常时是否显示合理”和“坏 PPI 是否被门控”。

## 2026-06-29 固件参数一致性验证结果

### WESAD 训练/验证

隔离报告目录：

```text
training_dataset/reports/full_stress_train_validation_20260629_current/
```

关键结果：

```text
wesad_all: count=3133, auc=0.9267, acc=0.7657, f1=0.7004
wesad_all nonstress_median=50, stress_median=87

wesad_test_by_subject: count=842, auc=0.9157, acc=0.7411, f1=0.6903
wesad_test_by_subject nonstress_median=51, stress_median=87
```

解释：HRV-only 压力模型有可用区分度，但它不是完整多模态 WESAD 模型，没有用 EDA/呼吸/温度，因此不能和多传感器压力识别直接比较。

### 本地 MCU 参数对齐稳态回放

报告目录：

```text
training_dataset/reports/full_stress_live_validation_20260629_current/
```

关键结果：

```text
all_local_processed: files=130, windows=52, displayed_windows=25
display_rate_pct=48.077
raw_median=48.0, raw_max=93.0
display_median=48.0, display_max=53.0
normal_or_lower_pct=100.0
medium_or_high_pct=0.0
reject reasons: spo2_unstable=21, finger_unstable=5, finger_score_low=1, ok=25
```

解释：报告按固件的 40s/28 PPI 参数和 30s 稳态刷新步长生成，首次 10s 重试参数写入报告配置，但不做逐循环调度仿真。经过质量门控后，本地静息/正常采集的显示值主要落在 normal 附近；未门控的 raw 压力烟测可能到 90+，所以固件里的 PPI 质量门控和高心率隐藏是必要的。

## 本地采集相关

压力/AF 调试期间新增的关键本地数据：

| 文件夹 | 内容 |
| --- | --- |
| `testing dataset/112_subject_A_pressure_baseline_light_stable_20260617_140429/` | subject_A 90s 稳定轻触压力基线，9001 samples，零 missing sample_count。 |
| `testing dataset/113_subject_A_pressure_baseline_light_stable_20260617_141049/` | 第二组 90s 稳定轻触压力基线，9001 samples，零 missing sample_count。 |
| `testing dataset/114_subject_B_af_high_review_20260617_144713/` | subject_B 90s 采集，HR/SpO2 稳定但 AF 曾偶发高值；用于验证假峰、PPI 异常比例和保持旧值策略。 |

这些数据不是压力训练集，也不是 AF 阳性样本；它们是本地硬件行为和正常/边界回放验证样本。

## 常用命令

训练/验证压力模型到正式 `training_dataset/models`：

```powershell
python scripts/train_stress_hrv_model.py --wesad-dir training_dataset/wesad --local-ppg-glob "testing dataset/**/*processed*.csv"
```

隔离训练验证，不覆盖正式模型：

```powershell
python scripts/train_stress_hrv_model.py --base-dir training_dataset/reports/full_stress_train_validation_YYYYMMDD_candidate --wesad-dir training_dataset/wesad --local-ppg-glob "testing dataset/**/*processed*.csv"
```

按 MCU 参数回放 Stress 稳态窗口：

```powershell
python scripts/validate_stress_hrv_live.py --out-dir training_dataset/reports/full_stress_live_validation_YYYYMMDD_candidate --ppg-glob "testing dataset/**/*processed*.csv" --ppg-group all_local_processed
```

## 修改边界

- 不要为了压力功能修改 HR/SpO2 主算法。
- 不要直接把高心率解释成心理压力；当前策略是 HR>120 时显示 `-- high HR`。
- 不要把本地正常 PPG 当成有压力标签的训练数据。
- 不要轻易缩短 40s 窗口或 28 个 PPI 门槛；压力 HRV 对假峰很敏感。
- 如果要改模型，先在 PC 端完整跑 WESAD 和本地 processed PPG，再考虑移植 MCU。

## 展示口径

建议对外表述：

> 当前压力/情绪功能是基于 PPG 心率变异性 HRV 的端侧压力指数原型。模型使用 WESAD 的 BVP 数据训练，单片机端只使用 MAX30102 可得到的 PPI 间期特征做轻量 Logistic Regression 推理，输出 1-99 压力指数和 relax/normal/medium/high 四档。高心率时显示 `-- high HR`，避免把运动或非静息状态误判为心理压力。
