BruceKe365/STM32F411-PPG-Pulse-Monitor/training_dataset/公开训练集说明.md

# 公开训练数据、模型与验证报告说明

更新时间：2026-06-29

本目录保存 AF 风险和压力/情绪功能相关的公开数据集、派生训练窗口、模型参数和验证报告。它和 `testing dataset/` 不同：这里主要是公开 RR/PPI、WESAD、训练模型和验证报告；`testing dataset/` 是本地 MAX30102 PPG 采样与 HR/SpO2/OLED/AF/压力回放数据。

## 2026-06-24 文档命名说明

本说明文件由 `training_dataset/README.md` 改名为 `training_dataset/公开训练集说明.md`，方便人工和 AI 直接识别用途。`physionet/`、`wesad/`、`derived/`、`models/`、`reports/` 等目录名保持英文，因为训练和验证脚本默认读取这些路径。

## 2026-06-23 验收数据封版（历史基线）

本目录在 2026-06-23 完成首轮验收数据封版；2026-06-29 又以 `Core/Src/main.c` 和对应 ELF 为运行基线，重新同步 Stress 正式模型并重跑 AF、Stress current 报告。当前结论以正式模型和三个 `full_*_20260629_current` 报告为准。

验收优先引用：

```text
models/af_nb_model.json
models/af_nb_model.h
models/stress_hrv_model.json
models/stress_hrv_model.h

reports/full_af_validation_20260629_current/
reports/full_stress_live_validation_20260629_current/
reports/full_stress_train_validation_20260629_current/
```

封版规则：

- 不运行会覆盖 `models/` 正式文件的训练命令。
- 候选实验必须写入新的隔离 `reports/...candidate/` 目录。
- 不删除英文文件名，脚本默认读取英文路径。
- 不把 `testing dataset/` 的本地正常采集当成 AF 阳性数据或 Stress 标签训练数据。
- 历史报告用于说明演进，当前结论以三个 `full_*_20260629_current` 报告为准。

## 2026-06-29 固件参数一致性数据状态

当前有两类模型：

| 功能 | 模型 | 主要训练数据 | 正式模型文件 |
| --- | --- | --- | --- |
| AF 风险 | 离散朴素贝叶斯 | AFDB/LTAFDB/NSR2DB 的 RR/PPI 间期窗口 | `models/af_nb_model.json`、`models/af_nb_model.h` |
| 压力指数 | 逻辑回归 | WESAD 腕部 BVP 派生的 HRV/PPI 窗口 | `models/stress_hrv_model.json`、`models/stress_hrv_model.h` |

当前最值得下一位 AI 先看的报告：

| 报告目录 | 内容 |
| --- | --- |
| `reports/full_af_validation_20260629_current/` | 当前 AF MCU live/test 参数对齐全量验证，包含本地 processed PPG、AFDB/LTAFDB/NSR2DB、模拟场景。 |
| `reports/full_stress_live_validation_20260629_current/` | 当前 Stress MCU 参数对齐稳态窗口与质量门控回放；不包含逐循环调度或 HR>120 页面隐藏仿真。 |
| `reports/full_stress_train_validation_20260629_current/` | 生成当前 MCU 内嵌参数的 WESAD 压力模型训练/验证输出。 |

当前关键结果：

```text
AF local_ppg normal: valid=33/292, median=0%, mean=3.212%, ge80=3.030%
AF public_nsr2db normal: ge80=0.016%
AF public_afdb normal: ge80=0.279%
AF public_ltafdb normal: ge80=0.685%
AF public_afdb af: ge80=36.892%
AF public_ltafdb af: ge80=45.550%

Stress WESAD all: AUC=0.9267, nonstress_median=50, stress_median=87
Stress WESAD test_by_subject: AUC=0.9157, nonstress_median=51, stress_median=87
Stress local live: files=130, displayed=25/52, display_median=48, display_max=53
```

历史报告 `mcu_live_af_all_public/`、`mcu_live_af_gate_experiment/` 等仍可参考，但它们反映的是较早 AF 策略；当前固件优先引用 `full_af_validation_20260629_current/`。

## 目录结构

| 路径 | 作用 |
| --- | --- |
| `physionet/` | 下载的 PhysioNet 数据集注释文件。当前 Git 提交保留最小 `.hea/.atr/.qrs/.ecg` 文件，不保存大体积 `.dat` 波形。 |
| `wesad/` | WESAD 压力/情绪公开数据。该目录体积很大，不随 Git 提交，需要用脚本下载。 |
| `derived/af_rr_windows.csv` | 从公开数据派生出的 RR/PPI 训练窗口。该目录不随 Git 提交，可由训练脚本重新生成。 |
| `derived/stress_hrv_windows.csv` | 从 WESAD 派生出的压力 HRV 训练窗口。该目录不随 Git 提交，可由训练脚本重新生成。 |
| `models/af_nb_model.json` | Python 和验证脚本默认读取的朴素贝叶斯模型参数。 |
| `models/af_nb_model.h` | 导出给 MCU 移植使用的 C 头文件参数。 |
| `models/stress_hrv_model.json` | Python 和验证脚本默认读取的压力 HRV 模型参数。 |
| `models/stress_hrv_model.h` | 压力 HRV 模型 C 头文件参数副本。 |
| `models/房颤朴素贝叶斯模型参数.json` | 中文名副本，方便人工查看。 |
| `models/房颤朴素贝叶斯模型参数_单片机头文件.h` | 中文名副本，方便人工查看。 |
| `models/压力HRV模型参数.json` | 压力模型中文名副本。 |
| `models/压力HRV模型参数_单片机头文件.h` | 压力模型 C 头文件中文名副本。 |
| `reports/` | AF/Stress 训练、模拟、MCU 等价、公开数据和质量门控验证报告。 |

## 数据集说明

当前公开数据集都在 `physionet/` 下。

| 数据集 | 路径 | 当前用途 | 参与训练 | 标签口径 |
| --- | --- | --- | --- | --- |
| AFDB | `physionet/afdb/1.0.0` | AF/非 AF 训练与验证 | 是 | `.atr` rhythm 给 AF/normal/mixed，`.qrs` 给 beat time。 |
| LTAFDB | `physionet/ltafdb/1.0.0` | 长时 AF/非 AF 训练与验证 | 是 | `.atr` 同时给 beat 和 rhythm。 |
| NSR2DB | `physionet/nsr2db/1.0.0` | 正常窦律训练与验证 | 是 | `.ecg` 给 RR 注释，整库按 normal 处理。 |
| MITDB | `physionet/mitdb/1.0.0` | 额外泛化验证 | 否 | `.atr` 给 beat/rhythm，验证时拆成 AF/normal/other/mixed。 |
| NSRDB | `physionet/nsrdb/1.0.0` | 额外正常泛化验证 | 否 | `.atr` 给 beat，整库按 normal 处理。 |

压力/情绪数据：

| 数据集 | 路径 | 当前用途 | 标签口径 |
| --- | --- | --- | --- |
| WESAD | `wesad/` | 压力逻辑回归训练和按受试者划分验证 | baseline/amusement 作为非压力，stress 作为压力；默认使用腕部 BVP。 |

## Git 提交状态和下载方式

当前公开仓库准备状态如下：

| 数据/产物 | 是否随 Git 提交 | 说明 |
| --- | --- | --- |
| `physionet/` | 是 | 只提交 AF/NSR 训练验证所需的最小注释文件。 |
| `models/` | 是 | 当前 MCU 使用的 AF/Stress 模型参数。 |
| `reports/full_*_20260629_current/` | 是 | 与当前固件参数一致的验证报告。 |
| `wesad/` | 否 | WESAD 原始 zip/解压目录体积约 GB 级，仅在重新训练 Stress 模型时下载。 |
| `derived/` | 否 | 派生训练窗口，可由训练脚本重新生成。 |
| 历史 `reports/*` | 否 | 只保留最终 current 报告，历史实验可按需重跑。 |

如果 `physionet/` 缺失或需要刷新 AF 公开数据：

```powershell
python scripts/download_af_training_data.py --datasets afdb ltafdb nsr2db mitdb nsrdb
```

如果需要重新训练 Stress 模型，先下载 WESAD：

```powershell
python scripts/download_stress_training_data.py
```

然后在隔离目录训练，避免覆盖正式模型：

```powershell
python scripts/train_stress_hrv_model.py --base-dir training_dataset/reports/full_stress_train_validation_YYYYMMDD_candidate --wesad-dir training_dataset/wesad --local-ppg-glob "testing dataset/**/*processed*.csv"
```

重要限制：

- 当前公开 AF 数据主要来自 ECG 标注，但模型只使用 RR/PPI 间期统计特征，不使用 ECG 波形形态。
- 这使模型可以迁移到 MCU 端 PPG 峰间期，但仍存在 ECG RR 到 PPG PPI 的 domain gap。
- 当前没有真实 AF 患者 PPG 数据，因此结论应表述为“疑似房颤风险原型”或“不规则心律提示”，不是医学诊断。

## 标签解释

`scripts/validate_mcu_af_live.py` 的公开数据窗口标签：

| 标签 | 含义 |
| --- | --- |
| `af` | 窗口主要处于 AF rhythm。 |
| `normal` | 窗口主要处于正常或按整库正常处理的数据。 |
| `mixed` | 一个 30 秒窗口内混入多种 rhythm。 |
| `other` | 其他异常节律或非 AF 异常标签。 |

`mixed` 和 `other` 高风险比例高，不代表模型“错把所有正常人判成房颤”，而是说明 PPI 不规则模型会对早搏、其他异常节律和伪差样不规则敏感。

## 重要报告

| 报告路径 | 内容 |
| --- | --- |
| `reports/af_nb_validation.json` | 训练脚本输出的模型验证 JSON。 |
| `reports/local_ppg_risk.csv` | 本地正常 PPG 风险验证。 |
| `reports/simulated_ppi/` | 模拟 PPI 场景风险验证。 |
| `reports/mcu_live_af_full/` | MCU live/test 等价验证，包含本地 PPG、内置 test、部分公开数据。 |
| `reports/mcu_live_af_all_public/` | AFDB/LTAFDB/NSR2DB/MITDB/NSRDB 合并公开数据验证。 |
| `reports/mcu_live_af_extra_datasets/` | MITDB 和 NSRDB 额外数据集验证。 |
| `reports/mcu_live_af_gate_experiment/` | 质量门控候选实验完整结果。 |
| `reports/mcu_live_af_quick/`、`reports/mcu_live_af_gate_quick/` | 快速实验输出，可作参考，但不要优先引用。 |
| `reports/full_af_validation_20260629_current/` | 当前固件 AF 策略验证，优先引用。 |
| `reports/full_stress_live_validation_20260629_current/` | 当前固件 Stress 稳态参数对齐回放，优先引用。 |
| `reports/full_stress_train_validation_20260629_current/` | 当前固件 Stress 模型训练/验证报告，优先引用。 |

优先看这些中文副本：

```text
reports/mcu_live_af_all_public/全部公开数据集验证_按标签汇总.csv
reports/mcu_live_af_all_public/全部公开数据集验证_按数据源汇总.csv
reports/mcu_live_af_gate_experiment/质量门控候选方案_公开数据简表.csv
reports/mcu_live_af_gate_experiment/质量门控候选方案_完整汇总.csv
reports/simulated_ppi/模拟PPI风险验证_汇总.csv
```

英文文件名不要删除，脚本默认仍读取或生成英文路径。

## 历史 AF 关键结果

以下结果已按 2026-06-29 当前固件参数重算；更早的实验仅用于理解模型演进，当前结论优先看本文开头的 `2026-06-29 固件参数一致性数据状态`。

当前 MCU 参数对齐验证结果：

```text
local_ppg normal: valid=33/292, median=0%, mean=3.212%, ge80=3.030%
mcu_test_afdb_06995: first_valid=30.244s, risk=85%
```

AFDB/LTAFDB/NSR2DB 流式有效点合并，`risk >= 80%` 作为高风险：

```text
AF 标签:     ge80=45.146%
normal 标签: ge80=0.258%
mixed 标签:  ge80=7.596%
other 标签:  ge80=18.981%
```

质量门控候选：

```text
baseline_no_gate: AF ge80=95.664%, normal ge80=0.287%
outlier_frac_gt18pct: AF ge80=93.117%, normal ge80=0.192%
artifact_mild: AF ge80=92.751%, normal ge80=0.145%
artifact_strict: AF ge80=78.003%, normal ge80=0.066%
```

质量门控表统计原始窗口，流式表统计 MCU 实际有效显示点，两者不可混用。当前 MCU 已移植 PPI artifact fraction 门控、AF 上跳保持和 10s/30s 刷新策略；额外候选门控仍只作电脑端实验参考。

## 相关脚本

| 脚本 | 用途 |
| --- | --- |
| `../scripts/download_af_training_data.py` | 下载 `physionet/` 下的数据。 |
| `../scripts/train_af_naive_bayes.py` | 读取公开数据、生成 `derived/af_rr_windows.csv`、训练并输出模型。 |
| `../scripts/simulate_af_ppi_risk.py` | 用模拟 PPI 验证模型行为。 |
| `../scripts/validate_mcu_af_live.py` | 复刻 MCU AF live/test 策略，生成 `reports/mcu_live_af*`。 |
| `../scripts/download_stress_training_data.py` | 下载/整理 WESAD。 |
| `../scripts/train_stress_hrv_model.py` | 训练压力 HRV 逻辑回归，生成 `stress_hrv_model.*`。 |
| `../scripts/validate_stress_hrv_live.py` | 按 MCU 参数回放 Stress 稳态窗口，生成 `reports/stress_hrv*`。 |
| `../scripts/check_firmware_consistency.py` | 校验固件、正式模型、当前报告哈希和文档路径的一致性。 |

## 常用命令

下载额外公开数据：

```powershell
python scripts/download_af_training_data.py --datasets mitdb nsrdb
```

重新训练：

```powershell
python scripts/train_af_naive_bayes.py
```

跑全部公开数据验证：

```powershell
python scripts/validate_mcu_af_live.py --include-public --public-datasets afdb,ltafdb,nsr2db,mitdb,nsrdb --sim-runs 0 --out-dir training_dataset/reports/mcu_live_af_all_public
```

跑质量门控实验：

```powershell
python scripts/validate_mcu_af_live.py --include-public --public-datasets afdb,ltafdb,nsr2db,mitdb,nsrdb --sim-runs 0 --quality-gate-experiment --out-dir training_dataset/reports/mcu_live_af_gate_experiment
```

跑当前定稿 AF 验证：

```powershell
python scripts/validate_mcu_af_live.py --out-dir training_dataset/reports/full_af_validation_YYYYMMDD_candidate --ppg-glob "testing dataset/**/*processed*.csv" --sim-runs 120 --sim-duration-s 180 --include-public --public-datasets afdb,ltafdb,nsr2db --public-record-limit 0 --quality-gate-experiment
```

跑当前定稿 Stress 稳态参数对齐验证：

```powershell
python scripts/validate_stress_hrv_live.py --out-dir training_dataset/reports/full_stress_live_validation_YYYYMMDD_candidate --ppg-glob "testing dataset/**/*processed*.csv" --ppg-group all_local_processed
```

隔离训练/验证压力模型，不覆盖正式模型：

```powershell
python scripts/train_stress_hrv_model.py --base-dir training_dataset/reports/full_stress_train_validation_YYYYMMDD_candidate --wesad-dir training_dataset/wesad --local-ppg-glob "testing dataset/**/*processed*.csv"
```

一致性检查：

```powershell
python scripts/check_firmware_consistency.py
```
