BruceKe365/STM32F411-PPG-Pulse-Monitor/training_dataset/reports/full_stress_train_validation_20260629_current/reports/local_ppg_stress_index.csv

file | window_idx | start_s | end_s | stress_probability | stress_index | level | valid_interval_count | mean_hr_bpm | mean_ppi_ms | sdnn_ms | rmssd_ms | sdsd_ms | pnn20_pct | pnn50_pct | cv_ppi | median_abs_delta_ms | p80_abs_delta_ms | p95_abs_delta_ms | outlier_frac | error
testing dataset\02_手指稳定初测\processed.csv | 0 | 880.0 | 920.0 | 0.995767 | 93 | high | 28.0 | 85.396228 | 702.607143 | 301.314446 | 403.540718 | 411.221663 | 88.888889 | 81.481481 | 0.428852 | 180.0 | 276.2 | 1012.7 | 0.142857
testing dataset\02_手指稳定初测\replay_v2_processed.csv | 0 | 880.0 | 920.0 | 0.982449 | 93 | high | 41.0 | 76.06679 | 788.780488 | 314.675985 | 508.047734 | 514.509413 | 92.5 | 77.5 | 0.39894 | 110.0 | 356.0 | 1087.0 | 0.121951
testing dataset\03_手指稳定心率调参\processed.csv | 0 | 1220.0 | 1260.0 | 0.823421 | 85 | high | 58.0 | 90.225564 | 665.0 | 196.444269 | 251.064401 | 253.288645 | 91.22807 | 78.947368 | 0.295405 | 100.0 | 270.0 | 654.0 | 0.137931
testing dataset\03_手指稳定心率调参\replay_min550_processed.csv | 0 | 1220.0 | 1260.0 | 0.663889 | 77 | medium | 54.0 | 84.003111 | 714.259259 | 179.670578 | 230.945554 | 233.124483 | 86.792453 | 67.924528 | 0.251548 | 90.0 | 166.0 | 668.0 | 0.055556
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
