BruceKe365/STM32F411-PPG-Pulse-Monitor/testing dataset/本地采集数据集说明.md

# 本地 MAX30102 采集与回放数据说明

更新时间：2026-06-29

本目录保存本项目使用 STM32F411 + MAX30102 实际采集的 PPG 数据，以及使用 PC 脚本对这些数据进行离线回放后生成的结果。这里主要用于验证：

- 原始红光、红外 PPG 数据是否连续；
- 手指检测、心率、血氧是否稳定；
- 可靠峰值和 PPI 是否存在假峰、漏峰；
- 0.91 寸 OLED 波形显示是否正常；
- AF 风险和压力指数的实机输入质量与稳定策略。

本目录与 `training_dataset/` 的职责不同：

| 目录 | 内容 |
| --- | --- |
| `testing dataset/` | 本机 MAX30102 实际采集、PC 离线回放、硬件和算法边界测试。 |
| `training_dataset/` | PhysioNet、WESAD 等公开数据集，模型参数和全量验证报告。 |

> 本目录没有真实 AF 患者 PPG，也没有经过实验标签确认的心理压力训练数据。这里的数据只能作为本地正常/边界烟测，不能当作 AF 阳性或 Stress 标签训练集。

## 2026-06-24 中文命名和归档状态

本目录已按“编号 + 中文概括”的方式整理。目录编号保持不变，方便和历史报告、采集顺序、回放结果互相对应；中文名称概括了采集来源、测试场景或验证目的。

根目录原本散落的 4 个诊断 CSV 已归档到：

```text
00_串口烟测与原始数据检查/根目录诊断CSV归档/
```

归档文件：

| 文件 | 含义 |
| --- | --- |
| `diag_30s.csv` | 早期 30s 串口诊断采集。 |
| `diag_30s_repeat.csv` | 早期 30s 串口诊断重复采集。 |
| `diag_30s_waveform.csv` | 带波形相关字段的早期 30s 串口诊断采集。 |
| `diag_preflash_20260611.csv` | 2026-06-11 烧录前串口诊断快照。 |

## 2026-06-23 验收封版状态

本地采集数据已随项目验收版本封版。最后一轮有效采集完成于 2026-06-17；截至 2026-06-23，没有新增采集、重新标注或覆盖旧数据。

验收最重要的三组数据：

```text
112_subject_A_pressure_baseline_light_stable_20260617_140429/
113_subject_A_pressure_baseline_light_stable_20260617_141049/
114_subject_B_af_high_review_20260617_144713/
```

| 目录 | 用途 |
| --- | --- |
| `112_*` | subject_A 90 s 稳定轻触压力基线，9001 个样本，无丢样。 |
| `113_*` | 第二组 90 s 稳定轻触压力基线，9001 个样本，无丢样。 |
| `114_*` | subject_B 90 s 采集，用于排查 HR/SpO2 稳定但 AF 偶发跳到 90%--100% 的问题。 |

封版规则：

- 不要修改、覆盖或重新生成已封版 CSV/JSON 数据内容。
- 若后续再次改目录名，必须同步修改本文、`AI助手接手？先读我.md` 和相关功能详细总结中的引用。
- 不要根据单个本地文件直接下最终结论。
- AF 和压力的当前结果应查看 `training_dataset/reports/full_*_20260629_current/`。
- 本地 CSV 用于解释数据链、复现问题和验证门控，不替代公开数据集训练验证。

## 数据目录总表

| 目录 | 数据形式 | 采集/来源情况 | 主要测试内容 |
| --- | --- | --- | --- |
| `00_串口烟测与原始数据检查` | 串口诊断 CSV、raw/processed 历史检查 | 早期串口连通、原始输出和根目录散落 CSV 归档 | 确认 USB CDC 输出、raw 字段、诊断脚本能读数据。 |
| `01_无手指基线` | 本地实采 raw/processed/events/summary | 传感器前无手指 | 无手指时 HR/SpO2 应为空，检查基线和手指检测下限。 |
| `02_手指稳定初测` | 本地实采 | 手指稳定放置的早期初测 | 验证 PPG 波形、基础 HR/SpO2 计算是否能出值。 |
| `03_手指稳定心率调参` | 本地实采 | 手指稳定放置，用于心率参数调整 | 调整滤波、峰值、自相关和心率显示策略。 |
| `04_延迟接触预热测试` | 本地实采 + 多版 replay | 先空放再延迟放上手指 | 验证预热、首次显示、接触变化后的结果清空/恢复。 |
| `05_稳定心率良好参考` | 本地实采 | 手指稳定、波形较好 | 作为早期较好的稳定 HR 参考样本。 |
| `06_强按低质量血氧空白` | 本地实采 | 手指强按导致波形质量差 | 验证强按时 SpO2 质量门控应显示空白，HR 可作为辅助观察。 |
| `07_手表97血氧参考` | 本地实采 | 与手表约 97% SpO2 对照 | 用于血氧经验标定和显示合理性参考。 |
| `08_轻触首次良好数据` | 本地实采 | 轻触压力下首次得到较好结果 | 验证轻触姿势下 HR/SpO2 稳定性。 |
| `09_强按血氧空白复核` | 本地实采 + replay | 再次强按采集 | 复核低质量 SpO2 空白策略，排查强按伪迹。 |
| `10_轻触最佳稳定参考` | 本地实采 | 轻触稳定，质量较好 | 作为 HR/SpO2 稳定参考和后续回放基准。 |
| `11_轻触重复确认` | 本地实采 | 对第 10 组轻触状态重复采集 | 验证同类场景可重复性。 |
| `12_轻触最终检查` | 本地实采 | 轻触稳定最终确认 | 验证验收前 HR/SpO2 基础链路。 |
| `13_无手指再放上预热` | 本地实采 | 开始无手指，随后放上 | 验证无手指到有效接触的预热和首次显示。 |
| `14_测量中移开手指` | 本地实采 | 先正常测量，随后移开 | 验证移开手指后 HR/SpO2/波形应及时清空。 |
| `15_MCU_C版V3串口烟测失败` | 故障烟测记录 | MCU C 版 V3 烧录后串口未采到有效样本 | 记录 COM7 打开/枚举失败，不作为算法有效数据。 |
| `16_MCU_C修复后串口烟测失败` | 故障烟测记录 | 修复后再次串口烟测但仍失败 | 记录串口问题排查过程。 |
| `17_MCU_C重插后烟测` | 串口烟测 | 重插 Type-C 后再测 | 验证重插 Type-C 对 COM7 恢复的作用。 |
| `18_MCU_C对齐后串口烟测失败` | 故障烟测记录 | 对齐参数/代码后串口仍失败 | 记录烧录后串口异常边界。 |
| `19_串口重插第1次` | 串口恢复实测 | 第一次重插恢复验证 | 验证 COM7 重插恢复流程。 |
| `20_串口重插第2次` | 串口恢复实测 | 第二次重插恢复验证 | 复核 COM7 恢复流程。 |
| `21_定时修复后串口重插第1次` | 串口恢复实测 | 定时修复后第一次重插验证 | 验证采样定时修复后串口行为。 |
| `22_定时修复后串口重插第2次` | 串口恢复实测 | 定时修复后第二次重插验证 | 复核定时修复后的串口稳定性。 |
| `90_当前算法回放验证` | 离线 replay | 使用当时当前算法回放旧 raw | 验证算法版本迁移后的 HR/SpO2 行为。 |
| `91_血氧质量门控回放验证` | 离线 replay | 针对 SpO2 质量门控重放 | 检查低质量时血氧是否正确空白。 |
| `92_心率范围和血氧加1回放` | 离线 replay | 心率范围和 SpO2 公式调整后的回放 | 验证 HR 有效范围与 SpO2 显示修正。 |
| `93_预热峰值回放验证` | 离线 replay | 预热和峰值策略调整后的回放 | 检查 warmup、可靠峰、首次输出。 |
| `94_最新烧录后串口验证` | 串口烟测 | 最新固件烧录后串口检查 | 验证烧录后 COM7 行为。 |
| `95_当前固件烧录串口复测` | 串口烟测 | 当前固件重新烧录后复测 | 记录烧录成功但未重插时的串口问题。 |
| `96_不重新烧录串口复测` | 串口烟测 | 不重新烧录，仅串口重复测试 | 区分固件问题和 USB CDC 枚举问题。 |
| `97_10秒预热回放验证` | 离线 replay | 10s warmup 方案回放 | 验证缩短预热后的首出值和稳定性。 |
| `98_心率10秒血氧20秒回放验证` | 离线 replay + 汇总 CSV | HR 10s、SpO2 20s 策略回放 | 对比多组 raw 在新预热策略下的结果。 |
| `99_手指放上移开完整实测` | 本地实采 + replay | 无手指、放手指、移开手指完整流程 | 验证现场流程、预热、清空和回放一致性。 |
| `100_60秒提示放手移手空采集` | 采集尝试 | 提示式 60s 流程但未得到可用 raw | 记录采集失败/空采集，不作为算法有效数据。 |
| `101_60秒提示放手移手实测` | 本地实采 + replay | 提示式 60s 放手/移手流程 | 验证完整交互流程和鲁棒回放。 |
| `102_后台采集不重定向检查` | 工具/环境检查 | 后台采集输出检查 | 排查采集脚本输出重定向和后台运行问题。 |
| `103_随机放手移手实测_旧确认前` | 本地实采 | 随机放上/移开，加入 HR 首次确认前 | 作为旧策略对照，观察误触发和不稳定输出。 |
| `104_心率确认策略回放验证` | 离线 replay | HR 首次确认策略回放 | 验证 3 个候选一致后再显示的策略。 |
| `105_随机放手移手实测_心率确认后` | 本地实采 | 随机放上/移开，加入 HR 首次确认后 | 验证新确认策略在实测中的稳定性。 |
| `106_波形预览回放` | OLED 波形 replay | 使用 processed 数据生成波形预览 | 检查 0.91 寸波形显示样式。 |
| `107_波形同步检查` | OLED 波形 replay | 波形列推进和峰标记同步检查 | 验证小屏显示与 PPG 峰值同步。 |
| `108_40秒实测波形绘图` | 本地实采 + 图形输出 | 40s 实测波形源数据 | 用于画图检查 PPG 形态和峰值位置。 |
| `109_波形显示条件处理` | OLED 波形 replay | 只在有效 HR/PPG 后显示波形 | 验证无效阶段 Pause/Loading 和有效阶段滚动波形。 |
| `110_固定脉冲风格波形` | OLED 波形样式 replay | 固定脉冲高度风格尝试 | 比较小屏视觉效果，不代表算法主路径。 |
| `111_有界归一化波形` | OLED 波形样式 replay | 有界归一化可变高度风格 | 当前较接近最终小屏波形参考。 |
| `112_subject_A_pressure_baseline_light_stable_20260617_140429` | 本地 90s 实采 + processed/replay | subject_A 轻触稳定压力基线，约 9001 样本 | Stress 本地基线、AF/Stress PPI 质量门控验证。 |
| `113_subject_A_pressure_baseline_light_stable_20260617_141049` | 本地 90s 实采 + processed/replay | subject_A 第二组轻触稳定压力基线，约 9001 样本 | 复核压力基线和长窗口 PPI 稳定性。 |
| `114_subject_B_af_high_review_20260617_144713` | 本地 90s 实采 + processed/replay | subject_B 采集，HR/SpO2 稳定但 AF 偶发高值 | 排查可靠峰、PPI 假峰、AF 上跳保持和质量门控。 |

## 每个采集目录中常见的文件

不同阶段的文件名略有差异，例如早期可能使用 `processed.csv`，后期可能使用 `raw_processed.csv`。判断文件类型时以内容和后缀为主。

| 文件形式 | 内容 | 推荐用途 |
| --- | --- | --- |
| `raw.csv`、`*_raw.csv` | STM32 USB CDC 输出的原始红光/红外样本。 | 检查丢样、原始波形、传感器光强。 |
| `processed.csv`、`*_processed.csv` | PC 算法逐样本处理结果。 | 最常用；查看滤波波形、质量、HR、SpO2、峰值和 PPI。 |
| `events.csv`、`*_events.csv` | 人工事件标记。 | 对齐“放手指”“移开手指”等实验动作。 |
| `summary.json`、`*_summary.json` | 一次采集或回放的汇总统计。 | 首先阅读；快速判断时长、样本数、丢样和最终结果。 |
| `replay_*`、`*_replay_*` | 使用不同参数对已有 raw 数据离线回放的结果。 | 比较算法版本，不代表重新采集。 |
| `frames/` | OLED 波形预览帧和列推进记录。 | 检查小屏波形样式和峰值标记。 |

## 推荐查看顺序

面对一个采集目录时，建议按以下顺序阅读：

1. 打开 `summary.json`，确认采集时长、样本数、参数和丢样情况。
2. 打开最新的 `*_processed.csv`，查看 `finger_present`、`finger_score`、`hr_bpm`、`spo2`。
3. 检查 `peak` 和 `peak_interval_ms`，判断是否存在假峰或漏峰。
4. 需要查看传感器原始状态时，再打开 `raw.csv` 的 `red`、`ir`。
5. 如果同目录存在多个 `replay_*`，根据文件名确认使用的参数，不要混合比较。
6. 最终 AF/压力结论回到 `training_dataset/reports/` 的全量报告查看。

## 如何看 `summary.json`

以 `112_subject_A_pressure_baseline_light_stable_20260617_140429/raw_summary.json` 为例，主要字段如下：

| JSON 字段 | 含义 | 正常判断 |
| --- | --- | --- |
| `elapsed_s` | 实际采集时长。 | 90 s 采集应接近 90。 |
| `samples` | 样本总数。 | 100 Hz、90 s 应约为 9000。 |
| `parameters` | 本次 PC 处理使用的阈值和滤波参数。 | 比较 replay 时先确认参数是否一致。 |
| `data_quality.missing_sample_count` | 根据 `sample_count` 检测的丢样数。 | 理想值为 0。 |
| `data_quality.nonmonotonic_sample_count` | 样本序号是否倒退。 | 理想值为 0。 |
| `data_quality.sample_count_gap` | 相邻样本序号差。 | 正常应始终为 1。 |
| `raw_stats` | 红光、红外原始值统计。 | 用于判断光强和接触变化。 |
| `processed_stats` | RMS、质量分、HR、SpO2 等统计。 | 用于快速判断整段稳定性。 |
| `final` 或最终状态字段 | 结束时的手指、HR、SpO2 状态。 | 移开手指后显示为空是正常行为。 |

不要只看 JSON 中的最大值。瞬时最大值可能来自接触变化或伪迹，应结合中位数、标准差和 processed CSV 的时间序列判断。

## 如何看原始 `raw.csv`

后期标准 raw 表头：

```text
session_id,label,pc_time,t_ms,red,ir,irq_count,sample_count
```

| 列 | 含义 |
| --- | --- |
| `session_id` | 本次采集或回放的会话标识。 |
| `label` | 人工设置的场景标签。 |
| `pc_time` | PC 收到该行数据的时间。 |
| `t_ms` | MCU 运行时间戳，单位 ms。USB 缓冲会使其间隔略有波动。 |
| `red` | MAX30102 红光原始 ADC 值。 |
| `ir` | MAX30102 红外原始 ADC 值，是心率和峰值分析的主要输入。 |
| `irq_count` | 传感器中断累计次数。 |
| `sample_count` | MCU 样本累计序号，是判断是否丢样的首选字段。 |

### 原始数据首先检查什么

1. `sample_count` 应严格递增，相邻差通常为 1。
2. 100 Hz 采样时，90 s 数据应约有 9000 行。
3. `red`、`ir` 放上手指后应明显高于无手指状态，并存在周期性小幅波动。
4. 判断真实采样连续性时优先使用 `sample_count`，不要只看 `pc_time` 或 `t_ms`。
5. USB 一次可能批量发送多行，因此 `pc_time` 或 `t_ms` 的瞬时间隔不完全等于 10 ms，不一定表示丢样。

## 如何看处理后的 `processed.csv`

较新的 processed CSV 表头：

```text
session_id,label,pc_time,t_ms,sample_time_ms,sample_count,
red,ir,fs_hz,red_dc,ir_dc,red_ac,ir_ac,red_filt,ir_filt,
red_rms,ir_rms,finger_score,finger_present,hr_confirmed,
hr_bpm,hr_peak_bpm,hr_autocorr_bpm,spo2,ratio,peak,peak_interval_ms
```

旧文件可能缺少 `sample_time_ms`、`hr_confirmed` 或部分诊断列，这是历史格式差异，不代表文件损坏。

### 信号处理列

| 列 | 含义 | 怎么看 |
| --- | --- | --- |
| `sample_time_ms` | 用 `sample_count × 10 ms` 得到的等间隔时间。 | 画图横轴优先使用它。 |
| `fs_hz` | 估计采样率。 | 稳定阶段应接近 100 Hz。 |
| `red_dc`、`ir_dc` | 红光/红外直流基线。 | 反映手指接触和慢变化。 |
| `red_ac`、`ir_ac` | 去除直流基线后的脉动分量。 | 包含脉搏和噪声。 |
| `red_filt`、`ir_filt` | 进一步平滑后的 PPG。 | 查看波形、峰值时优先使用 `ir_filt`。 |
| `red_rms`、`ir_rms` | 滚动窗口内的交流幅度。 | 过低表示脉动弱，突然升高可能是运动伪迹。 |

### 手指和质量列

| 列 | 含义 | 怎么看 |
| --- | --- | --- |
| `finger_present` | 是否检测到手指，0/1。 | 分析有效测量时先筛选为 1。 |
| `finger_score` | 综合 DC 和 AC 幅度的质量分。 | SpO2 通常要求不低于 4；越大不代表无限更好。 |
| `hr_confirmed` | 首次心率是否通过多候选确认。 | 为 0 时 HR 空白属于正常预热。 |

### 心率和血氧列

| 列 | 含义 | 怎么看 |
| --- | --- | --- |
| `hr_bpm` | 最终稳定后的显示心率。 | 这是验收时主要查看的 HR。 |
| `hr_autocorr_bpm` | 当前自相关心率候选。 | 可用于分析 HR 为什么更新或不更新。 |
| `hr_peak_bpm` | 由峰间期直接估计的辅助心率。 | 对假峰/漏峰敏感，不是最终显示值。 |
| `spo2` | 质量门控后的血氧结果。 | 预热或质量差时空白是设计行为。 |
| `ratio` | 红光/红外 AC/DC 比值。 | 血氧公式的中间量，不直接当血氧读数。 |

### 可靠峰和 PPI 列

| 列 | 含义 | 怎么看 |
| --- | --- | --- |
| `peak` | 当前样本是否被可靠峰检测器接受，0/1。 | 将 `peak=1` 的点叠加到 `ir_filt` 上检查峰位置。 |
| `peak_interval_ms` | 本次峰与上次可靠峰之间的时间。 | 是 AF 和压力 HRV 的 PPI 输入。 |

PPI 与心率大致满足：

```text
PPI_expected_ms = 60000 / hr_bpm
```

例如：

| 心率 | 期望 PPI |
| ---: | ---: |
| 60 bpm | 约 1000 ms |
| 75 bpm | 约 800 ms |
| 100 bpm | 约 600 ms |
| 120 bpm | 约 500 ms |

如果连续出现约一半的 PPI，常见原因是同一拍内检测到两个峰；如果出现约两倍的 PPI，常见原因是漏掉一拍。AF 偶发假高通常应先检查这里。

## 为什么 CSV 中会有空白值

空白不一定是错误，以下情况会主动不输出结果：

- 刚放上手指，HR 和 SpO2 还在预热；
- 心率首次 3 个自相关候选尚未满足一致性；
- `finger_present=0`；
- `finger_score` 太低；
- 红光/红外比值超出血氧有效范围；
- 可靠峰不足，尚不能形成 PPI；
- HRV 窗口长度不足；
- 异常 PPI 比例超过质量门限。

因此不要把空白直接填成 0。0 bpm、0% SpO2 与“当前没有可信结果”含义完全不同。

## 用 Excel 或表格软件快速查看

### 查看心率与血氧

1. 打开 `*_processed.csv`。
2. 筛选 `finger_present=1`。
3. 观察 `hr_bpm`、`spo2` 是否在预热后出现。
4. 对 `hr_bpm` 和 `spo2` 分别插入折线图。
5. 横轴使用 `sample_time_ms`，再除以 1000 可得到秒。

### 查看 PPG 波形

1. 横轴选 `sample_time_ms`。
2. 纵轴选 `ir_filt`。
3. 只截取 10--20 s 范围，避免 9000 行数据在一张图中挤成色块。
4. 再筛选 `peak=1`，检查峰是否落在每个脉搏主峰附近。

### 查看 PPI 是否异常

1. 筛选 `peak=1`。
2. 只保留 `sample_time_ms`、`hr_bpm`、`peak_interval_ms`。
3. 计算或心算 `60000/hr_bpm`。
4. 对比实际 `peak_interval_ms` 是否频繁接近期望值的一半或两倍。

## 用 Python 快速画图

项目环境安装了 `pandas` 和 `matplotlib` 时，可在项目根目录运行：

```python
from pathlib import Path

import matplotlib.pyplot as plt
import pandas as pd

path = Path(
    "testing dataset/"
    "112_subject_A_pressure_baseline_light_stable_20260617_140429/"
    "raw_processed.csv"
)

df = pd.read_csv(path)
df["time_s"] = df["sample_time_ms"] / 1000.0

fig, axes = plt.subplots(3, 1, sharex=True, figsize=(12, 8))

axes[0].plot(df["time_s"], df["ir_filt"], linewidth=0.8)
peaks = df[df["peak"] == 1]
axes[0].scatter(
    peaks["time_s"],
    peaks["ir_filt"],
    s=12,
    color="red",
    label="可靠峰",
)
axes[0].set_ylabel("IR filtered")
axes[0].legend()

axes[1].plot(df["time_s"], df["hr_bpm"], label="HR")
axes[1].set_ylabel("bpm")

axes[2].plot(df["time_s"], df["spo2"], label="SpO2")
axes[2].set_ylabel("%")
axes[2].set_xlabel("time / s")

plt.tight_layout()
plt.show()
```

查看 PPI：

```python
valid_peaks = df.loc[
    (df["peak"] == 1) & df["peak_interval_ms"].notna(),
    ["time_s", "hr_bpm", "peak_interval_ms"],
]

valid_peaks["expected_ppi_ms"] = 60000.0 / valid_peaks["hr_bpm"]
valid_peaks["ppi_ratio"] = (
    valid_peaks["peak_interval_ms"] / valid_peaks["expected_ppi_ms"]
)

print(valid_peaks.tail(30).to_string(index=False))
```

`ppi_ratio` 接近 1 表示 PPI 与当前心率一致；偶发异常需要结合前后波形判断，连续明显偏离才更值得排查。

## 如何看事件和其他 CSV

事件文件的标准表头：

```text
session_id,pc_time,event_s,event_label
```

| 列 | 含义 |
| --- | --- |
| `event_s` | 相对采集开始的事件时间，单位 s。 |
| `event_label` | 人工事件说明，例如放上手指、移开手指或改变按压力度。 |

如果事件文件只有表头，表示本次采集没有人工标记，不是文件损坏。

目录中还可能存在以下非逐样本 CSV：

| 文件形式 | 内容 |
| --- | --- |
| `*_comparison.csv`、`*_ranges.csv` | 不同算法参数或预热时间的汇总对比。 |
| `waveform_columns.csv` | OLED 每一列的坐标、模式、滤波值和峰标记。 |
| `*_summary.csv` | 多个文件或窗口的统计汇总。 |

判断方法很简单：先看第一行表头。包含 `red,ir,sample_count` 的通常是采样数据；包含 `case`、`group`、`mean`、`median` 等字段的通常是实验汇总，不应按 PPG 波形绘制。

## 重点采集目录

### 基础心率/血氧参考

| 目录 | 说明 |
| --- | --- |
| `01_无手指基线` | 无手指基线，HR/SpO2 应为空。 |
| `05_稳定心率良好参考` | 早期较好的稳定心率参考。 |
| `07_手表97血氧参考` | 参考手表约 97%，用于血氧经验标定。 |
| `10_轻触最佳稳定参考` | 轻触稳定参考，HR 和 SpO2 表现较好。 |
| `11_轻触重复确认` | 对第 10 组的重复确认。 |
| `12_轻触最终检查` | 轻触最终检查。 |
| `99_手指放上移开完整实测` | 无手指、放手指、移开手指的完整流程。 |
| `105_随机放手移手实测_心率确认后` | 加入首次 HR 确认后的 90 s 实测。 |

### 信号质量边界

| 目录 | 说明 |
| --- | --- |
| `06_强按低质量血氧空白` | 强按导致质量差；HR 可能可用，SpO2 应为空。 |
| `09_强按血氧空白复核` | 再次确认强按情况下血氧门控。 |
| `13_无手指再放上预热` | 先无手指再放上，验证预热和首次显示。 |
| `14_测量中移开手指` | 先测量再移开，验证立即清空。 |
| `103_随机放手移手实测_旧确认前` | 首次 HR 确认策略加入前的对照数据。 |

### OLED 波形参考

| 目录 | 说明 |
| --- | --- |
| `108_40秒实测波形绘图` | 40 s 实测波形源数据。 |
| `109_波形显示条件处理` | 显示专用平滑与增益处理回放。 |
| `110_固定脉冲风格波形` | 固定脉冲风格尝试。 |
| `111_有界归一化波形` | 当前有界归一化可变高度波形参考。 |

### AF 与压力最终参考

| 目录 | 说明 |
| --- | --- |
| `112_subject_A_pressure_baseline_light_stable_20260617_140429` | 第一组压力正常基线。 |
| `113_subject_A_pressure_baseline_light_stable_20260617_141049` | 第二组压力正常基线。 |
| `114_subject_B_af_high_review_20260617_144713` | AF 假高排查，重点检查可靠峰和 PPI。 |

## 历史和故障记录如何理解

部分目录保存的是失败实验，不能当作算法有效数据：

| 目录 | 正确解释 |
| --- | --- |
| `15_MCU_C版V3串口烟测失败` | 烧录后 COM7 打开失败，0 样本。 |
| `16_MCU_C修复后串口烟测失败` | COM7 打开卡住，0 样本。 |
| `18_MCU_C对齐后串口烟测失败` | 烧录后 COM7 再次卡住，0 样本。 |
| `95_当前固件烧录串口复测` | 最新固件烧录成功，但未重插 Type-C 时串口失败。 |
| `100_60秒提示放手移手空采集` | 空采集尝试，没有可用 raw 数据。 |

这些目录证明的是 Windows USB CDC 重新枚举问题，不代表 MAX30102 数据格式或算法损坏。烧录/OpenOCD reset 后若 COM7 可见但无法打开，应先重插 Black Pill Type-C。

## 当前固件与硬件说明

验收定稿固件串口宏：

```text
RAW_STREAM_USB_ENABLE=1
DIAG_STREAM_USB_ENABLE=0
PPG_PROC_STREAM_USB_ENABLE=1
```

因此 COM7 可以输出：

- 逐样本 raw CSV：`t_ms,red,ir,irq_count,sample_count`；
- 周期性 `PPG_PROC` 处理诊断，包含 HR、SpO2、AF、压力和 PPI 状态。

当前显示预热：

- HR：15 s；
- SpO2：20 s。

当前 I2C：

- I2C1：0.96 寸 OLED，400 kHz；
- I2C2：0.91 寸 OLED，400 kHz；
- I2C3：MAX30102，100 kHz。

如果 OLED 波形再次出现卡顿，先检查 `Core/Src/i2c.c` 的 I2C 速率，不要先修改 HR/SpO2 算法。

## 当前本地回放结果

AF 本地正常 PPG 的 MCU 等价验证：

```text
valid=33/292
median=0%
mean=3.212%
ge80=3.030%
```

压力本地回放：

```text
files=130
windows=52
displayed_windows=25
display_median=48
display_max=53
```

这些结果说明本地正常数据在可靠峰、PPI 质量门控和结果保持策略加入后更稳定，但有效长窗口数量仍有限。

## 最后提醒

- 轻触通常比强按更容易得到稳定的 HR 和 SpO2。
- 强按时 HR 可能仍可计算，但 SpO2 应因质量不足显示 `--`。
- 分析 AF 假高时先查 `peak_interval_ms`，不要直接改模型概率。
- 分析压力偏高时先检查高心率、窗口质量和 PPI 异常。
- 不要把空白值替换成 0。
- 不要把 `testing dataset/` 移入 `training_dataset/`，当前脚本按这两个目录的职责读取数据。
- 最终项目状态以 `AI助手接手？先读我.md`、当前 `Core/Src/main.c` 和 `training_dataset/reports/full_*_20260629_current/` 为准。
