BruceKe365/STM32F411-PPG-Pulse-Monitor/testing dataset/13_无手指再放上预热/events.csv

session_id | pc_time | event_s | event_label
raw | 2026-05-27T23:21:25.318 | 0.0 | no_finger
raw | 2026-05-27T23:21:25.318 | 20.0 | finger_light_on_prompt
