BruceKe365/STM32F411-PPG-Pulse-Monitor/testing dataset/13_无手指再放上预热/processed.csv

hu'li'haohulihaosession_id | label | pc_time | t_ms | sample_count | red | ir | fs_hz | red_dc | ir_dc | red_ac | ir_ac | red_filt | ir_filt | red_rms | ir_rms | finger_score | finger_present | hr_bpm | hr_peak_bpm | hr_autocorr_bpm | spo2 | ratio | peak | peak_interval_ms
raw | no_finger_then_light_on | 2026-05-27T23:21:25.321 | 899185 | 89879 | 347 | 299 |  | 347.0 | 299.0 | 0.0 | 0.0 | 0.0 | 0.0 |  |  |  | 0 |  |  |  |  |  | 0
raw | no_finger_then_light_on | 2026-05-27T23:21:25.331 | 899195 | 89880 | 344 | 293 |  | 344.0 | 293.0 | 0.0 | 0.0 | 0.0 | 0.0 |  |  |  | 0 |  |  |  |  |  | 0
raw | no_finger_then_light_on | 2026-05-27T23:21:25.341 | 899205 | 89881 | 348 | 293 |  | 348.0 | 293.0 | 0.0 | 0.0 | 0.0 | 0.0 |  |  |  | 0 |  |  |  |  |  | 0
raw | no_finger_then_light_on | 2026-05-27T23:21:25.351 | 899215 | 89882 | 340 | 304 |  | 340.0 | 304.0 | 0.0 | 0.0 | 0.0 | 0.0 |  |  |  | 0 |  |  |  |  |  | 0
raw | no_finger_then_light_on | 2026-05-27T23:21:25.361 | 899225 | 89883 | 348 | 297 |  | 348.0 | 297.0 | 0.0 | 0.0 | 0.0 | 0.0 |  |  |  | 0 |  |  |  |  |  | 0
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
