BruceKe365/STM32F411-PPG-Pulse-Monitor/testing dataset/13_无手指再放上预热/raw.csv

session_id | label | pc_time | t_ms | red | ir | irq_count | sample_count
raw | no_finger_then_light_on | 2026-05-27T23:21:25.321 | 899185 | 347 | 299 | 80546 | 89879
raw | no_finger_then_light_on | 2026-05-27T23:21:25.331 | 899195 | 344 | 293 | 80547 | 89880
raw | no_finger_then_light_on | 2026-05-27T23:21:25.341 | 899205 | 348 | 293 | 80548 | 89881
raw | no_finger_then_light_on | 2026-05-27T23:21:25.351 | 899215 | 340 | 304 | 80549 | 89882
raw | no_finger_then_light_on | 2026-05-27T23:21:25.361 | 899225 | 348 | 297 | 80550 | 89883
raw | no_finger_then_light_on | 2026-05-27T23:21:25.371 | 899235 | 344 | 301 | 80551 | 89884
raw | no_finger_then_light_on | 2026-05-27T23:21:25.381 | 899245 | 343 | 293 | 80552 | 89885
raw | no_finger_then_light_on | 2026-05-27T23:21:25.391 | 899255 | 342 | 294 | 80553 | 89886
raw | no_finger_then_light_on | 2026-05-27T23:21:25.401 | 899265 | 350 | 293 | 80554 | 89887
raw | no_finger_then_light_on | 2026-05-27T23:21:25.411 | 899275 | 343 | 292 | 80555 | 89888
raw | no_finger_then_light_on | 2026-05-27T23:21:25.421 | 899285 | 347 | 289 | 80556 | 89889
raw | no_finger_then_light_on | 2026-05-27T23:21:25.431 | 899295 | 347 | 296 | 80557 | 89890
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
