BruceKe365/STM32F411-PPG-Pulse-Monitor/testing dataset/14_测量中移开手指/processed.csv

session_id | label | pc_time | t_ms | sample_count | red | ir | fs_hz | red_dc | ir_dc | red_ac | ir_ac | red_filt | ir_filt | red_rms | ir_rms | finger_score | finger_present | hr_bpm | hr_peak_bpm | hr_autocorr_bpm | spo2 | ratio | peak | peak_interval_ms
raw | light_on_then_no_finger | 2026-05-27T23:27:59.707 | 1293588 | 129332 | 326 | 291 |  | 326.0 | 291.0 | 0.0 | 0.0 | 0.0 | 0.0 |  |  |  | 0 |  |  |  |  |  | 0
raw | light_on_then_no_finger | 2026-05-27T23:27:59.717 | 1293598 | 129333 | 328 | 281 |  | 328.0 | 281.0 | 0.0 | 0.0 | 0.0 | 0.0 |  |  |  | 0 |  |  |  |  |  | 0
raw | light_on_then_no_finger | 2026-05-27T23:27:59.727 | 1293608 | 129334 | 323 | 287 |  | 323.0 | 287.0 | 0.0 | 0.0 | 0.0 | 0.0 |  |  |  | 0 |  |  |  |  |  | 0
raw | light_on_then_no_finger | 2026-05-27T23:27:59.737 | 1293618 | 129335 | 321 | 285 |  | 321.0 | 285.0 | 0.0 | 0.0 | 0.0 | 0.0 |  |  |  | 0 |  |  |  |  |  | 0
raw | light_on_then_no_finger | 2026-05-27T23:27:59.747 | 1293628 | 129336 | 323 | 287 |  | 323.0 | 287.0 | 0.0 | 0.0 | 0.0 | 0.0 |  |  |  | 0 |  |  |  |  |  | 0
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
