BruceKe365/STM32F411-PPG-Pulse-Monitor/testing dataset/14_测量中移开手指/raw.csv

session_id | label | pc_time | t_ms | red | ir | irq_count | sample_count
raw | light_on_then_no_finger | 2026-05-27T23:27:59.707 | 1293588 | 326 | 291 | 115901 | 129332
raw | light_on_then_no_finger | 2026-05-27T23:27:59.717 | 1293598 | 328 | 281 | 115902 | 129333
raw | light_on_then_no_finger | 2026-05-27T23:27:59.727 | 1293608 | 323 | 287 | 115903 | 129334
raw | light_on_then_no_finger | 2026-05-27T23:27:59.737 | 1293618 | 321 | 285 | 115904 | 129335
raw | light_on_then_no_finger | 2026-05-27T23:27:59.747 | 1293628 | 323 | 287 | 115905 | 129336
raw | light_on_then_no_finger | 2026-05-27T23:27:59.757 | 1293638 | 323 | 283 | 115906 | 129337
raw | light_on_then_no_finger | 2026-05-27T23:27:59.767 | 1293648 | 325 | 289 | 115907 | 129338
raw | light_on_then_no_finger | 2026-05-27T23:27:59.777 | 1293658 | 316 | 287 | 115908 | 129339
raw | light_on_then_no_finger | 2026-05-27T23:27:59.787 | 1293668 | 323 | 284 | 115909 | 129340
raw | light_on_then_no_finger | 2026-05-27T23:27:59.797 | 1293678 | 328 | 281 | 115910 | 129341
raw | light_on_then_no_finger | 2026-05-27T23:27:59.807 | 1293688 | 326 | 287 | 115911 | 129342
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
