BruceKe365/STM32F411-PPG-Pulse-Monitor/testing dataset/15_MCU_C版V3串口烟测失败/events.csv

session_id | pc_time | event_s | event_label
raw | 2026-05-28T00:21:04.672 | 0.0 | smoke_no_finger
