BruceKe365/STM32F411-PPG-Pulse-Monitor/testing dataset/16_MCU_C修复后串口烟测失败/events.csv

session_id | pc_time | event_s | event_label
raw | 2026-05-28T00:57:07.955 | 0.0 | smoke
