BruceKe365/STM32F411-PPG-Pulse-Monitor/testing dataset/17_MCU_C重插后烟测/events.csv

session_id | pc_time | event_s | event_label
raw | 2026-05-28T01:02:18.755 | 0.0 | after_replug
