BruceKe365/STM32F411-PPG-Pulse-Monitor/testing dataset/17_MCU_C重插后烟测/processed.csv

session_id | label | pc_time | t_ms | sample_count | red | ir | fs_hz | red_dc | ir_dc | red_ac | ir_ac | red_filt | ir_filt | red_rms | ir_rms | finger_score | finger_present | hr_bpm | hr_peak_bpm | hr_autocorr_bpm | spo2 | ratio | peak | peak_interval_ms
raw | mcu_c_after_replug | 2026-05-28T01:02:18.758 | 91279 | 9053 | 417 | 333 |  | 417.0 | 333.0 | 0.0 | 0.0 | 0.0 | 0.0 |  |  |  | 0 |  |  |  |  |  | 0
raw | mcu_c_after_replug | 2026-05-28T01:02:18.768 | 91289 | 9054 | 416 | 329 |  | 416.0 | 329.0 | 0.0 | 0.0 | 0.0 | 0.0 |  |  |  | 0 |  |  |  |  |  | 0
raw | mcu_c_after_replug | 2026-05-28T01:02:18.778 | 91299 | 9055 | 413 | 336 |  | 413.0 | 336.0 | 0.0 | 0.0 | 0.0 | 0.0 |  |  |  | 0 |  |  |  |  |  | 0
raw | mcu_c_after_replug | 2026-05-28T01:02:18.788 | 91309 | 9056 | 418 | 338 |  | 418.0 | 338.0 | 0.0 | 0.0 | 0.0 | 0.0 |  |  |  | 0 |  |  |  |  |  | 0
raw | mcu_c_after_replug | 2026-05-28T01:02:18.798 | 91319 | 9057 | 407 | 341 |  | 407.0 | 341.0 | 0.0 | 0.0 | 0.0 | 0.0 |  |  |  | 0 |  |  |  |  |  | 0
raw | mcu_c_after_replug | 2026-05-28T01:02:18.808 | 91329 | 9058 | 417 | 331 |  | 417.0 | 331.0 | 0.0 | 0.0 | 0.0 | 0.0 |  |  |  | 0 |  |  |  |  |  | 0
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
