BruceKe365/STM32F411-PPG-Pulse-Monitor/testing dataset/17_MCU_C重插后烟测/raw.csv

session_id | label | pc_time | t_ms | red | ir | irq_count | sample_count
raw | mcu_c_after_replug | 2026-05-28T01:02:18.758 | 91279 | 417 | 333 | 8093 | 9053
raw | mcu_c_after_replug | 2026-05-28T01:02:18.768 | 91289 | 416 | 329 | 8094 | 9054
raw | mcu_c_after_replug | 2026-05-28T01:02:18.778 | 91299 | 413 | 336 | 8095 | 9055
raw | mcu_c_after_replug | 2026-05-28T01:02:18.788 | 91309 | 418 | 338 | 8096 | 9056
raw | mcu_c_after_replug | 2026-05-28T01:02:18.798 | 91319 | 407 | 341 | 8097 | 9057
raw | mcu_c_after_replug | 2026-05-28T01:02:18.808 | 91329 | 417 | 331 | 8098 | 9058
raw | mcu_c_after_replug | 2026-05-28T01:02:18.818 | 91339 | 424 | 328 | 8099 | 9059
raw | mcu_c_after_replug | 2026-05-28T01:02:18.828 | 91349 | 417 | 334 | 8100 | 9060
raw | mcu_c_after_replug | 2026-05-28T01:02:18.838 | 91359 | 407 | 334 | 8101 | 9061
raw | mcu_c_after_replug | 2026-05-28T01:02:18.848 | 91369 | 415 | 330 | 8102 | 9062
raw | mcu_c_after_replug | 2026-05-28T01:02:18.858 | 91379 | 419 | 334 | 8103 | 9063
raw | mcu_c_after_replug | 2026-05-28T01:02:18.868 | 91389 | 412 | 340 | 8104 | 9064
raw | mcu_c_after_replug | 2026-05-28T01:02:18.878 | 91399 | 408 | 332 | 8105 | 9065
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
