BruceKe365/STM32F411-PPG-Pulse-Monitor/testing dataset/18_MCU_C对齐后串口烟测失败/events.csv

session_id | pc_time | event_s | event_label
raw | 2026-05-28T01:06:00.238 | 0.0 | after_flash
