BruceKe365/STM32F411-PPG-Pulse-Monitor/testing dataset/19_串口重插第1次/events.csv

session_id | pc_time | event_s | event_label
raw | 2026-05-28T01:08:31.151 | 0.0 | run1
