BruceKe365/STM32F411-PPG-Pulse-Monitor/testing dataset/19_串口重插第1次/processed.csv

session_id | label | pc_time | t_ms | sample_count | red | ir | fs_hz | red_dc | ir_dc | red_ac | ir_ac | red_filt | ir_filt | red_rms | ir_rms | finger_score | finger_present | hr_bpm | hr_peak_bpm | hr_autocorr_bpm | spo2 | ratio | peak | peak_interval_ms
raw | serial_replug_run1 | 2026-05-28T01:08:31.259 | 67153 | 5435 | 55900 | 62506 |  | 55900.0 | 62506.0 | 0.0 | 0.0 | 0.0 | 0.0 |  |  |  | 0 |  |  |  |  |  | 0
raw | serial_replug_run1 | 2026-05-28T01:08:31.437 | 67163 | 5436 | 55910 | 62539 |  | 55900.2 | 62506.66 | 9.8 | 32.34 | 1.96 | 6.468 |  |  |  | 0 |  |  |  |  |  | 0
raw | serial_replug_run1 | 2026-05-28T01:08:31.617 | 67173 | 5437 | 55932 | 62580 |  | 55900.836 | 62508.127 | 31.164 | 71.873 | 7.801 | 19.549 |  |  |  | 0 |  |  |  |  |  | 0
raw | serial_replug_run1 | 2026-05-28T01:08:31.795 | 67183 | 5438 | 55942 | 62625 |  | 55901.659 | 62510.464 | 40.341 | 114.536 | 14.309 | 38.546 |  |  |  | 0 |  |  |  |  |  | 0
raw | serial_replug_run1 | 2026-05-28T01:08:31.974 | 67193 | 5439 | 55978 | 62694 |  | 55903.186 | 62514.135 | 74.814 | 179.865 | 26.41 | 66.81 |  |  |  | 0 |  |  |  |  |  | 0
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
