BruceKe365/STM32F411-PPG-Pulse-Monitor/testing dataset/19_串口重插第1次/raw.csv

session_id | label | pc_time | t_ms | red | ir | irq_count | sample_count
raw | serial_replug_run1 | 2026-05-28T01:08:31.259 | 67153 | 55900 | 62506 | 4798 | 5435
raw | serial_replug_run1 | 2026-05-28T01:08:31.437 | 67163 | 55910 | 62539 | 4798 | 5436
raw | serial_replug_run1 | 2026-05-28T01:08:31.617 | 67173 | 55932 | 62580 | 4798 | 5437
raw | serial_replug_run1 | 2026-05-28T01:08:31.795 | 67183 | 55942 | 62625 | 4798 | 5438
raw | serial_replug_run1 | 2026-05-28T01:08:31.974 | 67193 | 55978 | 62694 | 4798 | 5439
raw | serial_replug_run1 | 2026-05-28T01:08:32.153 | 67203 | 56009 | 62775 | 4798 | 5440
raw | serial_replug_run1 | 2026-05-28T01:08:32.332 | 67213 | 56048 | 62852 | 4798 | 5441
raw | serial_replug_run1 | 2026-05-28T01:08:32.631 | 68695 | 55885 | 62771 | 4799 | 5442
raw | serial_replug_run1 | 2026-05-28T01:08:32.809 | 68705 | 55895 | 62801 | 4799 | 5443
raw | serial_replug_run1 | 2026-05-28T01:08:32.988 | 68715 | 55913 | 62829 | 4799 | 5444
raw | serial_replug_run1 | 2026-05-28T01:08:33.167 | 68725 | 55913 | 62855 | 4799 | 5445
raw | serial_replug_run1 | 2026-05-28T01:08:33.346 | 68735 | 55917 | 62861 | 4799 | 5446
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
