BruceKe365/STM32F411-PPG-Pulse-Monitor/testing dataset/20_串口重插第2次/events.csv

session_id | pc_time | event_s | event_label
raw | 2026-05-28T01:08:47.494 | 0.0 | run2
