BruceKe365/STM32F411-PPG-Pulse-Monitor/testing dataset/20_串口重插第2次/processed.csv

session_id | label | pc_time | t_ms | sample_count | red | ir | fs_hz | red_dc | ir_dc | red_ac | ir_ac | red_filt | ir_filt | red_rms | ir_rms | finger_score | finger_present | hr_bpm | hr_peak_bpm | hr_autocorr_bpm | spo2 | ratio | peak | peak_interval_ms
raw | serial_replug_run2 | 2026-05-28T01:08:47.581 | 83527 | 5522 | 56416 | 64094 |  | 56416.0 | 64094.0 | 0.0 | 0.0 | 0.0 | 0.0 |  |  |  | 0 |  |  |  |  |  | 0
raw | serial_replug_run2 | 2026-05-28T01:08:47.761 | 83537 | 5523 | 56421 | 64099 |  | 56416.1 | 64094.1 | 4.9 | 4.9 | 0.98 | 0.98 |  |  |  | 0 |  |  |  |  |  | 0
raw | serial_replug_run2 | 2026-05-28T01:08:47.947 | 84012 | 5524 | 56594 | 64602 |  | 56419.658 | 64104.258 | 174.342 | 497.742 | 35.652 | 100.332 |  |  |  | 0 |  |  |  |  |  | 0
raw | serial_replug_run2 | 2026-05-28T01:08:48.126 | 84022 | 5525 | 56594 | 64623 |  | 56423.145 | 64114.633 | 170.855 | 508.367 | 62.693 | 181.939 |  |  |  | 0 |  |  |  |  |  | 0
raw | serial_replug_run2 | 2026-05-28T01:08:48.305 | 84032 | 5526 | 56606 | 64639 |  | 56426.802 | 64125.12 | 179.198 | 513.88 | 85.994 | 248.327 |  |  |  | 0 |  |  |  |  |  | 0
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
