BruceKe365/STM32F411-PPG-Pulse-Monitor/testing dataset/20_串口重插第2次/raw.csv

session_id | label | pc_time | t_ms | red | ir | irq_count | sample_count
raw | serial_replug_run2 | 2026-05-28T01:08:47.581 | 83527 | 56416 | 64094 | 4816 | 5522
raw | serial_replug_run2 | 2026-05-28T01:08:47.761 | 83537 | 56421 | 64099 | 4816 | 5523
raw | serial_replug_run2 | 2026-05-28T01:08:47.947 | 84012 | 56594 | 64602 | 4818 | 5524
raw | serial_replug_run2 | 2026-05-28T01:08:48.126 | 84022 | 56594 | 64623 | 4818 | 5525
raw | serial_replug_run2 | 2026-05-28T01:08:48.305 | 84032 | 56606 | 64639 | 4818 | 5526
raw | serial_replug_run2 | 2026-05-28T01:08:48.485 | 84042 | 56614 | 64650 | 4818 | 5527
raw | serial_replug_run2 | 2026-05-28T01:08:48.665 | 84052 | 56610 | 64653 | 4818 | 5528
raw | serial_replug_run2 | 2026-05-28T01:08:48.844 | 84062 | 56609 | 64647 | 4818 | 5529
raw | serial_replug_run2 | 2026-05-28T01:08:49.024 | 84072 | 56592 | 64596 | 4818 | 5530
raw | serial_replug_run2 | 2026-05-28T01:08:49.203 | 84082 | 56563 | 64516 | 4818 | 5531
raw | serial_replug_run2 | 2026-05-28T01:08:49.502 | 85567 | 56584 | 64486 | 4819 | 5532
raw | serial_replug_run2 | 2026-05-28T01:08:49.682 | 85577 | 56594 | 64523 | 4819 | 5533
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
