BruceKe365/STM32F411-PPG-Pulse-Monitor/testing dataset/21_定时修复后串口重插第1次/events.csv

session_id | pc_time | event_s | event_label
raw | 2026-05-28T01:10:15.338 | 0.0 | run1_after_timer_fix
