BruceKe365/STM32F411-PPG-Pulse-Monitor/testing dataset/21_定时修复后串口重插第1次/processed.csv

session_id | label | pc_time | t_ms | sample_count | red | ir | fs_hz | red_dc | ir_dc | red_ac | ir_ac | red_filt | ir_filt | red_rms | ir_rms | finger_score | finger_present | hr_bpm | hr_peak_bpm | hr_autocorr_bpm | spo2 | ratio | peak | peak_interval_ms
raw | serial_replug_run1_after_timer_fix | 2026-05-28T01:10:15.447 | 171584 | 12408 | 63632 | 75603 |  | 63632.0 | 75603.0 | 0.0 | 0.0 | 0.0 | 0.0 |  |  |  | 0 |  |  |  |  |  | 0
raw | serial_replug_run1_after_timer_fix | 2026-05-28T01:10:15.567 | 171814 | 12409 | 63622 | 75599 |  | 63631.8 | 75602.92 | -9.8 | -3.92 | -1.96 | -0.784 |  |  |  | 0 |  |  |  |  |  | 0
raw | serial_replug_run1_after_timer_fix | 2026-05-28T01:10:15.568 | 171824 | 12410 | 63631 | 75627 |  | 63631.784 | 75603.402 | -0.784 | 23.598 | -1.725 | 4.092 |  |  |  | 0 |  |  |  |  |  | 0
raw | serial_replug_run1_after_timer_fix | 2026-05-28T01:10:15.569 | 171834 | 12411 | 63646 | 75649 |  | 63632.068 | 75604.314 | 13.932 | 44.686 | 1.406 | 12.211 |  |  |  | 0 |  |  |  |  |  | 0
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
