BruceKe365/STM32F411-PPG-Pulse-Monitor/testing dataset/21_定时修复后串口重插第1次/raw.csv

session_id | label | pc_time | t_ms | red | ir | irq_count | sample_count
raw | serial_replug_run1_after_timer_fix | 2026-05-28T01:10:15.447 | 171584 | 63632 | 75603 | 10355 | 12408
raw | serial_replug_run1_after_timer_fix | 2026-05-28T01:10:15.567 | 171814 | 63622 | 75599 | 10356 | 12409
raw | serial_replug_run1_after_timer_fix | 2026-05-28T01:10:15.568 | 171824 | 63631 | 75627 | 10356 | 12410
raw | serial_replug_run1_after_timer_fix | 2026-05-28T01:10:15.569 | 171834 | 63646 | 75649 | 10356 | 12411
raw | serial_replug_run1_after_timer_fix | 2026-05-28T01:10:15.570 | 171844 | 63663 | 75665 | 10356 | 12412
raw | serial_replug_run1_after_timer_fix | 2026-05-28T01:10:15.571 | 171854 | 63676 | 75697 | 10356 | 12413
raw | serial_replug_run1_after_timer_fix | 2026-05-28T01:10:15.571 | 171864 | 63700 | 75721 | 10356 | 12414
raw | serial_replug_run1_after_timer_fix | 2026-05-28T01:10:15.572 | 171874 | 63711 | 75750 | 10356 | 12415
raw | serial_replug_run1_after_timer_fix | 2026-05-28T01:10:15.573 | 171884 | 63726 | 75778 | 10356 | 12416
raw | serial_replug_run1_after_timer_fix | 2026-05-28T01:10:15.580 | 171827 | 63732 | 75805 | 10357 | 12417
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
