BruceKe365/STM32F411-PPG-Pulse-Monitor/testing dataset/22_定时修复后串口重插第2次/events.csv

session_id | pc_time | event_s | event_label
raw | 2026-05-28T01:10:38.919 | 0.0 | run2_after_timer_fix
