BruceKe365/STM32F411-PPG-Pulse-Monitor/testing dataset/22_定时修复后串口重插第2次/processed.csv

session_id | label | pc_time | t_ms | sample_count | red | ir | fs_hz | red_dc | ir_dc | red_ac | ir_ac | red_filt | ir_filt | red_rms | ir_rms | finger_score | finger_present | hr_bpm | hr_peak_bpm | hr_autocorr_bpm | spo2 | ratio | peak | peak_interval_ms
raw | serial_replug_run2_after_timer_fix | 2026-05-28T01:10:38.929 | 195248 | 14454 | 63906 | 76051 |  | 63906.0 | 76051.0 | 0.0 | 0.0 | 0.0 | 0.0 |  |  |  | 0 |  |  |  |  |  | 0
raw | serial_replug_run2_after_timer_fix | 2026-05-28T01:10:38.940 | 195258 | 14455 | 63906 | 76055 |  | 63906.0 | 76051.08 | 0.0 | 3.92 | 0.0 | 0.784 |  |  |  | 0 |  |  |  |  |  | 0
raw | serial_replug_run2_after_timer_fix | 2026-05-28T01:10:38.949 | 195268 | 14456 | 63913 | 76069 |  | 63906.14 | 76051.438 | 6.86 | 17.562 | 1.372 | 4.14 |  |  |  | 0 |  |  |  |  |  | 0
raw | serial_replug_run2_after_timer_fix | 2026-05-28T01:10:38.959 | 195278 | 14457 | 63906 | 76064 |  | 63906.137 | 76051.69 | -0.137 | 12.31 | 1.07 | 5.774 |  |  |  | 0 |  |  |  |  |  | 0
raw | serial_replug_run2_after_timer_fix | 2026-05-28T01:10:38.969 | 195288 | 14458 | 63917 | 76076 |  | 63906.354 | 76052.176 | 10.646 | 23.824 | 2.985 | 9.384 |  |  |  | 0 |  |  |  |  |  | 0
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
