BruceKe365/STM32F411-PPG-Pulse-Monitor/testing dataset/22_定时修复后串口重插第2次/raw.csv

session_id | label | pc_time | t_ms | red | ir | irq_count | sample_count
raw | serial_replug_run2_after_timer_fix | 2026-05-28T01:10:38.929 | 195248 | 63906 | 76051 | 11904 | 14454
raw | serial_replug_run2_after_timer_fix | 2026-05-28T01:10:38.940 | 195258 | 63906 | 76055 | 11905 | 14455
raw | serial_replug_run2_after_timer_fix | 2026-05-28T01:10:38.949 | 195268 | 63913 | 76069 | 11906 | 14456
raw | serial_replug_run2_after_timer_fix | 2026-05-28T01:10:38.959 | 195278 | 63906 | 76064 | 11907 | 14457
raw | serial_replug_run2_after_timer_fix | 2026-05-28T01:10:38.969 | 195288 | 63917 | 76076 | 11908 | 14458
raw | serial_replug_run2_after_timer_fix | 2026-05-28T01:10:38.979 | 195298 | 63912 | 76076 | 11909 | 14459
raw | serial_replug_run2_after_timer_fix | 2026-05-28T01:10:38.990 | 195308 | 63916 | 76074 | 11910 | 14460
raw | serial_replug_run2_after_timer_fix | 2026-05-28T01:10:39.000 | 195318 | 63902 | 76079 | 11911 | 14461
raw | serial_replug_run2_after_timer_fix | 2026-05-28T01:10:39.010 | 195328 | 63911 | 76083 | 11912 | 14462
raw | serial_replug_run2_after_timer_fix | 2026-05-28T01:10:39.020 | 195338 | 63911 | 76098 | 11913 | 14463
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
