BruceKe365/STM32F411-PPG-Pulse-Monitor/testing dataset/93_预热峰值回放验证/processed.csv

session_id | label | pc_time | t_ms | sample_count | red | ir | fs_hz | red_dc | ir_dc | red_ac | ir_ac | red_filt | ir_filt | red_rms | ir_rms | finger_score | finger_present | hr_bpm | hr_peak_bpm | hr_autocorr_bpm | spo2 | ratio | peak | peak_interval_ms
raw | verify_warmup_peak_replay | 2026-05-28T01:24:00.882 | 899185 | 89879 | 347 | 299 |  | 347.0 | 299.0 | 0.0 | 0.0 | 0.0 | 0.0 |  |  |  | 0 |  |  |  |  |  | 0
raw | verify_warmup_peak_replay | 2026-05-28T01:24:00.882 | 899195 | 89880 | 344 | 293 |  | 344.0 | 293.0 | 0.0 | 0.0 | 0.0 | 0.0 |  |  |  | 0 |  |  |  |  |  | 0
raw | verify_warmup_peak_replay | 2026-05-28T01:24:00.882 | 899205 | 89881 | 348 | 293 |  | 348.0 | 293.0 | 0.0 | 0.0 | 0.0 | 0.0 |  |  |  | 0 |  |  |  |  |  | 0
raw | verify_warmup_peak_replay | 2026-05-28T01:24:00.882 | 899215 | 89882 | 340 | 304 |  | 340.0 | 304.0 | 0.0 | 0.0 | 0.0 | 0.0 |  |  |  | 0 |  |  |  |  |  | 0
raw | verify_warmup_peak_replay | 2026-05-28T01:24:00.882 | 899225 | 89883 | 348 | 297 |  | 348.0 | 297.0 | 0.0 | 0.0 | 0.0 | 0.0 |  |  |  | 0 |  |  |  |  |  | 0
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
