BruceKe365/STM32F411-PPG-Pulse-Monitor/testing dataset/93_预热峰值回放验证/raw.csv

session_id | label | pc_time | t_ms | red | ir | irq_count | sample_count
raw | verify_warmup_peak_replay | 2026-05-28T01:24:00.882 | 899185 | 347 | 299 | 80546 | 89879
raw | verify_warmup_peak_replay | 2026-05-28T01:24:00.882 | 899195 | 344 | 293 | 80547 | 89880
raw | verify_warmup_peak_replay | 2026-05-28T01:24:00.882 | 899205 | 348 | 293 | 80548 | 89881
raw | verify_warmup_peak_replay | 2026-05-28T01:24:00.882 | 899215 | 340 | 304 | 80549 | 89882
raw | verify_warmup_peak_replay | 2026-05-28T01:24:00.882 | 899225 | 348 | 297 | 80550 | 89883
raw | verify_warmup_peak_replay | 2026-05-28T01:24:00.882 | 899235 | 344 | 301 | 80551 | 89884
raw | verify_warmup_peak_replay | 2026-05-28T01:24:00.882 | 899245 | 343 | 293 | 80552 | 89885
raw | verify_warmup_peak_replay | 2026-05-28T01:24:00.882 | 899255 | 342 | 294 | 80553 | 89886
raw | verify_warmup_peak_replay | 2026-05-28T01:24:00.882 | 899265 | 350 | 293 | 80554 | 89887
raw | verify_warmup_peak_replay | 2026-05-28T01:24:00.882 | 899275 | 343 | 292 | 80555 | 89888
raw | verify_warmup_peak_replay | 2026-05-28T01:24:00.882 | 899285 | 347 | 289 | 80556 | 89889
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
