BruceKe365/STM32F411-PPG-Pulse-Monitor/testing dataset/94_最新烧录后串口验证/events.csv

session_id | pc_time | event_s | event_label
raw | 2026-05-28T01:26:37.548 | 0.0 | after_latest_flash
