BruceKe365/STM32F411-PPG-Pulse-Monitor/testing dataset/94_最新烧录后串口验证/processed.csv

session_id | label | pc_time | t_ms | sample_count | red | ir | fs_hz | red_dc | ir_dc | red_ac | ir_ac | red_filt | ir_filt | red_rms | ir_rms | finger_score | finger_present | hr_bpm | hr_peak_bpm | hr_autocorr_bpm | spo2 | ratio | peak | peak_interval_ms
raw | serial_after_latest_flash | 2026-05-28T01:26:37.556 | 50590 | 4659 | 60146 | 72028 |  | 60146.0 | 72028.0 | 0.0 | 0.0 | 0.0 | 0.0 |  |  |  | 0 |  |  |  |  |  | 0
raw | serial_after_latest_flash | 2026-05-28T01:26:37.565 | 50600 | 4660 | 60152 | 72051 |  | 60146.12 | 72028.46 | 5.88 | 22.54 | 1.176 | 4.508 |  |  |  | 0 |  |  |  |  |  | 0
raw | serial_after_latest_flash | 2026-05-28T01:26:37.575 | 50610 | 4661 | 60157 | 72071 |  | 60146.338 | 72029.311 | 10.662 | 41.689 | 3.073 | 11.944 |  |  |  | 0 |  |  |  |  |  | 0
raw | serial_after_latest_flash | 2026-05-28T01:26:37.586 | 50620 | 4662 | 60167 | 72087 |  | 60146.751 | 72030.465 | 20.249 | 56.535 | 6.508 | 20.862 |  |  |  | 0 |  |  |  |  |  | 0
raw | serial_after_latest_flash | 2026-05-28T01:26:37.596 | 50630 | 4663 | 60163 | 72105 |  | 60147.076 | 72031.955 | 15.924 | 73.045 | 8.392 | 31.299 |  |  |  | 0 |  |  |  |  |  | 0
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
