BruceKe365/STM32F411-PPG-Pulse-Monitor/testing dataset/94_最新烧录后串口验证/raw.csv

session_id | label | pc_time | t_ms | red | ir | irq_count | sample_count
raw | serial_after_latest_flash | 2026-05-28T01:26:37.556 | 50590 | 60146 | 72028 | 3895 | 4659
raw | serial_after_latest_flash | 2026-05-28T01:26:37.565 | 50600 | 60152 | 72051 | 3896 | 4660
raw | serial_after_latest_flash | 2026-05-28T01:26:37.575 | 50610 | 60157 | 72071 | 3897 | 4661
raw | serial_after_latest_flash | 2026-05-28T01:26:37.586 | 50620 | 60167 | 72087 | 3898 | 4662
raw | serial_after_latest_flash | 2026-05-28T01:26:37.596 | 50630 | 60163 | 72105 | 3899 | 4663
raw | serial_after_latest_flash | 2026-05-28T01:26:37.606 | 50640 | 60163 | 72131 | 3900 | 4664
raw | serial_after_latest_flash | 2026-05-28T01:26:37.616 | 50650 | 60179 | 72151 | 3901 | 4665
raw | serial_after_latest_flash | 2026-05-28T01:26:37.625 | 50660 | 60190 | 72170 | 3902 | 4666
raw | serial_after_latest_flash | 2026-05-28T01:26:37.635 | 50670 | 60189 | 72178 | 3903 | 4667
raw | serial_after_latest_flash | 2026-05-28T01:26:37.646 | 50680 | 60193 | 72185 | 3904 | 4668
raw | serial_after_latest_flash | 2026-05-28T01:26:37.656 | 50690 | 60193 | 72184 | 3905 | 4669
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
