BruceKe365/STM32F411-PPG-Pulse-Monitor/training_dataset/reports/full_stress_live_validation_20260629_current/stress_hrv_detail.csv

group | file | window_idx | start_s | end_s | stress_probability | raw_stress_index | display_stress_index | level | reason | finger_present_frac | spo2_valid_frac | hr_valid_frac | finger_score_min | finger_score_median | ir_rms_median | ppi_candidate_count | ppi_rejected_count | ppi_artifact_frac | valid_interval_count | mean_hr_bpm | mean_ppi_ms | sdnn_ms | rmssd_ms | sdsd_ms | pnn20_pct | pnn50_pct | cv_ppi | median_abs_delta_ms | p80_abs_delta_ms | p95_abs_delta_ms | outlier_frac
all_local_processed | testing dataset\08_轻触首次良好数据\raw_processed_replay_robust.csv | 0 | 3000.0 | 3040.0 | 0.340917 | 62 |  | -- | spo2_unstable | 0.993831 | 0.350649 | 0.61039 | 6.108 | 6.31 | 394.528 | 41.0 | 0.0 | 0.0 | 41.0 | 83.389831 | 719.512195 | 105.734366 | 160.600436 | 162.641457 | 77.5 | 55.0 | 0.146953 | 70.0 | 230.0 | 330.5 | 0.0
all_local_processed | testing dataset\09_强按血氧空白复核\raw_processed_replay_robust.csv | 0 | 5220.0 | 5260.0 | 0.865343 | 87 |  | -- | spo2_unstable | 1.0 | 0.0 | 0.8425 | 1.648 | 1.883 | 18.828 | 44.0 | 12.0 | 0.272727 | 32.0 | 81.183932 | 739.0625 | 168.127436 | 282.431836 | 286.93186 | 90.322581 | 74.193548 | 0.227487 | 190.0 | 340.0 | 550.0 | 0.03125
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
