BruceKe365/STM32F411-PPG-Pulse-Monitor/training_dataset/reports/full_stress_live_validation_20260629_current/stress_hrv_file_summary.csv

group | file | rows | duration_s | finger_rows | valid_peak_rows | peak_span_s | windows | displayed_windows | raw_median | display_median | display_max | reason_counts | no_window_reason
all_local_processed | testing dataset\00_串口烟测与原始数据检查\ppg_raw_repeat1_processed.csv | 601 | 5.997 | 0 | 0 | 0 | 0 | 0 |  |  |  | {} | not_enough_valid_peaks
all_local_processed | testing dataset\00_串口烟测与原始数据检查\ppg_raw_repeat2_processed.csv | 601 | 5.997 | 0 | 0 | 0 | 0 | 0 |  |  |  | {} | not_enough_valid_peaks
all_local_processed | testing dataset\01_无手指基线\processed.csv | 2002 | 20.0 | 0 | 0 | 0 | 0 | 0 |  |  |  | {} | not_enough_valid_peaks
all_local_processed | testing dataset\01_无手指基线\replay_v2_processed.csv | 2002 | 20.0 | 0 | 0 | 0 | 0 | 0 |  |  |  | {} | not_enough_valid_peaks
all_local_processed | testing dataset\01_无手指基线\replay_v3_processed.csv | 2002 | 20.0 | 0 | 0 | 0 | 0 | 0 |  |  |  | {} | not_enough_valid_peaks
all_local_processed | testing dataset\02_手指稳定初测\processed.csv | 4501 | 44.999 | 4482 | 32 | 43.679 | 0 | 0 |  |  |  | {} | window_alignment_or_feature_fail
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
