BruceKe365/STM32F411-PPG-Pulse-Monitor/testing dataset/107_波形同步检查/frames/waveform_columns.csv

sample_count | sample_time_ms | mode | x_insert | y | ir_filt | ir_rms | hr_bpm | hr_confirmed | finger_present | peak
254257 | 2542570 | stream | 0 | 12 | 363.297 | 546.05 | 77.922 | 1 | 1 | 0
254260 | 2542600 | stream | 0 | 15 | 62.28 | 546.118 | 77.922 | 1 | 1 | 0
254263 | 2542630 | stream | 0 | 21 | -462.005 | 546.379 | 77.922 | 1 | 1 | 0
254266 | 2542660 | stream | 0 | 25 | -908.922 | 547.863 | 77.922 | 1 | 1 | 0
254269 | 2542690 | stream | 0 | 27 | -1117.884 | 550.502 | 77.922 | 1 | 1 | 0
254272 | 2542720 | stream | 0 | 27 | -1130.69 | 553.361 | 77.922 | 1 | 1 | 0
254275 | 2542750 | stream | 0 | 26 | -1044.25 | 555.81 | 77.922 | 1 | 1 | 0
254278 | 2542780 | stream | 0 | 25 | -901.4 | 557.584 | 77.922 | 1 | 1 | 0
254281 | 2542810 | stream | 0 | 23 | -745.445 | 558.7 | 77.922 | 1 | 1 | 0
254284 | 2542840 | stream | 0 | 22 | -636.732 | 559.39 | 77.922 | 1 | 1 | 0
254287 | 2542870 | stream | 0 | 22 | -607.376 | 559.939 | 77.922 | 1 | 1 | 0
254290 | 2542900 | stream | 0 | 22 | -618.529 | 560.502 | 77.922 | 1 | 1 | 0
254293 | 2542930 | stream | 0 | 22 | -620.064 | 561.083 | 77.922 | 1 | 1 | 0
254296 | 2542960 | stream | 0 | 21 | -560.21 | 561.549 | 77.922 | 1 | 1 | 0
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
