BruceKe365/STM32F411-PPG-Pulse-Monitor/testing dataset/109_波形显示条件处理/frames/waveform_columns.csv

sample_count | sample_time_ms | mode | x_insert | y | ir_filt | ir_rms | hr_bpm | hr_confirmed | finger_present | peak | display_filt | display_envelope
368207 | 3682070 | stream | 0 | 28 | -655.704 | 403.041 | 95.238 | 1 | 1 | 0 | -229.496 | 69.549
368210 | 3682100 | stream | 0 | 28 | -435.081 | 403.994 | 95.238 | 1 | 1 | 0 | -301.451 | 139.12
368213 | 3682130 | stream | 0 | 27 | -259.506 | 404.182 | 95.238 | 1 | 1 | 0 | -286.77 | 183.415
368216 | 3682160 | stream | 0 | 26 | -19.819 | 403.856 | 95.238 | 1 | 1 | 0 | -193.337 | 186.392
368219 | 3682190 | stream | 0 | 24 | 62.536 | 403.207 | 95.238 | 1 | 1 | 0 | -103.782 | 185.978
368222 | 3682220 | stream | 0 | 25 | -285.868 | 402.515 | 95.238 | 1 | 1 | 0 | -167.512 | 185.886
368225 | 3682250 | stream | 0 | 26 | -732.793 | 403.551 | 95.238 | 1 | 1 | 0 | -365.36 | 239.728
368228 | 3682280 | stream | 0 | 27 | -941.826 | 406.128 | 95.238 | 1 | 1 | 0 | -567.123 | 337.947
368231 | 3682310 | stream | 0 | 27 | -931.663 | 407.147 | 95.238 | 1 | 1 | 0 | -694.712 | 444.976
368234 | 3682340 | stream | 0 | 27 | -810.346 | 406.323 | 95.238 | 1 | 1 | 0 | -735.184 | 532.039
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
