BruceKe365/STM32F411-PPG-Pulse-Monitor/testing dataset/110_固定脉冲风格波形/frames/waveform_columns.csv

sample_count | sample_time_ms | mode | x_insert | y | ir_filt | ir_rms | hr_bpm | hr_confirmed | finger_present | peak | display_filt | display_envelope
368207 | 3682070 | stream | 0 | 16 | -655.704 | 403.041 | 95.238 | 1 | 1 | 0 | 0.0 | 1.0
368210 | 3682100 | stream | 0 | 16 | -435.081 | 403.994 | 95.238 | 1 | 1 | 0 | 0.0 | 1.0
368213 | 3682130 | stream | 0 | 16 | -259.506 | 404.182 | 95.238 | 1 | 1 | 0 | 0.0 | 1.0
368216 | 3682160 | stream | 0 | 16 | -19.819 | 403.856 | 95.238 | 1 | 1 | 0 | 0.0 | 1.0
368219 | 3682190 | stream | 0 | 16 | 62.536 | 403.207 | 95.238 | 1 | 1 | 0 | 0.0 | 1.0
368222 | 3682220 | stream | 0 | 16 | -285.868 | 402.515 | 95.238 | 1 | 1 | 0 | 0.0 | 1.0
368225 | 3682250 | stream | 0 | 16 | -732.793 | 403.551 | 95.238 | 1 | 1 | 0 | 0.0 | 1.0
368228 | 3682280 | stream | 0 | 16 | -941.826 | 406.128 | 95.238 | 1 | 1 | 0 | 0.0 | 1.0
368231 | 3682310 | stream | 0 | 16 | -931.663 | 407.147 | 95.238 | 1 | 1 | 0 | 0.0 | 1.0
368234 | 3682340 | stream | 0 | 16 | -810.346 | 406.323 | 95.238 | 1 | 1 | 0 | 0.0 | 1.0
368237 | 3682370 | stream | 0 | 16 | -654.831 | 405.058 | 93.75 | 1 | 1 | 0 | 0.0 | 1.0
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
