BruceKe365/STM32F411-PPG-Pulse-Monitor/training_dataset/reports/full_stress_train_validation_20260629_current/derived/stress_hrv_windows.csv

source | subject | state_name | start_s | end_s | label | valid_interval_count | mean_hr_bpm | mean_ppi_ms | sdnn_ms | rmssd_ms | sdsd_ms | pnn20_pct | pnn50_pct | cv_ppi | median_abs_delta_ms | p80_abs_delta_ms | p95_abs_delta_ms | outlier_frac
wesad_bvp | S10 | baseline | 90.0 | 130.0 | 0 | 61.0 | 92.62159 | 647.797131 | 170.151725 | 217.696496 | 219.450522 | 81.666667 | 68.333333 | 0.262662 | 93.75 | 281.25 | 457.03125 | 0.213115
wesad_bvp | S10 | baseline | 100.0 | 140.0 | 0 | 62.0 | 91.781033 | 653.729839 | 199.701076 | 247.635462 | 249.647281 | 77.04918 | 62.295082 | 0.30548 | 78.125 | 296.875 | 515.625 | 0.225806
wesad_bvp | S10 | baseline | 110.0 | 150.0 | 0 | 61.0 | 90.896391 | 660.092213 | 168.519705 | 199.047618 | 200.718957 | 65.0 | 45.0 | 0.255297 | 46.875 | 265.625 | 407.03125 | 0.163934
wesad_bvp | S10 | baseline | 120.0 | 160.0 | 0 | 59.0 | 89.091624 | 673.463983 | 211.185696 | 247.597562 | 249.700885 | 67.241379 | 50.0 | 0.313581 | 62.5 | 312.5 | 515.625 | 0.237288
wesad_bvp | S10 | baseline | 130.0 | 170.0 | 0 | 59.0 | 87.542504 | 685.381356 | 193.563454 | 222.763746 | 224.507938 | 62.068966 | 36.206897 | 0.282417 | 39.0625 | 312.5 | 515.625 | 0.186441
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
