BruceKe365/STM32F411-PPG-Pulse-Monitor/testing dataset/00_串口烟测与原始数据检查/ppg_raw_repeat1.csv

pc_time | t_ms | red | ir | irq_count | sample_count
2026-05-27T21:10:30.930 | 25570 | 370 | 336 | 2213 | 2479
2026-05-27T21:10:30.940 | 25580 | 373 | 342 | 2214 | 2480
2026-05-27T21:10:30.950 | 25590 | 374 | 336 | 2215 | 2481
2026-05-27T21:10:30.960 | 25600 | 361 | 343 | 2216 | 2482
2026-05-27T21:10:30.970 | 25610 | 365 | 339 | 2217 | 2483
2026-05-27T21:10:30.980 | 25620 | 369 | 330 | 2218 | 2484
2026-05-27T21:10:30.990 | 25630 | 364 | 339 | 2219 | 2485
2026-05-27T21:10:31.000 | 25640 | 357 | 341 | 2220 | 2486
2026-05-27T21:10:31.010 | 25650 | 371 | 344 | 2221 | 2487
2026-05-27T21:10:31.020 | 25660 | 368 | 341 | 2222 | 2488
2026-05-27T21:10:31.030 | 25670 | 372 | 337 | 2223 | 2489
2026-05-27T21:10:31.040 | 25680 | 372 | 333 | 2224 | 2490
2026-05-27T21:10:31.050 | 25690 | 375 | 335 | 2225 | 2491
2026-05-27T21:10:31.060 | 25700 | 365 | 335 | 2226 | 2492
2026-05-27T21:10:31.070 | 25710 | 375 | 349 | 2227 | 2493
2026-05-27T21:10:31.080 | 25720 | 366 | 340 | 2228 | 2494
2026-05-27T21:10:31.090 | 25730 | 369 | 340 | 2229 | 2495
2026-05-27T21:10:31.100 | 25740 | 372 | 337 | 2230 | 2496
2026-05-27T21:10:31.110 | 25750 | 366 | 338 | 2231 | 2497
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
