BruceKe365/STM32F411-PPG-Pulse-Monitor/testing dataset/00_串口烟测与原始数据检查/ppg_raw_repeat1_processed.csv

pc_time | t_ms | sample_count | red | ir | fs_hz | red_dc | ir_dc | red_ac | ir_ac | red_rms | ir_rms | finger_present | hr_bpm | spo2 | ratio | peak
2026-05-27T21:10:30.930 | 25570 | 2479 | 370 | 336 |  |  |  |  |  |  |  | 0 |  |  |  | 0
2026-05-27T21:10:30.940 | 25580 | 2480 | 373 | 342 |  |  |  |  |  |  |  | 0 |  |  |  | 0
2026-05-27T21:10:30.950 | 25590 | 2481 | 374 | 336 |  |  |  |  |  |  |  | 0 |  |  |  | 0
2026-05-27T21:10:30.960 | 25600 | 2482 | 361 | 343 |  |  |  |  |  |  |  | 0 |  |  |  | 0
2026-05-27T21:10:30.970 | 25610 | 2483 | 365 | 339 |  |  |  |  |  |  |  | 0 |  |  |  | 0
2026-05-27T21:10:30.980 | 25620 | 2484 | 369 | 330 |  |  |  |  |  |  |  | 0 |  |  |  | 0
2026-05-27T21:10:30.990 | 25630 | 2485 | 364 | 339 |  |  |  |  |  |  |  | 0 |  |  |  | 0
2026-05-27T21:10:31.000 | 25640 | 2486 | 357 | 341 |  |  |  |  |  |  |  | 0 |  |  |  | 0
2026-05-27T21:10:31.010 | 25650 | 2487 | 371 | 344 |  |  |  |  |  |  |  | 0 |  |  |  | 0
2026-05-27T21:10:31.020 | 25660 | 2488 | 368 | 341 |  |  |  |  |  |  |  | 0 |  |  |  | 0
2026-05-27T21:10:31.030 | 25670 | 2489 | 372 | 337 |  |  |  |  |  |  |  | 0 |  |  |  | 0
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
