BruceKe365/STM32F411-PPG-Pulse-Monitor/testing dataset/00_串口烟测与原始数据检查/ppg_raw_repeat2.csv

pc_time | t_ms | red | ir | irq_count | sample_count
2026-05-27T21:10:43.842 | 38483 | 362 | 331 | 3369 | 3771
2026-05-27T21:10:43.852 | 38493 | 366 | 340 | 3370 | 3772
2026-05-27T21:10:43.862 | 38503 | 365 | 332 | 3371 | 3773
2026-05-27T21:10:43.872 | 38513 | 376 | 335 | 3372 | 3774
2026-05-27T21:10:43.882 | 38523 | 367 | 339 | 3373 | 3775
2026-05-27T21:10:43.892 | 38533 | 364 | 332 | 3374 | 3776
2026-05-27T21:10:43.902 | 38543 | 360 | 333 | 3375 | 3777
2026-05-27T21:10:43.912 | 38553 | 369 | 338 | 3376 | 3778
2026-05-27T21:10:43.922 | 38563 | 366 | 327 | 3377 | 3779
2026-05-27T21:10:43.932 | 38573 | 366 | 338 | 3378 | 3780
2026-05-27T21:10:43.942 | 38583 | 367 | 340 | 3379 | 3781
2026-05-27T21:10:43.952 | 38593 | 374 | 334 | 3380 | 3782
2026-05-27T21:10:43.962 | 38603 | 365 | 336 | 3381 | 3783
2026-05-27T21:10:43.972 | 38613 | 368 | 341 | 3382 | 3784
2026-05-27T21:10:43.982 | 38623 | 366 | 333 | 3383 | 3785
2026-05-27T21:10:43.992 | 38633 | 371 | 336 | 3384 | 3786
2026-05-27T21:10:44.002 | 38643 | 368 | 334 | 3385 | 3787
2026-05-27T21:10:44.012 | 38653 | 370 | 337 | 3386 | 3788
2026-05-27T21:10:44.023 | 38663 | 367 | 334 | 3387 | 3789
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
