BruceKe365/STM32F411-PPG-Pulse-Monitor/testing dataset/00_串口烟测与原始数据检查/ppg_raw_repeat2_processed.csv

pc_time | t_ms | sample_count | red | ir | fs_hz | red_dc | ir_dc | red_ac | ir_ac | red_rms | ir_rms | finger_present | hr_bpm | spo2 | ratio | peak
2026-05-27T21:10:43.842 | 38483 | 3771 | 362 | 331 |  |  |  |  |  |  |  | 0 |  |  |  | 0
2026-05-27T21:10:43.852 | 38493 | 3772 | 366 | 340 |  |  |  |  |  |  |  | 0 |  |  |  | 0
2026-05-27T21:10:43.862 | 38503 | 3773 | 365 | 332 |  |  |  |  |  |  |  | 0 |  |  |  | 0
2026-05-27T21:10:43.872 | 38513 | 3774 | 376 | 335 |  |  |  |  |  |  |  | 0 |  |  |  | 0
2026-05-27T21:10:43.882 | 38523 | 3775 | 367 | 339 |  |  |  |  |  |  |  | 0 |  |  |  | 0
2026-05-27T21:10:43.892 | 38533 | 3776 | 364 | 332 |  |  |  |  |  |  |  | 0 |  |  |  | 0
2026-05-27T21:10:43.902 | 38543 | 3777 | 360 | 333 |  |  |  |  |  |  |  | 0 |  |  |  | 0
2026-05-27T21:10:43.912 | 38553 | 3778 | 369 | 338 |  |  |  |  |  |  |  | 0 |  |  |  | 0
2026-05-27T21:10:43.922 | 38563 | 3779 | 366 | 327 |  |  |  |  |  |  |  | 0 |  |  |  | 0
2026-05-27T21:10:43.932 | 38573 | 3780 | 366 | 338 |  |  |  |  |  |  |  | 0 |  |  |  | 0
2026-05-27T21:10:43.942 | 38583 | 3781 | 367 | 340 |  |  |  |  |  |  |  | 0 |  |  |  | 0
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
