BruceKe365/STM32F411-PPG-Pulse-Monitor/testing dataset/00_串口烟测与原始数据检查/ppg_raw_verify.csv

pc_time | t_ms | red | ir | irq_count | sample_count
2026-05-27T20:52:35.516 | 170926 | 444 | 350 | 324 | 1576
2026-05-27T20:52:35.516 | 170928 | 499 | 386 | 324 | 1577
2026-05-27T20:52:35.522 | 170934 | 551 | 445 | 325 | 1578
2026-05-27T20:52:35.522 | 170934 | 588 | 484 | 325 | 1579
2026-05-27T20:52:35.523 | 170934 | 601 | 526 | 325 | 1580
2026-05-27T20:52:35.523 | 170934 | 573 | 540 | 325 | 1581
2026-05-27T20:52:35.523 | 170934 | 517 | 530 | 325 | 1582
2026-05-27T20:52:35.523 | 170934 | 476 | 529 | 325 | 1583
2026-05-27T20:52:35.523 | 170934 | 456 | 515 | 325 | 1584
2026-05-27T20:52:35.523 | 170934 | 441 | 508 | 325 | 1585
2026-05-27T20:52:35.642 | 171054 | 433 | 499 | 327 | 1586
2026-05-27T20:52:35.643 | 171054 | 423 | 477 | 327 | 1587
2026-05-27T20:52:35.644 | 171054 | 413 | 464 | 327 | 1588
2026-05-27T20:52:35.644 | 171056 | 396 | 449 | 327 | 1589
2026-05-27T20:52:35.648 | 171056 | 383 | 433 | 327 | 1590
2026-05-27T20:52:35.648 | 171058 | 381 | 432 | 327 | 1591
2026-05-27T20:52:35.649 | 171058 | 363 | 428 | 327 | 1592
2026-05-27T20:52:35.649 | 171060 | 349 | 420 | 327 | 1593
2026-05-27T20:52:35.654 | 171066 | 351 | 427 | 328 | 1594
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
