BruceKe365/STM32F411-PPG-Pulse-Monitor/testing dataset/00_串口烟测与原始数据检查/根目录诊断CSV归档/diag_30s.csv

diag_ms | loop_gap_max_ms | loop_count | max30102_calls | max30102_samples | max30102_fifo_max | max30102_max_ms | oled091_flushes | oled091_max_ms | oled64_flushes | oled64_max_ms | cdc_calls | cdc_busy | cdc_timeout | cdc_max_wait_ms | cdc_total_wait_ms | irq_count | sample_count | finger | valid | hr | auto | spo2
44113 | 124 | 67602 | 61 | 100 | 8 | 11 | 19 | 14 | 3 | 103 | 0 | 0 | 0 | 0 | 0 | 3678 | 4340 | 0 | 0 | -1 | -1 | -1
45100 | 123 | 81169 | 70 | 100 | 8 | 7 | 20 | 13 | 2 | 103 | 2 | 1 | 0 | 2 | 2 | 3747 | 4440 | 1 | 0 | -1 | -1 | -1
46100 | 124 | 64982 | 65 | 100 | 8 | 12 | 18 | 14 | 3 | 103 | 1 | 0 | 0 | 0 | 0 | 3812 | 4540 | 1 | 0 | -1 | -1 | -1
47100 | 107 | 86722 | 87 | 100 | 8 | 12 | 23 | 13 | 1 | 102 | 1 | 0 | 0 | 0 | 0 | 3899 | 4640 | 0 | 0 | -1 | -1 | -1
48105 | 117 | 84574 | 88 | 100 | 8 | 11 | 23 | 14 | 1 | 103 | 1 | 0 | 0 | 0 | 0 | 3987 | 4740 | 0 | 0 | -1 | -1 | -1
49102 | 103 | 86055 | 90 | 100 | 8 | 11 | 22 | 14 | 1 | 102 | 1 | 0 | 0 | 0 | 0 | 4077 | 4840 | 0 | 0 | -1 | -1 | -1
50114 | 107 | 84242 | 92 | 101 | 8 | 11 | 23 | 13 | 1 | 103 | 1 | 0 | 0 | 0 | 0 | 4169 | 4941 | 0 | 0 | -1 | -1 | -1
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
