BruceKe365/STM32F411-PPG-Pulse-Monitor/testing dataset/108_40秒实测波形绘图/waveform_oled_columns_timeline_0_60s.png

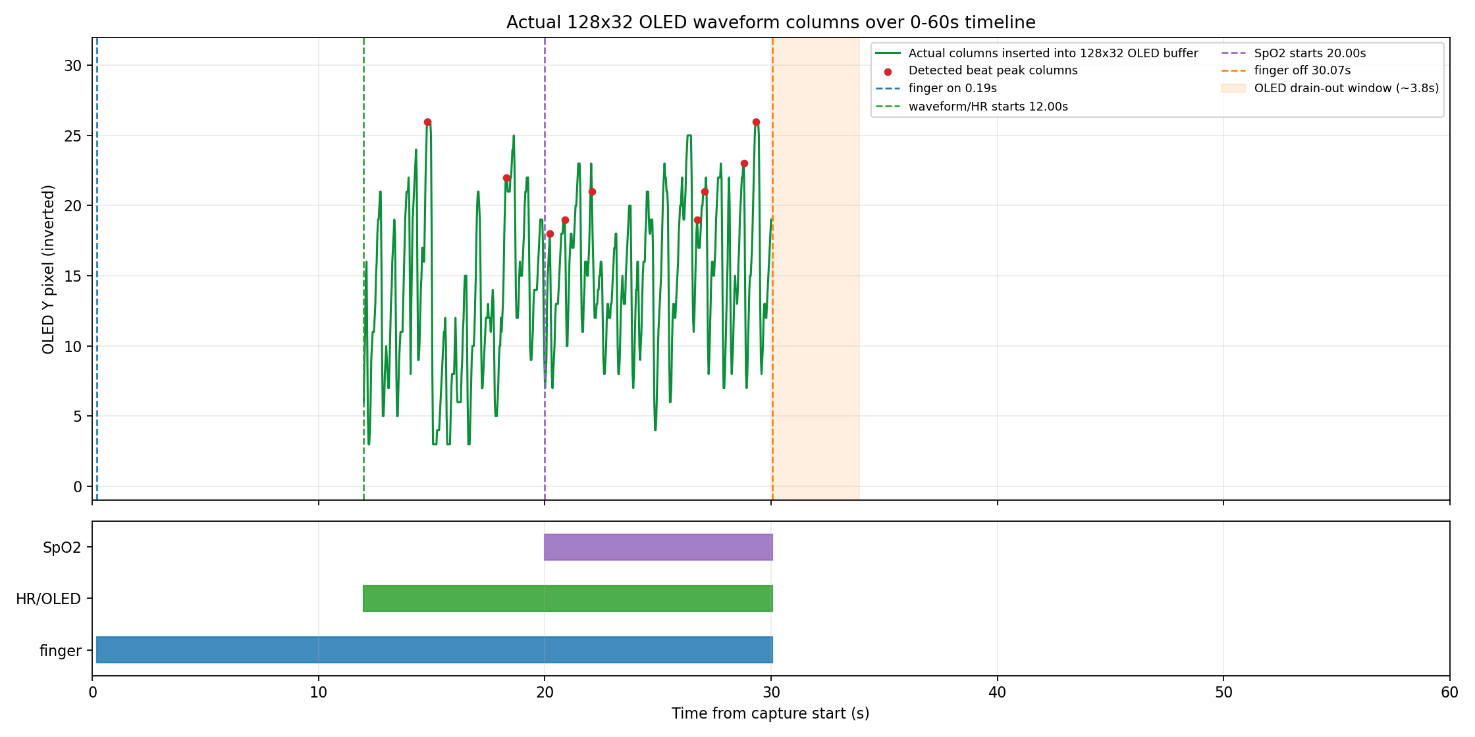
testing dataset/108_40秒实测波形绘图/waveform_oled_columns_timeline_0_60s.png
