BruceKe365/STM32F411-PPG-Pulse-Monitor/testing dataset/109_波形显示条件处理/waveform_oled_columns_conditioned_0_60s.png

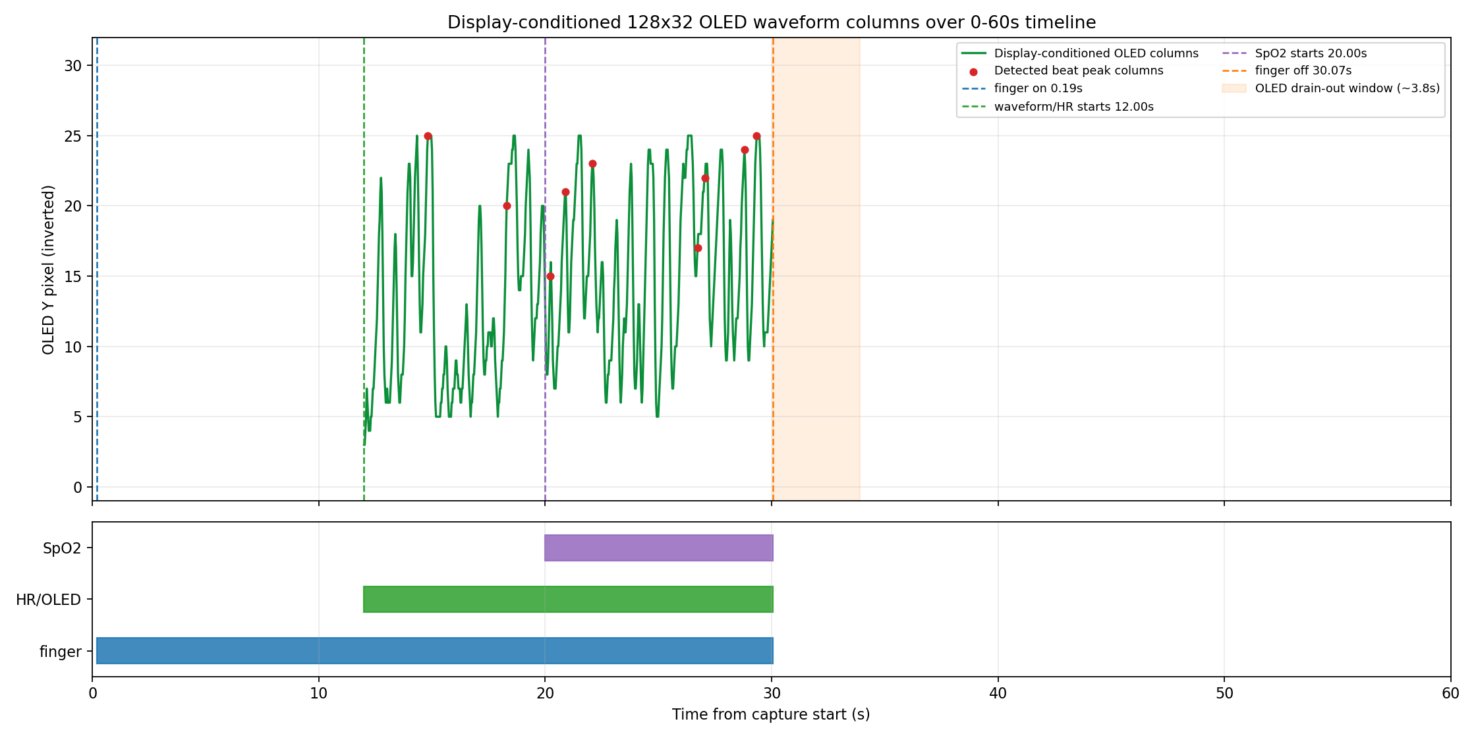
testing dataset/109_波形显示条件处理/waveform_oled_columns_conditioned_0_60s.png
