BruceKe365/STM32F411-PPG-Pulse-Monitor/(commit log)

2026-06-26 chore: prepare project handoff for release
    [01_no_finger_baseline_hr10_spo220_raw.csv, 01_no_finger_baseline_hr10_spo220_raw_events.csv, 01_no_finger_baseline_hr10_spo220_raw_processed.csv, 01_no_finger_baseline_warmup10_raw.csv, 01_no_finger_baseline_warmup10_raw_events.csv, 01_no_finger_baseline_warmup10_raw_processed.csv, 01_no_finger_baseline_warmup20_raw.csv, 01_no_finger_baseline_warmup20_raw_events.csv]
2026-06-29 fix: align firmware models reports and documentation
    [local_ppg_stress_index.csv, mcu_live_af_label_summary.csv, mcu_live_af_summary.csv, quality_gate_variant_summary.csv, quality_gate_variant_summary_compact.csv, stress_hrv_detail.csv, stress_hrv_file_summary.csv, stress_hrv_group_summary.csv]
2026-06-29 docs: fix README AF parameter list — separate HR display jump gate (25 bpm) from AF PPI-HR tolerance (18 bpm)
2026-07-26 fix: make consistency check portable across line endings
    [check_firmware_consistency.py]
2026-07-26 docs: add PCB Gerber fabrication packages
2026-07-26 refactor: flatten PCB release files
2026-07-26 docs: clarify Gerber fabrication package
2026-07-26 docs: add device running demonstration image
2026-07-26 docs: add device demo section
